Architeuthis-Flux/Jumperless/Hardware/Custom Breadboard/Images/Jumperless2boardOnFlipped.jpeg

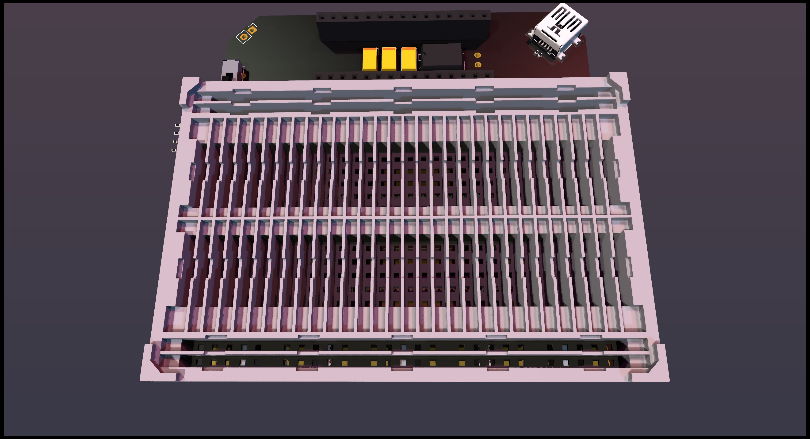
Hardware/Custom Breadboard/Images/Jumperless2boardOnFlipped.jpeg
