Architeuthis-Flux/Jumperless/Hardware/Custom Breadboard/Images/Jumperless2top.jpeg

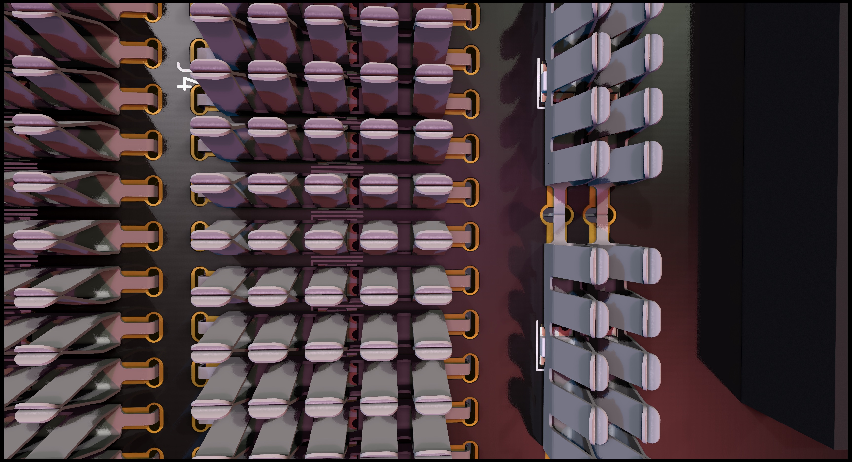
Hardware/Custom Breadboard/Images/Jumperless2top.jpeg
