Architeuthis-Flux/Jumperless/README.md

# Jumperless
### a jumperless breadboard

##### If you want one of these, they're available in [my Tindie store](https://www.tindie.com/products/architeuthisflux/jumperless/)

# There's now a way cooler version, [Jumperless V5](https://github.com/Architeuthis-Flux/JumperlessV5) 

#### You can get a V5 [on Crowd Supply](https://www.crowdsupply.com/architeuthis-flux/jumperless-v5)

## [Getting started using your Jumperless](https://hackaday.io/project/191238-jumperless/log/222858-getting-started-using-your-jumperless)
###### (at this point some of the stuff in that guide is a bit out of date, but generally is good advice)

Video (https://www.youtube.com/watch?v=_k0aKM68Xl4)

(You can click on this to watch the explainer video)

Using a bunch of analog crosspoint switches wired together into one bigger switch, this breadboard makes real, hardware connections between any points on the board or the Arduino Nano header at the top via software command, instead of needing to use jumper wires.

BreaboardJump00420

#### [3D Printable Stand](https://www.printables.com/model/684090-stand-for-the-jumperless-breadboard) (you can drop the model through the build plate to adjust the height)

#### [3D Printable Jumperless Trap](https://www.printables.com/model/1040448-jumperless-v1-3-case) (jk it's a carrying case, but make sure you can get it back open before you put your Jumperless in it)

Try this Wokwi project if something isn't working: https://wokwi.com/projects/389569655762010113

Here's an example of me using this thing to connect some I2C pins from an Arduino to an OLED

https://github.com/Architeuthis-Flux/Jumperless/assets/20519442/0da0fdcb-c629-4f16-8638-6fab5f5c69fc

Jumperless also has a ton of voltage/current sensing so the RGB LEDs underneath each row can show a ton of information about what's going on with your circuit. 2 buffered high-current DACs (one 0-5V and one ±8V), 4 buffered and level-shifted 12-bit ADCs (3 are 0-5V and 1 for ±8V), 2 INA219 current and voltage measurement ICs, and 4 GPIO to simulate digital or analog signals that can be routed to anywhere on the breadboard or the Arduino Nano header.

https://github.com/Architeuthis-Flux/Jumperless/assets/20519442/e701d5c8-2349-49a1-8d57-8574962e7c29

Use it to probe the pins on an unknown IC (which is what I'm doing in the video above), or for some automated fuzzing, or to help guide you through converting a schematic to a real circuit, or do whatever the hell you want with it. 

TxRx00097-Edit

The connections are real and fully analog (-8V to +8V, up to around 1 MHz before signal quality starts to degrade) instead of cheating with some measure-then-simulate setup, although you can do that too if you want to simulate a [memristor](https://en.wikipedia.org/wiki/Memristor) or to send jumpers over the internet.

https://github.com/Architeuthis-Flux/Jumperless/assets/20519442/2c203686-e02e-4a0c-b5eb-0cab925386fb

### If you want to read about how the code and stuff works, [the README in JumperlessNano](https://github.com/Architeuthis-Flux/Jumperless/tree/main/JumperlessNano) goes through how each part works in more detail.

### Or check out the [Hackaday.io page](https://hackaday.io/project/191238-jumperless) and the [Hackaday Blog Writeup](https://hackaday.com/2023/08/25/hackaday-prize-2023-jumperless-the-jumperless-jumperboard/)

And no, it's not an FPGA.



Schematic

Here it is running a 555 circuit (note that this is a Rev 1 without the through-PCB LEDs)

https://github.com/Architeuthis-Flux/Jumperless/assets/20519442/9c5d2b5a-3727-4197-b1d0-bd45b5f95559



Here are some fun bonus shots
RainBounceLarge

RandomLarge

https://github.com/Architeuthis-Flux/Jumperless/assets/20519442/b933e817-c6e4-4d97-9fc0-7b8d9e875ebb
[SchematicRevision3.pdf](https://github.com/Architeuthis-Flux/Jumperless/files/12603152/SchematicRevision3.pdf)


usage

https://github.com/Architeuthis-Flux/Jumperless/assets/20519442/d070d99d-b6b3-43e3-adee-4ca2d7358a9a
