Architeuthis-Flux/Jumperless/Hardware/Packaging/InsideBox575sm.pdf

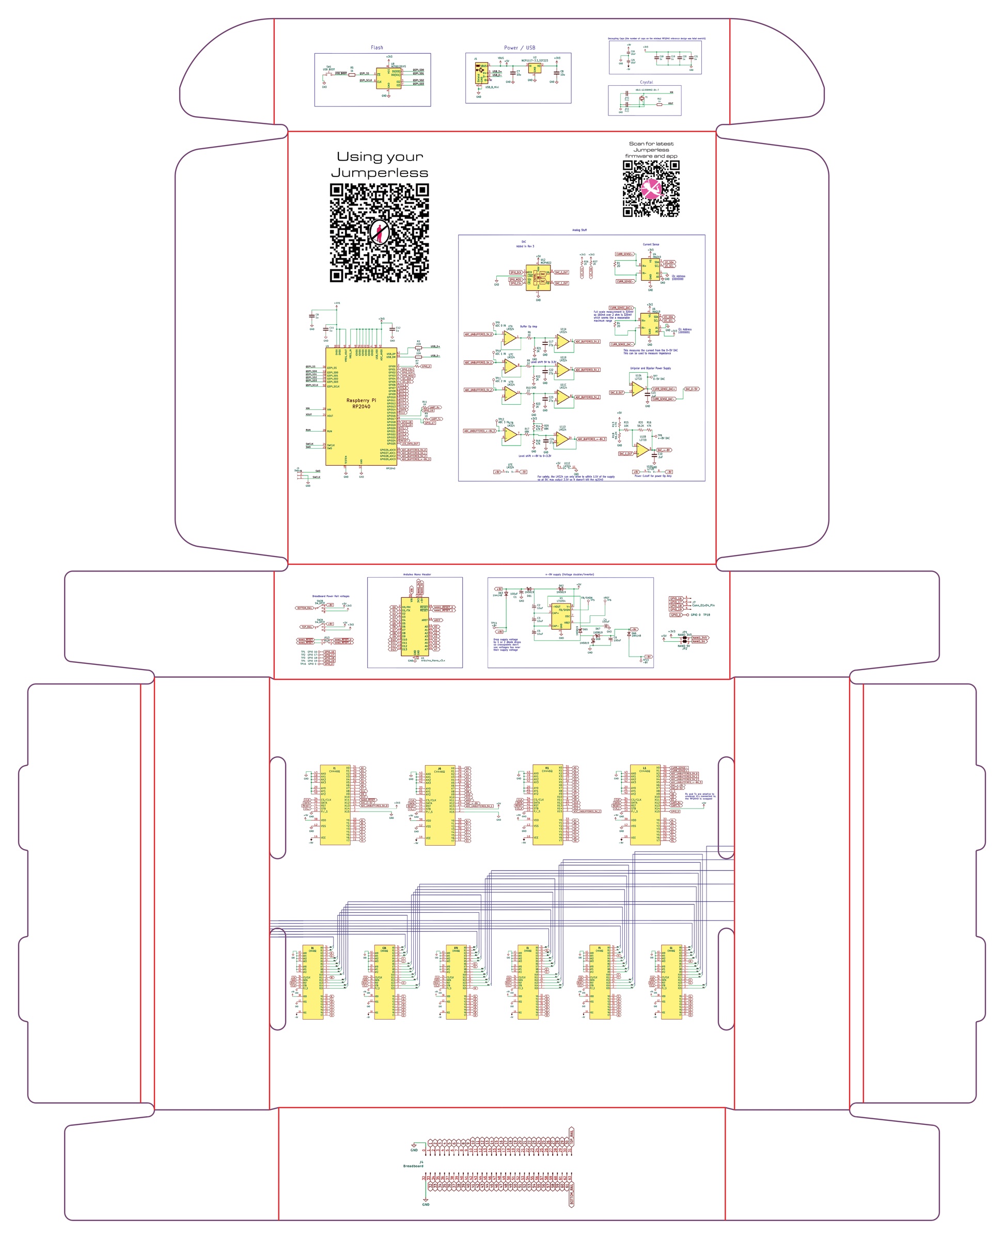
[picture p3: page 1]
