Architeuthis-Flux/Jumperless/Hardware/Packaging/outsideBox575sm.pdf

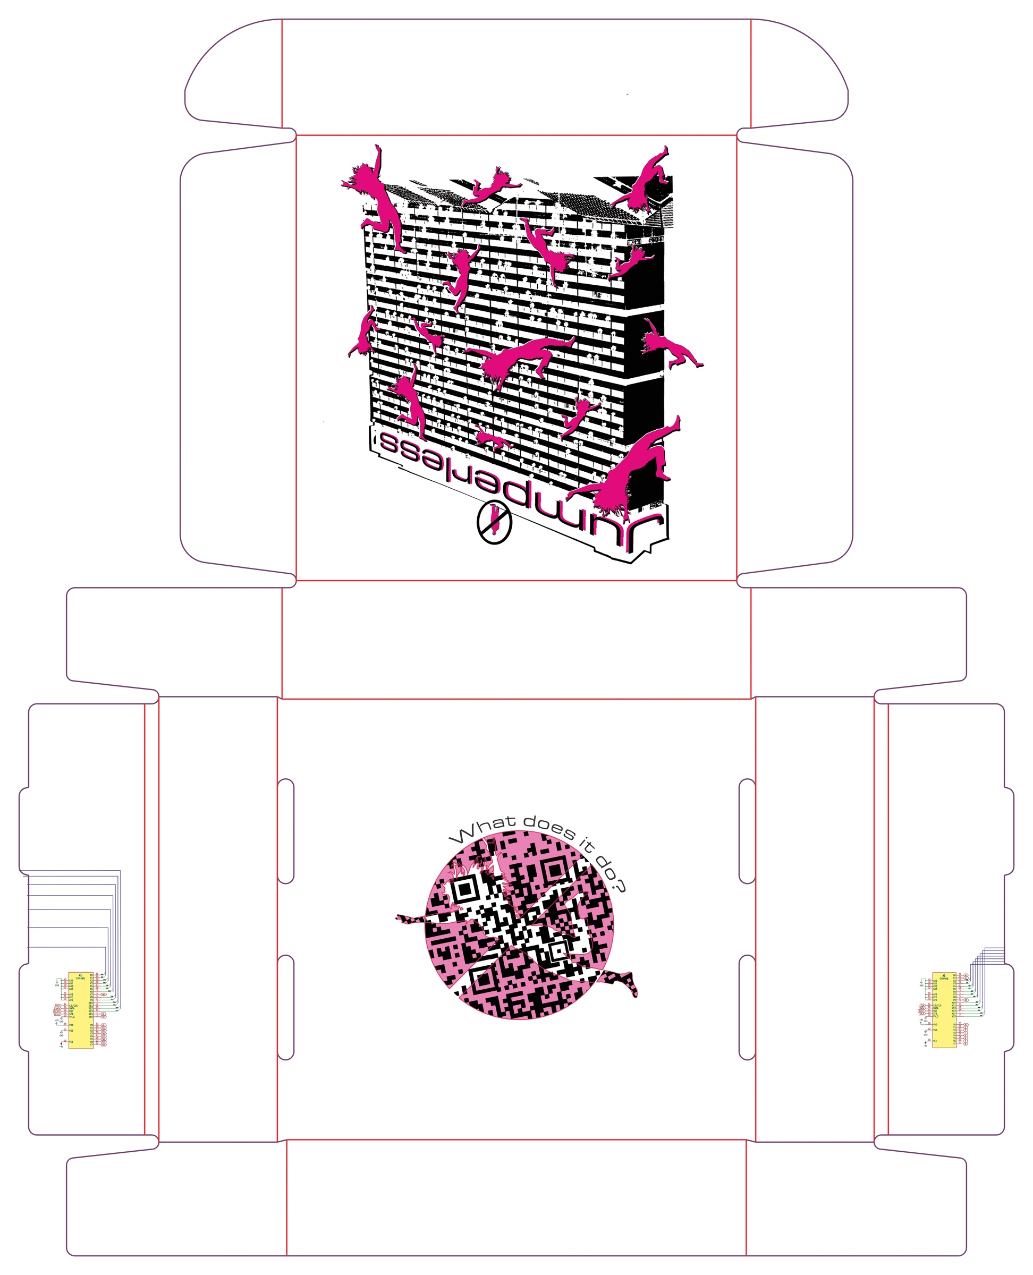
[picture p4: page 1]
