Architeuthis-Flux/Jumperless/Hardware/Custom Breadboard/Images/bbSimple v4 front.png

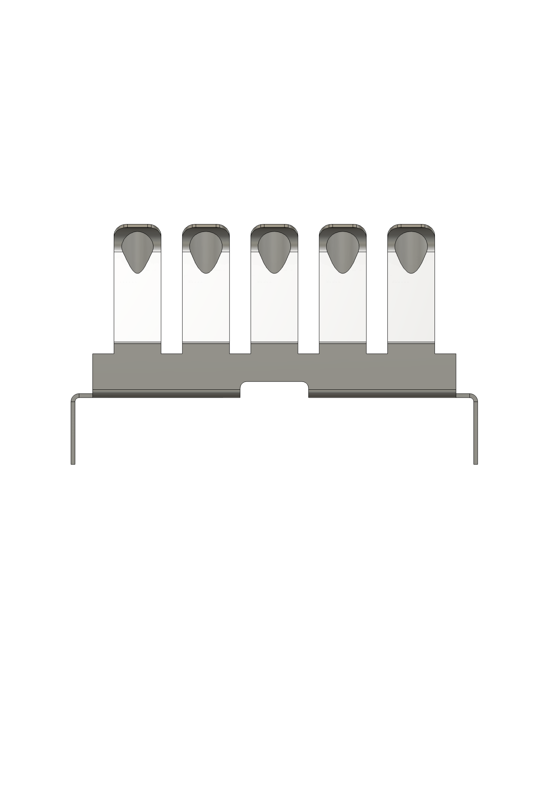
Hardware/Custom Breadboard/Images/bbSimple v4 front.png
