Architeuthis-Flux/Jumperless/Hardware/Custom Breadboard/Images/bbSimple v4 top.png

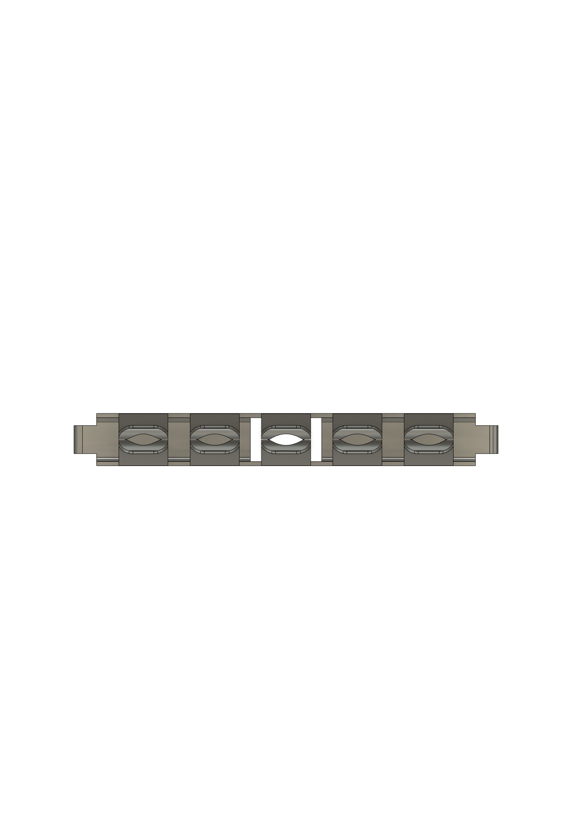
Hardware/Custom Breadboard/Images/bbSimple v4 top.png
