Architeuthis-Flux/Jumperless/Hardware/Custom Breadboard/Images/bbSimple v4.png

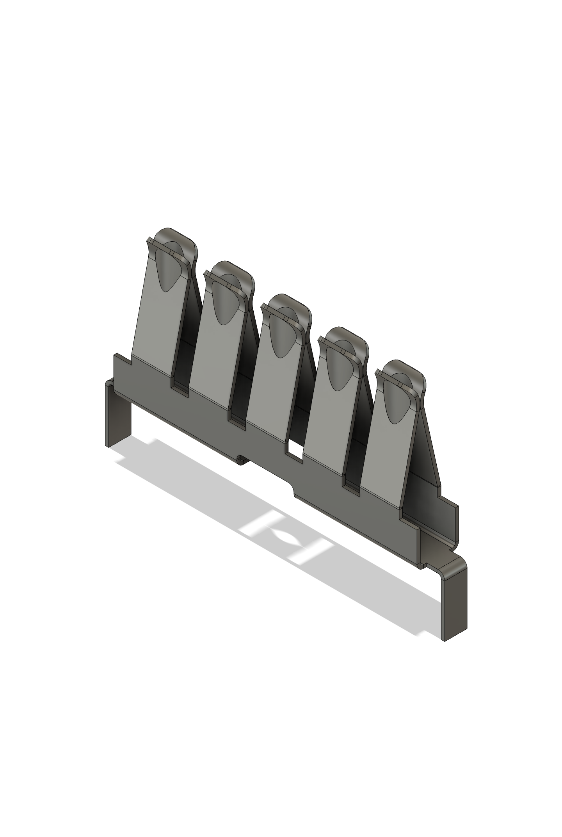
Hardware/Custom Breadboard/Images/bbSimple v4.png
