Architeuthis-Flux/Jumperless/Hardware/Custom Breadboard/Images/bbSimple v4right.png

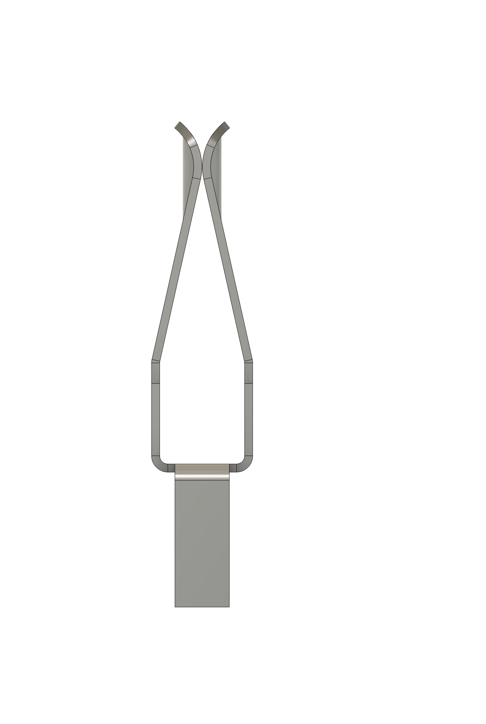
Hardware/Custom Breadboard/Images/bbSimple v4right.png
