Architeuthis-Flux/Jumperless/Hardware/Custom Breadboard/Images/Jumperless2.jpeg

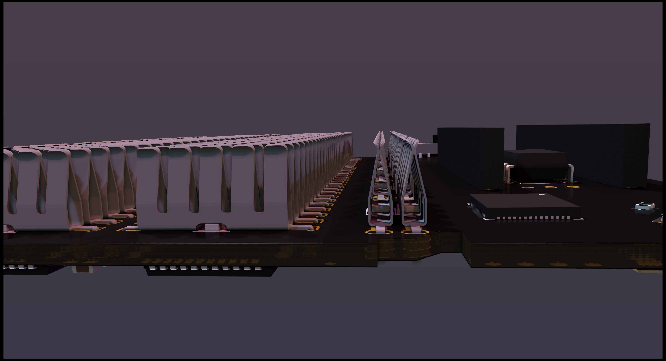
Hardware/Custom Breadboard/Images/Jumperless2.jpeg
