Architeuthis-Flux/Jumperless/Hardware/Custom Breadboard/Images/Jumperless2boardOn.jpeg

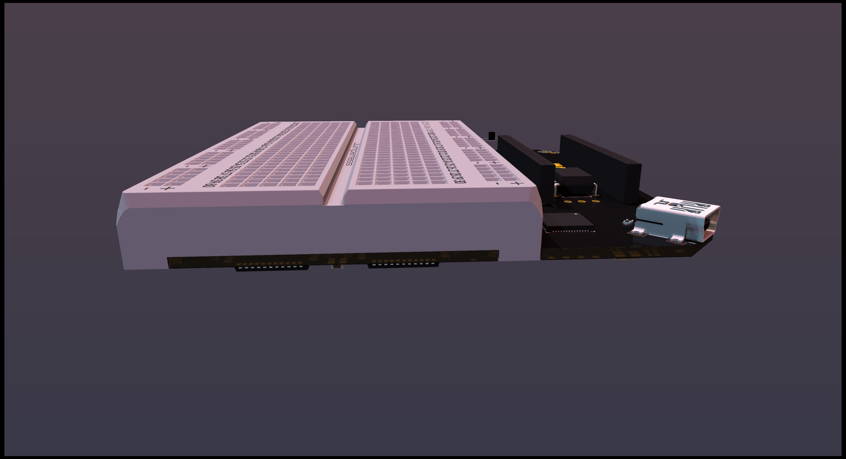
Hardware/Custom Breadboard/Images/Jumperless2boardOn.jpeg
