Architeuthis-Flux/Jumperless/Hardware/Rev3Plots/Main Board 3point1/PlacementBOMposNetlist/BackPlacement 2.png

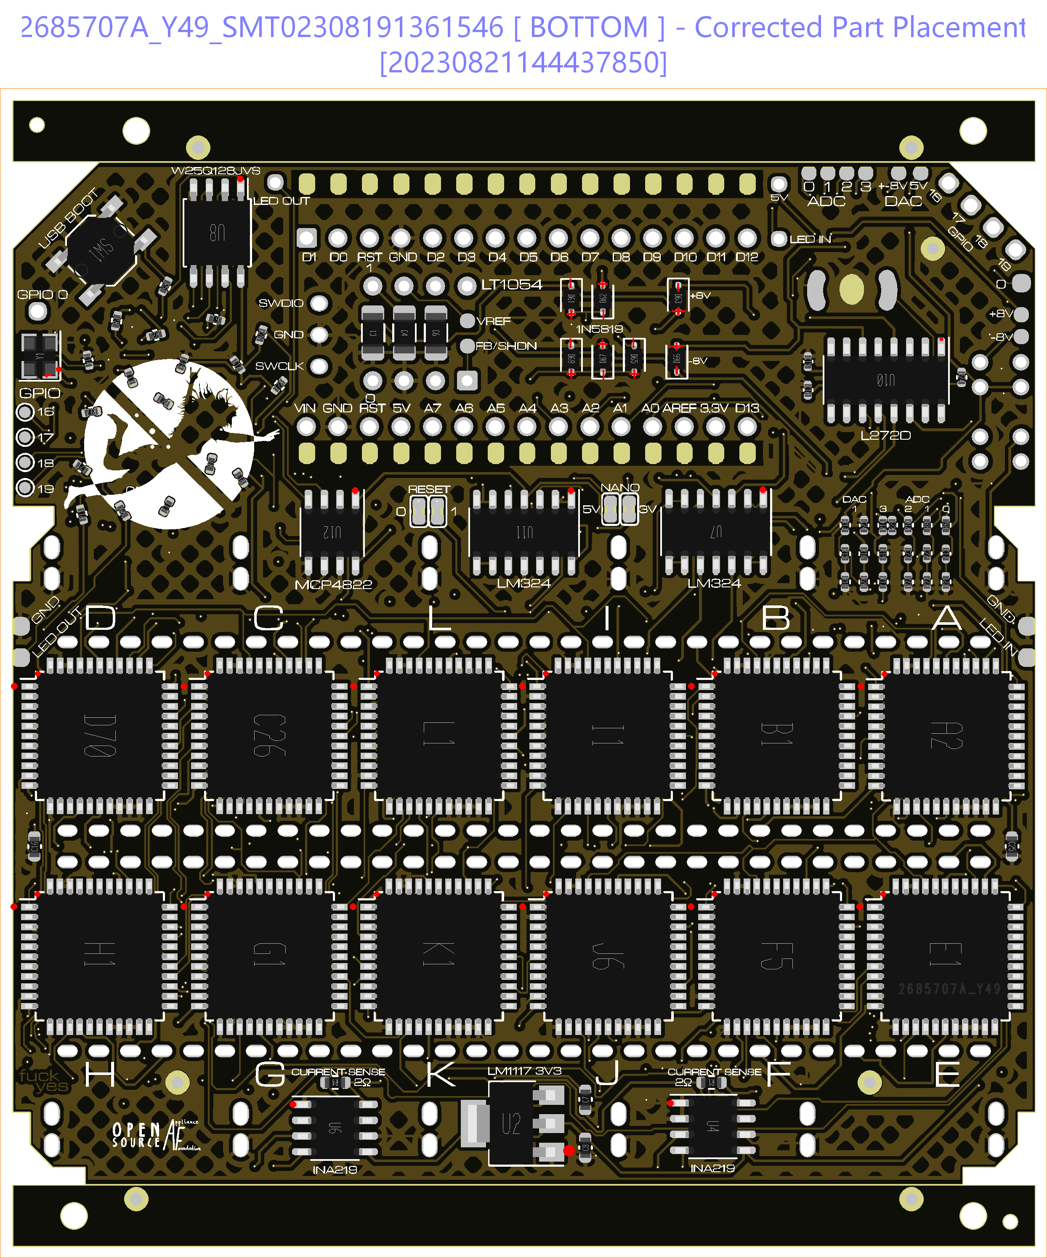
Hardware/Rev3Plots/Main Board 3point1/PlacementBOMposNetlist/BackPlacement 2.png
