Architeuthis-Flux/Jumperless/Hardware/KiCAD/LED Board Rev 3/LEDboardRev3.step

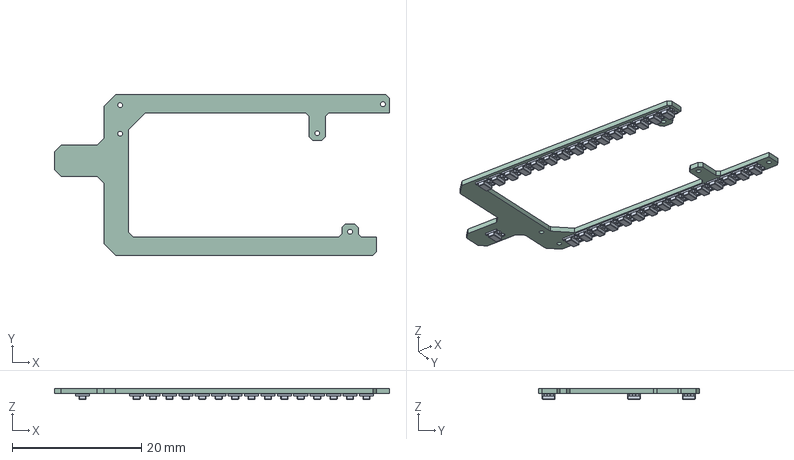
[picture p13: CAD file, 2023-06-24]
Hardware/KiCAD/LED Board Rev 3/LEDboardRev3.step
51.8 x 24.8 x 1.67 mm
_autosave-JumperlessLEDboard PCB
