Architeuthis-Flux/Jumperless/Hardware/KiCAD/Symbols and Footprints/3dmodels/bbSimple v8.step

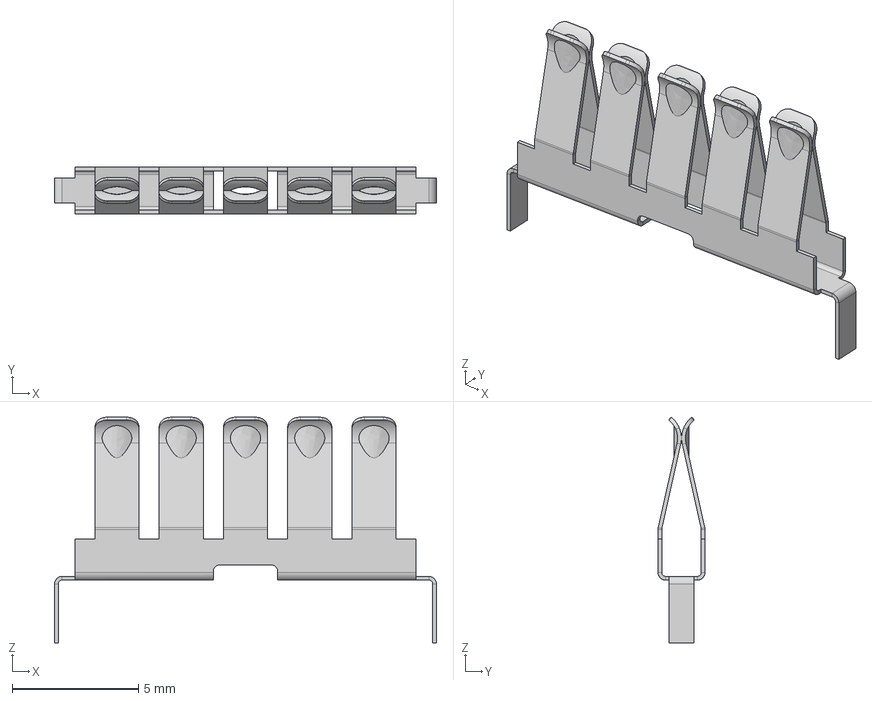
[picture p14: CAD file, 2024-02-24]
Hardware/KiCAD/Symbols and Footprints/3dmodels/bbSimple v8.step
15.1 x 1.86 x 8.92 mm
