Architeuthis-Flux/Jumperless/Hardware/Custom Breadboard/BBclipsNEW/bbSimple v20.step

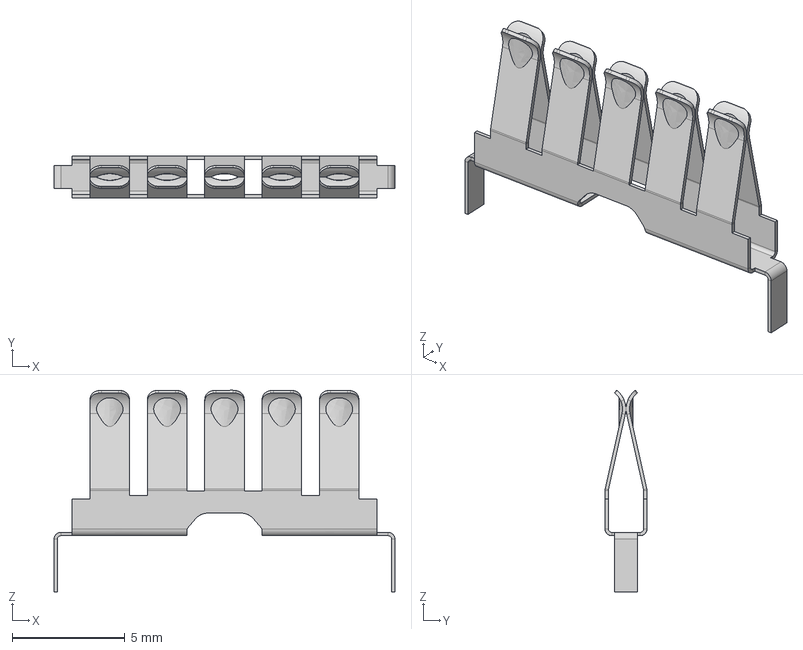
[picture p15: CAD file, 2023-06-24]
Hardware/Custom Breadboard/BBclipsNEW/bbSimple v20.step
15.1 x 1.86 x 8.92 mm
