Architeuthis-Flux/Jumperless/Hardware/KiCAD/Symbols and Footprints/3dmodels/SSSS223600.step

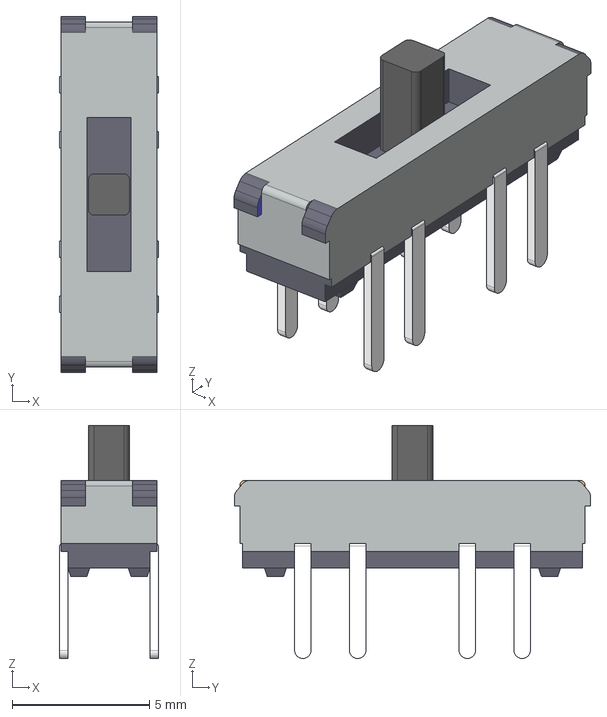
[picture p16: CAD file, 2024-02-24]
Hardware/KiCAD/Symbols and Footprints/3dmodels/SSSS223600.step
3.60 x 13.0 x 8.50 mm
