Architeuthis-Flux/Jumperless/Hardware/KiCAD/Symbols and Footprints/3dmodels/WS2812C-2020_Color.step

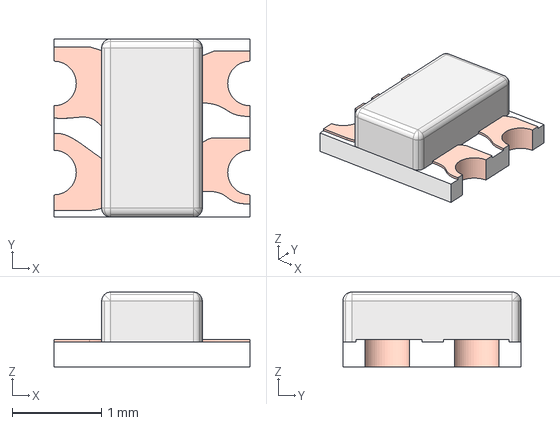
[picture p17: CAD file, 2024-02-24]
Hardware/KiCAD/Symbols and Footprints/3dmodels/WS2812C-2020_Color.step
2.20 x 2.00 x 0.84 mm
ws2812c-2020 v2.step
ws2812c-2020 v2
