Architeuthis-Flux/Jumperless/Hardware/KiCAD/Symbols and Footprints/3dmodels/PEC11R-4215F-S0024--3DModel-STEP-56544.STEP

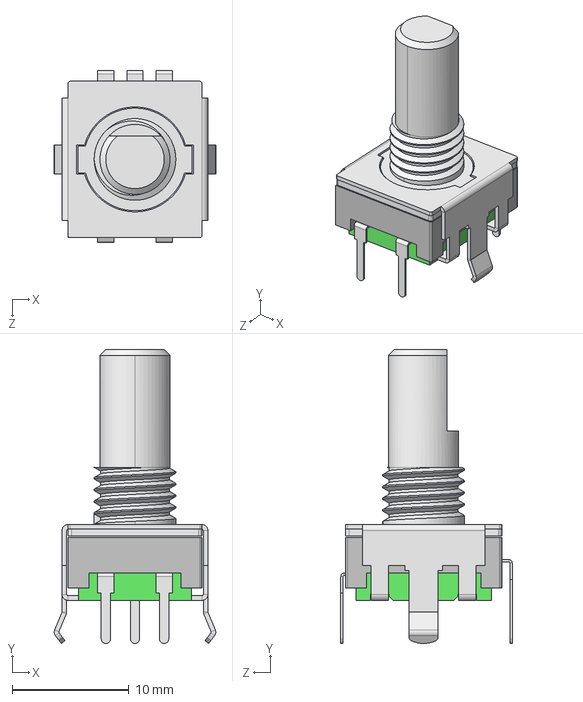
[picture p18: CAD file, 2024-02-24]
Hardware/KiCAD/Symbols and Footprints/3dmodels/PEC11R-4215F-S0024--3DModel-STEP-56544.STEP
13.9 x 25.2 x 14.7 mm
