Architeuthis-Flux/Jumperless/(list of files, cad)

Other CAD files:
Hardware/Custom Breadboard/BBclipsNEW/bbNew.dxf
Hardware/KiCAD/Symbols and Footprints/3dmodels/bbSimple v1.step
Hardware/Custom Breadboard/BBclipsNEW/bbSimple v20.stl
