Architeuthis-Flux/Jumperless/Jumperless_Wokwi_Bridge_App/Windows/pyInstallerscriptforWindows.txt

python3 -m PyInstaller --icon="icon.ico" -F -y --console --add-binary ""C:\Users\arabi\OneDrive\Desktop\JumperlessWokwiBridge2\windows\arduino-cli.exe";." JumperlessWokwiBridge.py
