Architeuthis-Flux/Jumperless/Jumperless_Wokwi_Bridge_App/JumperlessWokwiBridge/build/jumperlesswokwibridge/xref-jumperlesswokwibridge.html

# modulegraph cross reference for JumperlessWokwiBridge.py, pyi_rth_inspect.py, pyi_rth_multiprocessing.py, pyi_rth_pkgutil.py

JumperlessWokwiBridge.py Script

imports: _collections_abc • _weakrefset • abc • bs4 • codecs • collections • collections.abc • copyreg • encodings • encodings.aliases • encodings.ascii • encodings.base64_codec • encodings.big5 • encodings.big5hkscs • encodings.bz2_codec • encodings.charmap • encodings.cp037 • encodings.cp1006 • encodings.cp1026 • encodings.cp1125 • encodings.cp1140 • encodings.cp1250 • encodings.cp1251 • encodings.cp1252 • encodings.cp1253 • encodings.cp1254 • encodings.cp1255 • encodings.cp1256 • encodings.cp1257 • encodings.cp1258 • encodings.cp273 • encodings.cp424 • encodings.cp437 • encodings.cp500 • encodings.cp720 • encodings.cp737 • encodings.cp775 • encodings.cp850 • encodings.cp852 • encodings.cp855 • encodings.cp856 • encodings.cp857 • encodings.cp858 • encodings.cp860 • encodings.cp861 • encodings.cp862 • encodings.cp863 • encodings.cp864 • encodings.cp865 • encodings.cp866 • encodings.cp869 • encodings.cp874 • encodings.cp875 • encodings.cp932 • encodings.cp949 • encodings.cp950 • encodings.euc_jis_2004 • encodings.euc_jisx0213 • encodings.euc_jp • encodings.euc_kr • encodings.gb18030 • encodings.gb2312 • encodings.gbk • encodings.hex_codec • encodings.hp_roman8 • encodings.hz • encodings.idna • encodings.iso2022_jp • encodings.iso2022_jp_1 • encodings.iso2022_jp_2 • encodings.iso2022_jp_2004 • encodings.iso2022_jp_3 • encodings.iso2022_jp_ext • encodings.iso2022_kr • encodings.iso8859_1 • encodings.iso8859_10 • encodings.iso8859_11 • encodings.iso8859_13 • encodings.iso8859_14 • encodings.iso8859_15 • encodings.iso8859_16 • encodings.iso8859_2 • encodings.iso8859_3 • encodings.iso8859_4 • encodings.iso8859_5 • encodings.iso8859_6 • encodings.iso8859_7 • encodings.iso8859_8 • encodings.iso8859_9 • encodings.johab • encodings.koi8_r • encodings.koi8_t • encodings.koi8_u • encodings.kz1048 • encodings.latin_1 • encodings.mac_arabic • encodings.mac_croatian • encodings.mac_cyrillic • encodings.mac_farsi • encodings.mac_greek • encodings.mac_iceland • encodings.mac_latin2 • encodings.mac_roman • encodings.mac_romanian • encodings.mac_turkish • encodings.mbcs • encodings.oem • encodings.palmos • encodings.ptcp154 • encodings.punycode • encodings.quopri_codec • encodings.raw_unicode_escape • encodings.rot_13 • encodings.shift_jis • encodings.shift_jis_2004 • encodings.shift_jisx0213 • encodings.tis_620 • encodings.undefined • encodings.unicode_escape • encodings.utf_16 • encodings.utf_16_be • encodings.utf_16_le • encodings.utf_32 • encodings.utf_32_be • encodings.utf_32_le • encodings.utf_7 • encodings.utf_8 • encodings.utf_8_sig • encodings.uu_codec • encodings.zlib_codec • enum • fnmatch • functools • genericpath • heapq • io • ipaddress • json • keyword • linecache • locale • ntpath • operator • os • pathlib • posixpath • psutil • pyduinocli • pyi_rth_inspect.py • pyi_rth_multiprocessing.py • pyi_rth_pkgutil.py • re • re._casefix • re._compiler • re._constants • re._parser • reprlib • requests • serial • serial.tools.list_ports • shutil • sre_compile • sre_constants • sre_parse • stat • sys • threading • time • token • tokenize • traceback • types • urllib • urllib.error • urllib.parse • urllib.request • urllib.response • urllib.robotparser • warnings • weakref

pyi_rth_inspect.py Script

imports: inspect • os • sys

imported by: JumperlessWokwiBridge.py

pyi_rth_multiprocessing.py Script

imports: multiprocessing • multiprocessing.popen_forkserver • multiprocessing.popen_spawn_posix • multiprocessing.popen_spawn_win32 • multiprocessing.spawn • os • subprocess • sys • threading

imported by: JumperlessWokwiBridge.py

pyi_rth_pkgutil.py Script

imports: os • pkgutil • pyimod02_importers • sys

imported by: JumperlessWokwiBridge.py

'OpenSSL.crypto' MissingModule

imported by: urllib3.contrib.pyopenssl

'System.IO' MissingModule

imported by: serial.serialcli

'cryptography.x509' MissingModule

imported by: urllib3.contrib.pyopenssl

'html5lib.constants' MissingModule

imported by: bs4.builder._html5lib

'html5lib.treebuilders' MissingModule

imported by: bs4.builder._html5lib • lxml.html._html5builder • lxml.html.html5parser

'java.lang' MissingModule

imported by: platform • xml.sax._exceptions

'org.python' MissingModule

imported by: pickle • xml.sax

BeautifulSoup MissingModule

imported by: lxml.html.soupparser

OpenSSL MissingModule

imported by: urllib3.contrib.pyopenssl

System MissingModule

imported by: serial.serialcli

__future__ SourceModule

imported by: codeop • doctest • lxml.cssselect • lxml.html • lxml.html._diffcommand • psutil • psutil._common • psutil._pslinux • pydoc • serial • serial.serialcli • serial.serialjava • serial.serialposix • serial.serialutil • serial.serialwin32 • serial.tools.list_ports • serial.tools.list_ports_common • serial.tools.list_ports_linux • serial.tools.list_ports_osx • serial.tools.list_ports_posix • serial.tools.list_ports_windows • serial.win32 • soupsieve • soupsieve.__meta__ • soupsieve.css_match • soupsieve.css_parser • soupsieve.css_types • soupsieve.pretty • soupsieve.util • urllib3 • urllib3._base_connection • urllib3._collections • urllib3._request_methods • urllib3._version • urllib3.connection • urllib3.connectionpool • urllib3.contrib.pyopenssl • urllib3.contrib.socks • urllib3.exceptions • urllib3.fields • urllib3.filepost • urllib3.poolmanager • urllib3.response • urllib3.util • urllib3.util.connection • urllib3.util.proxy • urllib3.util.request • urllib3.util.response • urllib3.util.retry • urllib3.util.ssl_ • urllib3.util.ssl_match_hostname • urllib3.util.ssltransport • urllib3.util.timeout • urllib3.util.url • urllib3.util.util • urllib3.util.wait

_abc (builtin module)

imported by: abc

_aix_support SourceModule

imports: _bootsubprocess • subprocess • sys • sysconfig

imported by: sysconfig

_ast (builtin module)

imported by: ast

_asyncio /Library/Frameworks/Python.framework/Versions/3.11/lib/python3.11/lib-dynload/_asyncio.cpython-311-darwin.so

imported by: asyncio.events • asyncio.futures • asyncio.tasks

_bisect /Library/Frameworks/Python.framework/Versions/3.11/lib/python3.11/lib-dynload/_bisect.cpython-311-darwin.so

imported by: bisect

_blake2 /Library/Frameworks/Python.framework/Versions/3.11/lib/python3.11/lib-dynload/_blake2.cpython-311-darwin.so

imported by: hashlib

_bootsubprocess SourceModule

imports: os

imported by: _aix_support

_bz2 /Library/Frameworks/Python.framework/Versions/3.11/lib/python3.11/lib-dynload/_bz2.cpython-311-darwin.so

imported by: bz2

_codecs (builtin module)

imported by: codecs

_codecs_cn /Library/Frameworks/Python.framework/Versions/3.11/lib/python3.11/lib-dynload/_codecs_cn.cpython-311-darwin.so

imported by: encodings.gb18030 • encodings.gb2312 • encodings.gbk • encodings.hz

_codecs_hk /Library/Frameworks/Python.framework/Versions/3.11/lib/python3.11/lib-dynload/_codecs_hk.cpython-311-darwin.so

imported by: encodings.big5hkscs

_codecs_iso2022 /Library/Frameworks/Python.framework/Versions/3.11/lib/python3.11/lib-dynload/_codecs_iso2022.cpython-311-darwin.so

imported by: encodings.iso2022_jp • encodings.iso2022_jp_1 • encodings.iso2022_jp_2 • encodings.iso2022_jp_2004 • encodings.iso2022_jp_3 • encodings.iso2022_jp_ext • encodings.iso2022_kr

_codecs_jp /Library/Frameworks/Python.framework/Versions/3.11/lib/python3.11/lib-dynload/_codecs_jp.cpython-311-darwin.so

imported by: encodings.cp932 • encodings.euc_jis_2004 • encodings.euc_jisx0213 • encodings.euc_jp • encodings.shift_jis • encodings.shift_jis_2004 • encodings.shift_jisx0213

_codecs_kr /Library/Frameworks/Python.framework/Versions/3.11/lib/python3.11/lib-dynload/_codecs_kr.cpython-311-darwin.so

imported by: encodings.cp949 • encodings.euc_kr • encodings.johab

_codecs_tw /Library/Frameworks/Python.framework/Versions/3.11/lib/python3.11/lib-dynload/_codecs_tw.cpython-311-darwin.so

imported by: encodings.big5 • encodings.cp950

_collections (builtin module)

imported by: collections • threading

_collections_abc SourceModule

imports: abc • sys

imported by: JumperlessWokwiBridge.py • collections • collections.abc • contextlib • locale • os • pathlib • random • types • weakref

_compat_pickle SourceModule

imported by: _pickle • pickle

_compression SourceModule

imports: io • sys

imported by: bz2 • gzip • lzma

_contextvars /Library/Frameworks/Python.framework/Versions/3.11/lib/python3.11/lib-dynload/_contextvars.cpython-311-darwin.so

imported by: contextvars

_csv /Library/Frameworks/Python.framework/Versions/3.11/lib/python3.11/lib-dynload/_csv.cpython-311-darwin.so

imported by: csv

_ctypes /Library/Frameworks/Python.framework/Versions/3.11/lib/python3.11/lib-dynload/_ctypes.cpython-311-darwin.so

imported by: ctypes

_curses /Library/Frameworks/Python.framework/Versions/3.11/lib/python3.11/lib-dynload/_curses.cpython-311-darwin.so

imports: curses

imported by: curses • curses.has_key

_datetime /Library/Frameworks/Python.framework/Versions/3.11/lib/python3.11/lib-dynload/_datetime.cpython-311-darwin.so

imports: _strptime • time

imported by: datetime

_decimal /Library/Frameworks/Python.framework/Versions/3.11/lib/python3.11/lib-dynload/_decimal.cpython-311-darwin.so

imported by: decimal

_elementtree /Library/Frameworks/Python.framework/Versions/3.11/lib/python3.11/lib-dynload/_elementtree.cpython-311-darwin.so

imports: pyexpat • xml.etree.ElementInclude • xml.etree.ElementPath • xml.etree.ElementTree • xml.etree.cElementTree

imported by: xml.etree.ElementTree

_frozen_importlib ExcludedModule

imported by: importlib • importlib.abc • zipimport

_frozen_importlib_external MissingModule

imported by: importlib • importlib._bootstrap • importlib.abc • zipimport

_functools (builtin module)

imported by: functools

_hashlib /Library/Frameworks/Python.framework/Versions/3.11/lib/python3.11/lib-dynload/_hashlib.cpython-311-darwin.so

imported by: hashlib • hmac

_heapq /Library/Frameworks/Python.framework/Versions/3.11/lib/python3.11/lib-dynload/_heapq.cpython-311-darwin.so

imported by: heapq

_imp (builtin module)

imported by: importlib • importlib._bootstrap_external • importlib.util • sysconfig • zipimport

_io (builtin module)

imported by: importlib._bootstrap_external • io • zipimport

_json /Library/Frameworks/Python.framework/Versions/3.11/lib/python3.11/lib-dynload/_json.cpython-311-darwin.so

imports: json.decoder

imported by: json.decoder • json.encoder • json.scanner

_locale (builtin module)

imported by: locale

_lzma /Library/Frameworks/Python.framework/Versions/3.11/lib/python3.11/lib-dynload/_lzma.cpython-311-darwin.so

imported by: lzma

_markupbase SourceModule

imports: re

imported by: html.parser

_md5 /Library/Frameworks/Python.framework/Versions/3.11/lib/python3.11/lib-dynload/_md5.cpython-311-darwin.so

imported by: hashlib

_multibytecodec /Library/Frameworks/Python.framework/Versions/3.11/lib/python3.11/lib-dynload/_multibytecodec.cpython-311-darwin.so

imported by: charset_normalizer.utils • encodings.big5 • encodings.big5hkscs • encodings.cp932 • encodings.cp949 • encodings.cp950 • encodings.euc_jis_2004 • encodings.euc_jisx0213 • encodings.euc_jp • encodings.euc_kr • encodings.gb18030 • encodings.gb2312 • encodings.gbk • encodings.hz • encodings.iso2022_jp • encodings.iso2022_jp_1 • encodings.iso2022_jp_2 • encodings.iso2022_jp_2004 • encodings.iso2022_jp_3 • encodings.iso2022_jp_ext • encodings.iso2022_kr • encodings.johab • encodings.shift_jis • encodings.shift_jis_2004 • encodings.shift_jisx0213

_multiprocessing /Library/Frameworks/Python.framework/Versions/3.11/lib/python3.11/lib-dynload/_multiprocessing.cpython-311-darwin.so

imported by: multiprocessing.connection • multiprocessing.queues • multiprocessing.resource_tracker • multiprocessing.synchronize

_opcode /Library/Frameworks/Python.framework/Versions/3.11/lib/python3.11/lib-dynload/_opcode.cpython-311-darwin.so

imported by: opcode

_operator (builtin module)

imported by: hmac • operator

_osx_support SourceModule

imports: contextlib • os • re • sys • tempfile

imported by: sysconfig

_overlapped MissingModule

imported by: asyncio.windows_events

_pickle /Library/Frameworks/Python.framework/Versions/3.11/lib/python3.11/lib-dynload/_pickle.cpython-311-darwin.so

imports: _compat_pickle • codecs • copyreg

imported by: pickle

_posixshmem /Library/Frameworks/Python.framework/Versions/3.11/lib/python3.11/lib-dynload/_posixshmem.cpython-311-darwin.so

imported by: multiprocessing.resource_tracker • multiprocessing.shared_memory

_posixsubprocess /Library/Frameworks/Python.framework/Versions/3.11/lib/python3.11/lib-dynload/_posixsubprocess.cpython-311-darwin.so

imports: gc

imported by: multiprocessing.util • subprocess

_psutil_windows MissingModule

imported by: psutil._pswindows

_py_abc SourceModule

imports: _weakrefset

imported by: abc

_pydecimal SourceModule

imports: collections • contextvars • itertools • locale • math • numbers • re • sys

imported by: decimal

_queue /Library/Frameworks/Python.framework/Versions/3.11/lib/python3.11/lib-dynload/_queue.cpython-311-darwin.so

imported by: queue

_random /Library/Frameworks/Python.framework/Versions/3.11/lib/python3.11/lib-dynload/_random.cpython-311-darwin.so

imported by: random

_scproxy /Library/Frameworks/Python.framework/Versions/3.11/lib/python3.11/lib-dynload/_scproxy.cpython-311-darwin.so

imported by: urllib.request

_sha1 /Library/Frameworks/Python.framework/Versions/3.11/lib/python3.11/lib-dynload/_sha1.cpython-311-darwin.so

imported by: hashlib

_sha256 /Library/Frameworks/Python.framework/Versions/3.11/lib/python3.11/lib-dynload/_sha256.cpython-311-darwin.so

imported by: hashlib

_sha3 /Library/Frameworks/Python.framework/Versions/3.11/lib/python3.11/lib-dynload/_sha3.cpython-311-darwin.so

imported by: hashlib

_sha512 /Library/Frameworks/Python.framework/Versions/3.11/lib/python3.11/lib-dynload/_sha512.cpython-311-darwin.so

imported by: hashlib • random

_signal (builtin module)

imported by: signal

_socket /Library/Frameworks/Python.framework/Versions/3.11/lib/python3.11/lib-dynload/_socket.cpython-311-darwin.so

imported by: socket

_sre (builtin module)

imports: copy • re

imported by: re._compiler • re._constants

_ssl /Library/Frameworks/Python.framework/Versions/3.11/lib/python3.11/lib-dynload/_ssl.cpython-311-darwin.so

imports: socket

imported by: ssl

_stat (builtin module)

imported by: stat

_statistics /Library/Frameworks/Python.framework/Versions/3.11/lib/python3.11/lib-dynload/_statistics.cpython-311-darwin.so

imported by: statistics

_string (builtin module)

imported by: string

_strptime SourceModule

imports: _thread • calendar • datetime • locale • re • time

imported by: _datetime • datetime • time

_struct /Library/Frameworks/Python.framework/Versions/3.11/lib/python3.11/lib-dynload/_struct.cpython-311-darwin.so

imported by: struct

_sysconfigdata__darwin_darwin SourceModule

imported by: sysconfig

_thread (builtin module)

imported by: _strptime • asyncio.base_futures • dataclasses • functools • reprlib • tempfile • threading

_threading_local SourceModule

imports: contextlib • threading • weakref

imported by: threading

_tokenize (builtin module)

imported by: tokenize

_tracemalloc (builtin module)

imported by: tracemalloc

_typing /Library/Frameworks/Python.framework/Versions/3.11/lib/python3.11/lib-dynload/_typing.cpython-311-darwin.so

imported by: typing

_warnings (builtin module)

imported by: importlib._bootstrap_external • warnings • zipimport

_weakref (builtin module)

imported by: _weakrefset • collections • weakref • xml.sax.expatreader

_weakrefset SourceModule

imports: _weakref • types

imported by: JumperlessWokwiBridge.py • _py_abc • multiprocessing.process • threading • weakref

_winapi MissingModule

imported by: asyncio.windows_events • asyncio.windows_utils • encodings • mimetypes • multiprocessing.connection • multiprocessing.heap • multiprocessing.popen_spawn_win32 • multiprocessing.reduction • multiprocessing.shared_memory • multiprocessing.spawn • ntpath • subprocess

_winreg MissingModule

imported by: platform

abc SourceModule

imports: _abc • _py_abc

imported by: JumperlessWokwiBridge.py • _collections_abc • contextlib • dataclasses • email._policybase • functools • importlib._abc • importlib.abc • importlib.metadata • importlib.resources.abc • inspect • io • multiprocessing.reduction • numbers • os • selectors • typing • typing_extensions

argparse SourceModule

imports: copy • gettext • os • re • shutil • sys • textwrap • warnings

imported by: ast • calendar • code • dis • doctest • gzip • http.server • inspect • py_compile • serial.tools.list_ports • tarfile • tokenize • unittest.main • zipfile

array /Library/Frameworks/Python.framework/Versions/3.11/lib/python3.11/lib-dynload/array.cpython-311-darwin.so

imported by: multiprocessing.dummy • multiprocessing.managers • multiprocessing.reduction • serial.serialposix • serial.serialutil • socket

ast SourceModule

imports: _ast • argparse • collections • contextlib • enum • inspect • sys • warnings

imported by: inspect • traceback

asyncio Package

imports: asyncio • asyncio.DefaultEventLoopPolicy • asyncio.base_events • asyncio.base_futures • asyncio.base_subprocess • asyncio.base_tasks • asyncio.constants • asyncio.coroutines • asyncio.events • asyncio.exceptions • asyncio.format_helpers • asyncio.futures • asyncio.locks • asyncio.mixins • asyncio.proactor_events • asyncio.protocols • asyncio.queues • asyncio.runners • asyncio.selector_events • asyncio.sslproto • asyncio.staggered • asyncio.streams • asyncio.subprocess • asyncio.taskgroups • asyncio.tasks • asyncio.threads • asyncio.timeouts • asyncio.transports • asyncio.trsock • asyncio.unix_events • asyncio.windows_events • asyncio.windows_utils • sys

imported by: asyncio • asyncio.base_events • asyncio.base_futures • asyncio.base_subprocess • asyncio.base_tasks • asyncio.constants • asyncio.coroutines • asyncio.events • asyncio.exceptions • asyncio.format_helpers • asyncio.futures • asyncio.locks • asyncio.log • asyncio.mixins • asyncio.proactor_events • asyncio.protocols • asyncio.queues • asyncio.runners • asyncio.selector_events • asyncio.sslproto • asyncio.staggered • asyncio.streams • asyncio.subprocess • asyncio.taskgroups • asyncio.tasks • asyncio.threads • asyncio.timeouts • asyncio.transports • asyncio.trsock • asyncio.unix_events • asyncio.windows_events • asyncio.windows_utils • unittest.async_case

asyncio.DefaultEventLoopPolicy MissingModule

imported by: asyncio • asyncio.events

asyncio.base_events SourceModule

imports: asyncio • asyncio.constants • asyncio.coroutines • asyncio.events • asyncio.exceptions • asyncio.futures • asyncio.log • asyncio.protocols • asyncio.sslproto • asyncio.staggered • asyncio.tasks • asyncio.transports • asyncio.trsock • collections • collections.abc • concurrent.futures • functools • heapq • itertools • os • socket • ssl • stat • subprocess • sys • threading • time • traceback • warnings • weakref

imported by: asyncio • asyncio.proactor_events • asyncio.selector_events • asyncio.unix_events

asyncio.base_futures SourceModule

imports: _thread • asyncio • asyncio.format_helpers • reprlib

imported by: asyncio • asyncio.base_tasks • asyncio.futures

asyncio.base_subprocess SourceModule

imports: asyncio • asyncio.log • asyncio.protocols • asyncio.transports • collections • subprocess • warnings

imported by: asyncio • asyncio.unix_events • asyncio.windows_events

asyncio.base_tasks SourceModule

imports: asyncio • asyncio.base_futures • asyncio.coroutines • linecache • reprlib • traceback

imported by: asyncio • asyncio.tasks

asyncio.constants SourceModule

imports: asyncio • enum

imported by: asyncio • asyncio.base_events • asyncio.format_helpers • asyncio.proactor_events • asyncio.selector_events • asyncio.sslproto • asyncio.unix_events

asyncio.coroutines SourceModule

imports: asyncio • collections.abc • inspect • os • sys • traceback • types

imported by: asyncio • asyncio.base_events • asyncio.base_tasks • asyncio.runners • asyncio.streams • asyncio.tasks • asyncio.unix_events

asyncio.events SourceModule

imports: _asyncio • asyncio • asyncio.DefaultEventLoopPolicy • asyncio.format_helpers • contextvars • os • socket • subprocess • sys • threading

imported by: asyncio • asyncio.base_events • asyncio.futures • asyncio.mixins • asyncio.runners • asyncio.selector_events • asyncio.staggered • asyncio.streams • asyncio.subprocess • asyncio.taskgroups • asyncio.tasks • asyncio.threads • asyncio.timeouts • asyncio.unix_events • asyncio.windows_events

asyncio.exceptions SourceModule

imports: asyncio

imported by: asyncio • asyncio.base_events • asyncio.futures • asyncio.locks • asyncio.proactor_events • asyncio.runners • asyncio.sslproto • asyncio.staggered • asyncio.streams • asyncio.taskgroups • asyncio.tasks • asyncio.timeouts • asyncio.unix_events • asyncio.windows_events

asyncio.format_helpers SourceModule

imports: asyncio • asyncio.constants • functools • inspect • reprlib • sys • traceback

imported by: asyncio • asyncio.base_futures • asyncio.events • asyncio.futures • asyncio.streams

asyncio.futures SourceModule

imports: _asyncio • asyncio • asyncio.base_futures • asyncio.events • asyncio.exceptions • asyncio.format_helpers • concurrent.futures • contextvars • logging • sys • types

imported by: asyncio • asyncio.base_events • asyncio.proactor_events • asyncio.selector_events • asyncio.tasks • asyncio.unix_events • asyncio.windows_events

asyncio.locks SourceModule

imports: asyncio • asyncio.exceptions • asyncio.mixins • asyncio.tasks • collections • enum

imported by: asyncio • asyncio.queues • asyncio.staggered

asyncio.log SourceModule

imports: asyncio • logging

imported by: asyncio.base_events • asyncio.base_subprocess • asyncio.proactor_events • asyncio.selector_events • asyncio.sslproto • asyncio.streams • asyncio.subprocess • asyncio.unix_events • asyncio.windows_events

asyncio.mixins SourceModule

imports: asyncio • asyncio.events • threading

imported by: asyncio • asyncio.locks • asyncio.queues

asyncio.proactor_events SourceModule

imports: asyncio • asyncio.base_events • asyncio.constants • asyncio.exceptions • asyncio.futures • asyncio.log • asyncio.protocols • asyncio.sslproto • asyncio.transports • asyncio.trsock • collections • io • os • signal • socket • threading • warnings

imported by: asyncio • asyncio.windows_events

asyncio.protocols SourceModule

imports: asyncio

imported by: asyncio • asyncio.base_events • asyncio.base_subprocess • asyncio.proactor_events • asyncio.selector_events • asyncio.sslproto • asyncio.streams • asyncio.subprocess

asyncio.queues SourceModule

imports: asyncio • asyncio.locks • asyncio.mixins • collections • heapq • types

imported by: asyncio • asyncio.tasks

asyncio.runners SourceModule

imports: asyncio • asyncio.coroutines • asyncio.events • asyncio.exceptions • asyncio.tasks • contextvars • enum • functools • signal • sys • threading

imported by: asyncio

asyncio.selector_events SourceModule

imports: asyncio • asyncio.base_events • asyncio.constants • asyncio.events • asyncio.futures • asyncio.log • asyncio.protocols • asyncio.sslproto • asyncio.transports • asyncio.trsock • collections • errno • functools • selectors • socket • ssl • warnings • weakref

imported by: asyncio • asyncio.unix_events • asyncio.windows_events

asyncio.sslproto SourceModule

imports: asyncio • asyncio.constants • asyncio.exceptions • asyncio.log • asyncio.protocols • asyncio.transports • collections • enum • ssl • warnings

imported by: asyncio • asyncio.base_events • asyncio.proactor_events • asyncio.selector_events

asyncio.staggered SourceModule

imports: asyncio • asyncio.events • asyncio.exceptions • asyncio.locks • asyncio.tasks • contextlib • typing

imported by: asyncio • asyncio.base_events

asyncio.streams SourceModule

imports: asyncio • asyncio.coroutines • asyncio.events • asyncio.exceptions • asyncio.format_helpers • asyncio.log • asyncio.protocols • asyncio.tasks • collections • socket • sys • warnings • weakref

imported by: asyncio • asyncio.subprocess

asyncio.subprocess SourceModule

imports: asyncio • asyncio.events • asyncio.log • asyncio.protocols • asyncio.streams • asyncio.tasks • subprocess

imported by: asyncio

asyncio.taskgroups SourceModule

imports: asyncio • asyncio.events • asyncio.exceptions • asyncio.tasks

imported by: asyncio

asyncio.tasks SourceModule

imports: _asyncio • asyncio • asyncio.base_tasks • asyncio.coroutines • asyncio.events • asyncio.exceptions • asyncio.futures • asyncio.queues • concurrent.futures • contextvars • functools • inspect • itertools • types • warnings • weakref

imported by: asyncio • asyncio.base_events • asyncio.locks • asyncio.runners • asyncio.staggered • asyncio.streams • asyncio.subprocess • asyncio.taskgroups • asyncio.timeouts • asyncio.unix_events • asyncio.windows_events

asyncio.threads SourceModule

imports: asyncio • asyncio.events • contextvars • functools

imported by: asyncio

asyncio.timeouts SourceModule

imports: asyncio • asyncio.events • asyncio.exceptions • asyncio.tasks • enum • types • typing

imported by: asyncio

asyncio.transports SourceModule

imports: asyncio

imported by: asyncio • asyncio.base_events • asyncio.base_subprocess • asyncio.proactor_events • asyncio.selector_events • asyncio.sslproto • asyncio.unix_events

asyncio.trsock SourceModule

imports: asyncio • socket

imported by: asyncio • asyncio.base_events • asyncio.proactor_events • asyncio.selector_events

asyncio.unix_events SourceModule

imports: asyncio • asyncio.base_events • asyncio.base_subprocess • asyncio.constants • asyncio.coroutines • asyncio.events • asyncio.exceptions • asyncio.futures • asyncio.log • asyncio.selector_events • asyncio.tasks • asyncio.transports • errno • io • itertools • os • selectors • signal • socket • stat • subprocess • sys • threading • warnings

imported by: asyncio

asyncio.windows_events SourceModule

imports: _overlapped • _winapi • asyncio • asyncio.base_subprocess • asyncio.events • asyncio.exceptions • asyncio.futures • asyncio.log • asyncio.proactor_events • asyncio.selector_events • asyncio.tasks • asyncio.windows_utils • errno • math • msvcrt • socket • struct • sys • time • weakref

imported by: asyncio

asyncio.windows_utils SourceModule

imports: _winapi • asyncio • itertools • msvcrt • os • subprocess • sys • tempfile • warnings

imported by: asyncio • asyncio.windows_events

atexit (builtin module)

imported by: logging • multiprocessing.util • weakref

base64 SourceModule

imports: binascii • getopt • re • struct • sys

imported by: email._encoded_words • email.base64mime • email.encoders • encodings.base64_codec • http.server • psutil._pslinux • requests.auth • secrets • ssl • urllib.request • urllib3.util.request • xmlrpc.client

bdb SourceModule

imports: fnmatch • inspect • linecache • os • reprlib • sys

imported by: pdb

binascii /Library/Frameworks/Python.framework/Versions/3.11/lib/python3.11/lib-dynload/binascii.cpython-311-darwin.so

imported by: base64 • email._encoded_words • email.base64mime • email.contentmanager • email.header • email.message • encodings.hex_codec • encodings.uu_codec • http.server • plistlib • quopri • secrets • urllib3.filepost • urllib3.util.ssl_ • zipfile

bisect SourceModule

imports: _bisect

imported by: idna.core • idna.intranges • multiprocessing.heap • random • statistics • urllib.request

brotli MissingModule

imported by: urllib3.response • urllib3.util.request

brotlicffi MissingModule

imported by: urllib3.response • urllib3.util.request

bs4 Package

imports: bs4.builder • bs4.builder.HTMLParserTreeBuilder • bs4.dammit • bs4.element • collections • os • re • sys • traceback • warnings

imported by: JumperlessWokwiBridge.py • bs4.builder • bs4.builder._html5lib • bs4.css • bs4.dammit • bs4.element • bs4.formatter • lxml.html.soupparser • soupsieve • soupsieve.css_match

bs4.builder Package

imports: bs4 • bs4.builder • bs4.builder.HTMLParserTreeBuilder • bs4.builder._html5lib • bs4.builder._htmlparser • bs4.builder._lxml • bs4.element • collections • itertools • re • sys • warnings

imported by: bs4 • bs4.builder • bs4.builder._html5lib • bs4.builder._htmlparser • bs4.builder._lxml

bs4.builder.HTMLParserTreeBuilder MissingModule

imported by: bs4 • bs4.builder

bs4.builder._html5lib SourceModule

imports: 'html5lib.constants' • 'html5lib.treebuilders' • bs4 • bs4.builder • bs4.element • html5lib • re • warnings

imported by: bs4.builder

bs4.builder._htmlparser SourceModule

imports: bs4.builder • bs4.dammit • bs4.element • html.parser • sys • warnings

imported by: bs4.builder

bs4.builder._lxml SourceModule

imports: bs4.builder • bs4.dammit • bs4.element • collections • collections.Callable • collections.abc • io • lxml • lxml.etree

imported by: bs4.builder

bs4.css SourceModule

imports: bs4 • bs4.element • soupsieve • warnings

imported by: bs4.element

bs4.dammit SourceModule

imports: bs4 • cchardet • chardet • charset_normalizer • codecs • collections • html.entities • logging • re • string

imported by: bs4 • bs4.builder._htmlparser • bs4.builder._lxml • bs4.formatter

bs4.element SourceModule

imports: bs4 • bs4.css • bs4.formatter • collections • collections.Callable • collections.abc • re • sys • warnings

imported by: bs4 • bs4.builder • bs4.builder._html5lib • bs4.builder._htmlparser • bs4.builder._lxml • bs4.css • bs4.formatter

bs4.formatter SourceModule

imports: bs4 • bs4.dammit • bs4.element

imported by: bs4.element

builtins (builtin module)

imported by: bz2 • codecs • dataclasses • doctest • enum • gettext • gzip • inspect • locale • lzma • operator • pydoc • reprlib • subprocess • tarfile • tokenize • warnings

bz2 SourceModule

imports: _bz2 • _compression • builtins • io • os

imported by: encodings.bz2_codec • shutil • tarfile • zipfile

calendar SourceModule

imports: argparse • datetime • itertools • locale • sys

imported by: _strptime • email._parseaddr • http.cookiejar • requests.cookies • ssl

cchardet MissingModule

imported by: bs4.dammit

certifi Package

imports: certifi.core

imported by: certifi.core • requests.certs

certifi.core SourceModule

imports: certifi • importlib.resources • os • sys • types • typing

imported by: certifi

cgi SourceModule

imports: collections.abc • email.message • email.parser • html • io • locale • os • re • sys • tempfile • traceback • urllib.parse • warnings

imported by: lxml.doctestcompare

chardet Package

imports: chardet.charsetgroupprober • chardet.charsetprober • chardet.enums • chardet.resultdict • chardet.universaldetector • chardet.version • typing

imported by: bs4.dammit • chardet.big5freq • chardet.big5prober • chardet.chardistribution • chardet.charsetgroupprober • chardet.charsetprober • chardet.codingstatemachine • chardet.codingstatemachinedict • chardet.cp949prober • chardet.enums • chardet.escprober • chardet.escsm • chardet.eucjpprober • chardet.euckrfreq • chardet.euckrprober • chardet.euctwfreq • chardet.euctwprober • chardet.gb2312freq • chardet.gb2312prober • chardet.hebrewprober • chardet.jisfreq • chardet.johabfreq • chardet.johabprober • chardet.jpcntx • chardet.langbulgarianmodel • chardet.langgreekmodel • chardet.langhebrewmodel • chardet.langrussianmodel • chardet.langthaimodel • chardet.langturkishmodel • chardet.latin1prober • chardet.macromanprober • chardet.mbcharsetprober • chardet.mbcsgroupprober • chardet.mbcssm • chardet.resultdict • chardet.sbcharsetprober • chardet.sbcsgroupprober • chardet.sjisprober • chardet.universaldetector • chardet.utf1632prober • chardet.utf8prober • chardet.version • requests • requests.compat • requests.packages

chardet.big5freq SourceModule

imports: chardet

imported by: chardet.chardistribution

chardet.big5prober SourceModule

imports: chardet • chardet.chardistribution • chardet.codingstatemachine • chardet.mbcharsetprober • chardet.mbcssm

imported by: chardet.mbcsgroupprober

chardet.chardistribution SourceModule

imports: chardet • chardet.big5freq • chardet.euckrfreq • chardet.euctwfreq • chardet.gb2312freq • chardet.jisfreq • chardet.johabfreq • typing

imported by: chardet.big5prober • chardet.cp949prober • chardet.eucjpprober • chardet.euckrprober • chardet.euctwprober • chardet.gb2312prober • chardet.johabprober • chardet.mbcharsetprober • chardet.sjisprober

chardet.charsetgroupprober SourceModule

imports: chardet • chardet.charsetprober • chardet.enums • typing

imported by: chardet • chardet.mbcsgroupprober • chardet.sbcsgroupprober • chardet.universaldetector

chardet.charsetprober SourceModule

imports: chardet • chardet.enums • logging • re • typing

imported by: chardet • chardet.charsetgroupprober • chardet.escprober • chardet.hebrewprober • chardet.latin1prober • chardet.macromanprober • chardet.mbcharsetprober • chardet.sbcharsetprober • chardet.universaldetector • chardet.utf1632prober • chardet.utf8prober

chardet.codingstatemachine SourceModule

imports: chardet • chardet.codingstatemachinedict • chardet.enums • logging

imported by: chardet.big5prober • chardet.cp949prober • chardet.escprober • chardet.eucjpprober • chardet.euckrprober • chardet.euctwprober • chardet.gb2312prober • chardet.johabprober • chardet.mbcharsetprober • chardet.sjisprober • chardet.utf8prober

chardet.codingstatemachinedict SourceModule

imports: chardet • typing

imported by: chardet.codingstatemachine • chardet.escsm • chardet.mbcssm

chardet.cp949prober SourceModule

imports: chardet • chardet.chardistribution • chardet.codingstatemachine • chardet.mbcharsetprober • chardet.mbcssm

imported by: chardet.mbcsgroupprober

chardet.enums SourceModule

imports: chardet • enum

imported by: chardet • chardet.charsetgroupprober • chardet.charsetprober • chardet.codingstatemachine • chardet.escprober • chardet.escsm • chardet.eucjpprober • chardet.hebrewprober • chardet.latin1prober • chardet.macromanprober • chardet.mbcharsetprober • chardet.mbcsgroupprober • chardet.mbcssm • chardet.sbcharsetprober • chardet.sjisprober • chardet.universaldetector • chardet.utf1632prober • chardet.utf8prober

chardet.escprober SourceModule

imports: chardet • chardet.charsetprober • chardet.codingstatemachine • chardet.enums • chardet.escsm • typing

imported by: chardet.universaldetector

chardet.escsm SourceModule

imports: chardet • chardet.codingstatemachinedict • chardet.enums

imported by: chardet.escprober

chardet.eucjpprober SourceModule

imports: chardet • chardet.chardistribution • chardet.codingstatemachine • chardet.enums • chardet.jpcntx • chardet.mbcharsetprober • chardet.mbcssm • typing

imported by: chardet.mbcsgroupprober

chardet.euckrfreq SourceModule

imports: chardet

imported by: chardet.chardistribution

chardet.euckrprober SourceModule

imports: chardet • chardet.chardistribution • chardet.codingstatemachine • chardet.mbcharsetprober • chardet.mbcssm

imported by: chardet.mbcsgroupprober

chardet.euctwfreq SourceModule

imports: chardet

imported by: chardet.chardistribution

chardet.euctwprober SourceModule

imports: chardet • chardet.chardistribution • chardet.codingstatemachine • chardet.mbcharsetprober • chardet.mbcssm

imported by: chardet.mbcsgroupprober

chardet.gb2312freq SourceModule

imports: chardet

imported by: chardet.chardistribution

chardet.gb2312prober SourceModule

imports: chardet • chardet.chardistribution • chardet.codingstatemachine • chardet.mbcharsetprober • chardet.mbcssm

imported by: chardet.mbcsgroupprober

chardet.hebrewprober SourceModule

imports: chardet • chardet.charsetprober • chardet.enums • chardet.sbcharsetprober • typing

imported by: chardet.sbcsgroupprober

chardet.jisfreq SourceModule

imports: chardet

imported by: chardet.chardistribution

chardet.johabfreq SourceModule

imports: chardet

imported by: chardet.chardistribution

chardet.johabprober SourceModule

imports: chardet • chardet.chardistribution • chardet.codingstatemachine • chardet.mbcharsetprober • chardet.mbcssm

imported by: chardet.mbcsgroupprober

chardet.jpcntx SourceModule

imports: chardet • typing

imported by: chardet.eucjpprober • chardet.sjisprober

chardet.langbulgarianmodel SourceModule

imports: chardet • chardet.sbcharsetprober

imported by: chardet.sbcsgroupprober

chardet.langgreekmodel SourceModule

imports: chardet • chardet.sbcharsetprober

imported by: chardet.sbcsgroupprober

chardet.langhebrewmodel SourceModule

imports: chardet • chardet.sbcharsetprober

imported by: chardet.sbcsgroupprober

chardet.langrussianmodel SourceModule

imports: chardet • chardet.sbcharsetprober

imported by: chardet.sbcsgroupprober

chardet.langthaimodel SourceModule

imports: chardet • chardet.sbcharsetprober

imported by: chardet.sbcsgroupprober

chardet.langturkishmodel SourceModule

imports: chardet • chardet.sbcharsetprober

imported by: chardet.sbcsgroupprober

chardet.latin1prober SourceModule

imports: chardet • chardet.charsetprober • chardet.enums • typing

imported by: chardet.universaldetector

chardet.macromanprober SourceModule

imports: chardet • chardet.charsetprober • chardet.enums • typing

imported by: chardet.universaldetector

chardet.mbcharsetprober SourceModule

imports: chardet • chardet.chardistribution • chardet.charsetprober • chardet.codingstatemachine • chardet.enums • typing

imported by: chardet.big5prober • chardet.cp949prober • chardet.eucjpprober • chardet.euckrprober • chardet.euctwprober • chardet.gb2312prober • chardet.johabprober • chardet.sjisprober

chardet.mbcsgroupprober SourceModule

imports: chardet • chardet.big5prober • chardet.charsetgroupprober • chardet.cp949prober • chardet.enums • chardet.eucjpprober • chardet.euckrprober • chardet.euctwprober • chardet.gb2312prober • chardet.johabprober • chardet.sjisprober • chardet.utf8prober

imported by: chardet.universaldetector

chardet.mbcssm SourceModule

imports: chardet • chardet.codingstatemachinedict • chardet.enums

imported by: chardet.big5prober • chardet.cp949prober • chardet.eucjpprober • chardet.euckrprober • chardet.euctwprober • chardet.gb2312prober • chardet.johabprober • chardet.sjisprober • chardet.utf8prober

chardet.resultdict SourceModule

imports: chardet • typing

imported by: chardet • chardet.universaldetector

chardet.sbcharsetprober SourceModule

imports: chardet • chardet.charsetprober • chardet.enums • typing

imported by: chardet.hebrewprober • chardet.langbulgarianmodel • chardet.langgreekmodel • chardet.langhebrewmodel • chardet.langrussianmodel • chardet.langthaimodel • chardet.langturkishmodel • chardet.sbcsgroupprober

chardet.sbcsgroupprober SourceModule

imports: chardet • chardet.charsetgroupprober • chardet.hebrewprober • chardet.langbulgarianmodel • chardet.langgreekmodel • chardet.langhebrewmodel • chardet.langrussianmodel • chardet.langthaimodel • chardet.langturkishmodel • chardet.sbcharsetprober

imported by: chardet.universaldetector

chardet.sjisprober SourceModule

imports: chardet • chardet.chardistribution • chardet.codingstatemachine • chardet.enums • chardet.jpcntx • chardet.mbcharsetprober • chardet.mbcssm • typing

imported by: chardet.mbcsgroupprober

chardet.universaldetector SourceModule

imports: chardet • chardet.charsetgroupprober • chardet.charsetprober • chardet.enums • chardet.escprober • chardet.latin1prober • chardet.macromanprober • chardet.mbcsgroupprober • chardet.resultdict • chardet.sbcsgroupprober • chardet.utf1632prober • codecs • logging • re • typing

imported by: chardet

chardet.utf1632prober SourceModule

imports: chardet • chardet.charsetprober • chardet.enums • typing

imported by: chardet.universaldetector

chardet.utf8prober SourceModule

imports: chardet • chardet.charsetprober • chardet.codingstatemachine • chardet.enums • chardet.mbcssm • typing

imported by: chardet.mbcsgroupprober

chardet.version SourceModule

imports: chardet

imported by: chardet

charset_normalizer Package

imports: charset_normalizer.api • charset_normalizer.legacy • charset_normalizer.md__mypyc • charset_normalizer.models • charset_normalizer.utils • charset_normalizer.version • logging

imported by: bs4.dammit • charset_normalizer.api • charset_normalizer.assets • charset_normalizer.cd • charset_normalizer.constant • charset_normalizer.legacy • charset_normalizer.md • charset_normalizer.md__mypyc • charset_normalizer.models • charset_normalizer.utils • charset_normalizer.version • requests • requests.compat • requests.packages

charset_normalizer.api SourceModule

imports: charset_normalizer • charset_normalizer.cd • charset_normalizer.constant • charset_normalizer.md • charset_normalizer.models • charset_normalizer.utils • logging • os • typing

imported by: charset_normalizer • charset_normalizer.legacy

charset_normalizer.assets Package

imports: charset_normalizer • typing

imported by: charset_normalizer.cd • charset_normalizer.constant

charset_normalizer.cd SourceModule

imports: charset_normalizer • charset_normalizer.assets • charset_normalizer.constant • charset_normalizer.md • charset_normalizer.models • charset_normalizer.utils • codecs • collections • functools • importlib • typing

imported by: charset_normalizer.api • charset_normalizer.models

charset_normalizer.constant SourceModule

imports: charset_normalizer • charset_normalizer.assets • codecs • encodings.aliases • re • typing

imported by: charset_normalizer.api • charset_normalizer.cd • charset_normalizer.legacy • charset_normalizer.models • charset_normalizer.utils

charset_normalizer.legacy SourceModule

imports: charset_normalizer • charset_normalizer.api • charset_normalizer.constant • typing • warnings

imported by: charset_normalizer

charset_normalizer.md /Users/kevinsanto/Library/Python/3.11/lib/python/site-packages/charset_normalizer/md.cpython-311-darwin.so

imports: charset_normalizer

imported by: charset_normalizer.api • charset_normalizer.cd

charset_normalizer.md__mypyc /Users/kevinsanto/Library/Python/3.11/lib/python/site-packages/charset_normalizer/md__mypyc.cpython-311-darwin.so

imports: charset_normalizer

imported by: charset_normalizer

charset_normalizer.models SourceModule

imports: charset_normalizer • charset_normalizer.cd • charset_normalizer.constant • charset_normalizer.utils • encodings.aliases • hashlib • json • typing

imported by: charset_normalizer • charset_normalizer.api • charset_normalizer.cd

charset_normalizer.utils SourceModule

imports: _multibytecodec • charset_normalizer • charset_normalizer.constant • codecs • encodings.aliases • functools • importlib • logging • re • typing • unicodedata

imported by: charset_normalizer • charset_normalizer.api • charset_normalizer.cd • charset_normalizer.models

charset_normalizer.version SourceModule

imports: charset_normalizer

imported by: charset_normalizer

cmd SourceModule

imports: readline • string • sys

imported by: pdb

code SourceModule

imports: argparse • codeop • readline • sys • traceback

imported by: pdb

codecs SourceModule

imports: _codecs • builtins • encodings • sys

imported by: JumperlessWokwiBridge.py • _pickle • bs4.dammit • chardet.universaldetector • charset_normalizer.cd • charset_normalizer.constant • charset_normalizer.utils • encodings • encodings.ascii • encodings.base64_codec • encodings.big5 • encodings.big5hkscs • encodings.bz2_codec • encodings.charmap • encodings.cp037 • encodings.cp1006 • encodings.cp1026 • encodings.cp1125 • encodings.cp1140 • encodings.cp1250 • encodings.cp1251 • encodings.cp1252 • encodings.cp1253 • encodings.cp1254 • encodings.cp1255 • encodings.cp1256 • encodings.cp1257 • encodings.cp1258 • encodings.cp273 • encodings.cp424 • encodings.cp437 • encodings.cp500 • encodings.cp720 • encodings.cp737 • encodings.cp775 • encodings.cp850 • encodings.cp852 • encodings.cp855 • encodings.cp856 • encodings.cp857 • encodings.cp858 • encodings.cp860 • encodings.cp861 • encodings.cp862 • encodings.cp863 • encodings.cp864 • encodings.cp865 • encodings.cp866 • encodings.cp869 • encodings.cp874 • encodings.cp875 • encodings.cp932 • encodings.cp949 • encodings.cp950 • encodings.euc_jis_2004 • encodings.euc_jisx0213 • encodings.euc_jp • encodings.euc_kr • encodings.gb18030 • encodings.gb2312 • encodings.gbk • encodings.hex_codec • encodings.hp_roman8 • encodings.hz • encodings.idna • encodings.iso2022_jp • encodings.iso2022_jp_1 • encodings.iso2022_jp_2 • encodings.iso2022_jp_2004 • encodings.iso2022_jp_3 • encodings.iso2022_jp_ext • encodings.iso2022_kr • encodings.iso8859_1 • encodings.iso8859_10 • encodings.iso8859_11 • encodings.iso8859_13 • encodings.iso8859_14 • encodings.iso8859_15 • encodings.iso8859_16 • encodings.iso8859_2 • encodings.iso8859_3 • encodings.iso8859_4 • encodings.iso8859_5 • encodings.iso8859_6 • encodings.iso8859_7 • encodings.iso8859_8 • encodings.iso8859_9 • encodings.johab • encodings.koi8_r • encodings.koi8_t • encodings.koi8_u • encodings.kz1048 • encodings.latin_1 • encodings.mac_arabic • encodings.mac_croatian • encodings.mac_cyrillic • encodings.mac_farsi • encodings.mac_greek • encodings.mac_iceland • encodings.mac_latin2 • encodings.mac_roman • encodings.mac_romanian • encodings.mac_turkish • encodings.mbcs • encodings.oem • encodings.palmos • encodings.ptcp154 • encodings.punycode • encodings.quopri_codec • encodings.raw_unicode_escape • encodings.rot_13 • encodings.shift_jis • encodings.shift_jis_2004 • encodings.shift_jisx0213 • encodings.tis_620 • encodings.undefined • encodings.unicode_escape • encodings.utf_16 • encodings.utf_16_be • encodings.utf_16_le • encodings.utf_32 • encodings.utf_32_be • encodings.utf_32_le • encodings.utf_7 • encodings.utf_8 • encodings.utf_8_sig • encodings.uu_codec • encodings.zlib_codec • json • pickle • plistlib • requests.utils • tokenize • urllib3.filepost • xml.sax.saxutils

codeop SourceModule

imports: __future__ • warnings

imported by: code

collections Package

imports: _collections • _collections_abc • _weakref • collections.Callable • collections.MutableMapping • collections.MutableSet • copy • heapq • itertools • keyword • operator • reprlib • sys

imported by: JumperlessWokwiBridge.py • _pydecimal • ast • asyncio.base_events • asyncio.base_subprocess • asyncio.locks • asyncio.proactor_events • asyncio.queues • asyncio.selector_events • asyncio.sslproto • asyncio.streams • bs4 • bs4.builder • bs4.builder._lxml • bs4.dammit • bs4.element • charset_normalizer.cd • collections.abc • concurrent.futures._base • contextlib • difflib • dis • doctest • email.feedparser • functools • importlib.metadata • importlib.metadata._collections • importlib.resources.readers • inspect • lxml.html • lxml.html._setmixin • multiprocessing.heap • multiprocessing.pool • multiprocessing.queues • pkgutil • platform • pprint • psutil • psutil._common • psutil._compat • psutil._psaix • psutil._psbsd • psutil._pslinux • psutil._psosx • psutil._pssunos • psutil._pswindows • pydoc • queue • requests.compat • requests.sessions • requests.structures • requests.utils • selectors • shlex • shutil • soupsieve.__meta__ • ssl • statistics • string • threading • tokenize • typing • typing_extensions • unittest._log • unittest.case • unittest.util • urllib.parse • urllib.robotparser • urllib3._collections • urllib3.response • xml.etree.ElementTree

collections.Callable MissingModule

imported by: bs4.builder._lxml • bs4.element • collections

collections.MutableMapping MissingModule

imported by: collections • lxml.html

collections.MutableSet MissingModule

imported by: collections • lxml.html • lxml.html._setmixin

collections.abc SourceModule

imports: _collections_abc • collections

imported by: JumperlessWokwiBridge.py • asyncio.base_events • asyncio.coroutines • bs4.builder._lxml • bs4.element • cgi • http.client • inspect • logging • lxml.html • lxml.html._setmixin • requests.compat • selectors • traceback • tracemalloc • typing • typing_extensions • xml.etree.ElementTree

concurrent Package

imported by: concurrent.futures

concurrent.futures Package

imports: concurrent • concurrent.futures._base • concurrent.futures.process • concurrent.futures.thread

imported by: asyncio.base_events • asyncio.futures • asyncio.tasks • concurrent.futures._base • concurrent.futures.process • concurrent.futures.thread

concurrent.futures._base SourceModule

imports: collections • concurrent.futures • logging • threading • time • types

imported by: concurrent.futures • concurrent.futures.process • concurrent.futures.thread

concurrent.futures.process SourceModule

imports: concurrent.futures • concurrent.futures._base • functools • itertools • multiprocessing • multiprocessing.connection • multiprocessing.queues • multiprocessing.synchronize • os • queue • sys • threading • traceback • weakref

imported by: concurrent.futures

concurrent.futures.thread SourceModule

imports: concurrent.futures • concurrent.futures._base • itertools • os • queue • threading • types • weakref

imported by: concurrent.futures

contextlib SourceModule

imports: _collections_abc • abc • collections • functools • os • sys • types

imported by: _osx_support • _threading_local • ast • asyncio.staggered • getpass • glob • http.server • importlib.metadata • importlib.resources._adapters • importlib.resources._common • importlib.util • lxml.etree • psutil • psutil._common • psutil._compat • psutil._psbsd • psutil._pswindows • requests.utils • subprocess • traceback • typing • unittest.case • urllib.request • urllib3.response • xml.etree.ElementTree • zipfile

contextvars SourceModule

imports: _contextvars

imported by: _pydecimal • asyncio.events • asyncio.futures • asyncio.runners • asyncio.tasks • asyncio.threads • unittest.async_case

copy SourceModule

imports: copyreg • org • types • weakref

imported by: _sre • argparse • collections • dataclasses • email.generator • gettext • http.cookiejar • http.server • lxml.html • lxml.html.formfill • requests.cookies • tarfile • weakref • webbrowser • xml.etree.ElementInclude

copyreg SourceModule

imports: functools • operator

imported by: JumperlessWokwiBridge.py • _pickle • copy • multiprocessing.reduction • pickle • re • soupsieve.css_types

cryptography MissingModule

imported by: requests • urllib3.contrib.pyopenssl

cssselect MissingModule

imported by: lxml.cssselect

csv SourceModule

imports: _csv • io • re

imported by: importlib.metadata

ctypes Package

imports: _ctypes • ctypes._endian • nt • os • struct • sys • types

imported by: ctypes._endian • ctypes.wintypes • multiprocessing.sharedctypes • psutil._common • psutil._pslinux • serial.serialwin32 • serial.tools.list_ports_osx • serial.tools.list_ports_windows • serial.win32

ctypes._endian SourceModule

imports: ctypes • sys

imported by: ctypes

ctypes.wintypes SourceModule

imports: ctypes

imported by: serial.tools.list_ports_windows • serial.win32

curses Package

imports: _curses • curses • curses.has_key • os • sys

imported by: _curses • curses • curses.has_key • psutil._common

curses.has_key SourceModule

imports: _curses • curses

imported by: curses

dataclasses SourceModule

imports: _thread • abc • builtins • copy • functools • inspect • itertools • keyword • re • sys • types

imported by: pprint

datetime SourceModule

imports: _datetime • _strptime • math • operator • sys • time

imported by: _strptime • calendar • email.utils • http.cookiejar • http.server • plistlib • psutil • requests.models • requests.sessions • soupsieve.css_match • urllib3.connection • xmlrpc.client

decimal SourceModule

imports: _decimal • _pydecimal

imported by: fractions • statistics • xmlrpc.client

difflib SourceModule

imports: collections • difflib • heapq • re • types

imported by: difflib • doctest • unittest.case

dis SourceModule

imports: argparse • collections • io • opcode • sys • types

imported by: inspect • pdb

doctest SourceModule

imports: __future__ • argparse • builtins • collections • difflib • inspect • io • linecache • os • pdb • re • sys • traceback • unittest

imported by: lxml.doctestcompare

dummy_threading MissingModule

imported by: psutil._compat • requests.cookies

email Package

imports: email._header_value_parser • email.charset • email.errors • email.header • email.parser

imported by: email._encoded_words • email._header_value_parser • email._parseaddr • email._policybase • email.base64mime • email.charset • email.contentmanager • email.encoders • email.errors • email.feedparser • email.generator • email.header • email.headerregistry • email.iterators • email.message • email.parser • email.policy • email.quoprimime • email.utils • importlib.metadata • urllib.request • urllib3.util.retry

email._encoded_words SourceModule

imports: base64 • binascii • email • email.errors • functools • re • string

imported by: email._header_value_parser • email.message

email._header_value_parser SourceModule

imports: email • email._encoded_words • email.errors • email.utils • operator • re • string • sys • urllib

imported by: email • email.headerregistry

email._parseaddr SourceModule

imports: calendar • email • time

imported by: email.utils

email._policybase SourceModule

imports: abc • email • email.charset • email.header • email.utils

imported by: email.feedparser • email.message • email.parser • email.policy

email.base64mime SourceModule

imports: base64 • binascii • email

imported by: email.charset • email.header

email.charset SourceModule

imports: email • email.base64mime • email.encoders • email.errors • email.quoprimime • functools

imported by: email • email._policybase • email.contentmanager • email.header • email.message • email.utils

email.contentmanager SourceModule

imports: binascii • email • email.charset • email.errors • email.message • email.quoprimime

imported by: email.policy

email.encoders SourceModule

imports: base64 • email • quopri

imported by: email.charset

email.errors SourceModule

imports: email

imported by: email • email._encoded_words • email._header_value_parser • email.charset • email.contentmanager • email.feedparser • email.header • email.headerregistry • email.message • urllib3.exceptions • urllib3.util.response

email.feedparser SourceModule

imports: collections • email • email._policybase • email.errors • email.message • io • re

imported by: email.parser

email.generator SourceModule

imports: copy • email • email.utils • io • random • re • sys • time

imported by: email.message

email.header SourceModule

imports: binascii • email • email.base64mime • email.charset • email.errors • email.quoprimime • re

imported by: email • email._policybase

email.headerregistry SourceModule

imports: email • email._header_value_parser • email.errors • email.utils • types

imported by: email.policy

email.iterators SourceModule

imports: email • io • sys

imported by: email.message

email.message SourceModule

imports: binascii • email • email._encoded_words • email._policybase • email.charset • email.errors • email.generator • email.iterators • email.policy • email.utils • io • quopri • re

imported by: cgi • email.contentmanager • email.feedparser • email.policy • http.client • importlib.metadata._adapters • pydoc

email.parser SourceModule

imports: email • email._policybase • email.feedparser • io

imported by: cgi • email • http.client

email.policy SourceModule

imports: email • email._policybase • email.contentmanager • email.headerregistry • email.message • email.utils • re • sys

imported by: email.message

email.quoprimime SourceModule

imports: email • re • string

imported by: email.charset • email.contentmanager • email.header

email.utils SourceModule

imports: datetime • email • email._parseaddr • email.charset • os • random • re • socket • time • urllib.parse

imported by: email._header_value_parser • email._policybase • email.generator • email.headerregistry • email.message • email.policy • http.server • urllib.request • urllib3.fields

encodings Package

imports: _winapi • codecs • encodings • encodings.aliases • encodings.ascii • encodings.base64_codec • encodings.big5 • encodings.big5hkscs • encodings.bz2_codec • encodings.charmap • encodings.cp037 • encodings.cp1006 • encodings.cp1026 • encodings.cp1125 • encodings.cp1140 • encodings.cp1250 • encodings.cp1251 • encodings.cp1252 • encodings.cp1253 • encodings.cp1254 • encodings.cp1255 • encodings.cp1256 • encodings.cp1257 • encodings.cp1258 • encodings.cp273 • encodings.cp424 • encodings.cp437 • encodings.cp500 • encodings.cp720 • encodings.cp737 • encodings.cp775 • encodings.cp850 • encodings.cp852 • encodings.cp855 • encodings.cp856 • encodings.cp857 • encodings.cp858 • encodings.cp860 • encodings.cp861 • encodings.cp862 • encodings.cp863 • encodings.cp864 • encodings.cp865 • encodings.cp866 • encodings.cp869 • encodings.cp874 • encodings.cp875 • encodings.cp932 • encodings.cp949 • encodings.cp950 • encodings.euc_jis_2004 • encodings.euc_jisx0213 • encodings.euc_jp • encodings.euc_kr • encodings.gb18030 • encodings.gb2312 • encodings.gbk • encodings.hex_codec • encodings.hp_roman8 • encodings.hz • encodings.idna • encodings.iso2022_jp • encodings.iso2022_jp_1 • encodings.iso2022_jp_2 • encodings.iso2022_jp_2004 • encodings.iso2022_jp_3 • encodings.iso2022_jp_ext • encodings.iso2022_kr • encodings.iso8859_1 • encodings.iso8859_10 • encodings.iso8859_11 • encodings.iso8859_13 • encodings.iso8859_14 • encodings.iso8859_15 • encodings.iso8859_16 • encodings.iso8859_2 • encodings.iso8859_3 • encodings.iso8859_4 • encodings.iso8859_5 • encodings.iso8859_6 • encodings.iso8859_7 • encodings.iso8859_8 • encodings.iso8859_9 • encodings.johab • encodings.koi8_r • encodings.koi8_t • encodings.koi8_u • encodings.kz1048 • encodings.latin_1 • encodings.mac_arabic • encodings.mac_croatian • encodings.mac_cyrillic • encodings.mac_farsi • encodings.mac_greek • encodings.mac_iceland • encodings.mac_latin2 • encodings.mac_roman • encodings.mac_romanian • encodings.mac_turkish • encodings.mbcs • encodings.oem • encodings.palmos • encodings.ptcp154 • encodings.punycode • encodings.quopri_codec • encodings.raw_unicode_escape • encodings.rot_13 • encodings.shift_jis • encodings.shift_jis_2004 • encodings.shift_jisx0213 • encodings.tis_620 • encodings.undefined • encodings.unicode_escape • encodings.utf_16 • encodings.utf_16_be • encodings.utf_16_le • encodings.utf_32 • encodings.utf_32_be • encodings.utf_32_le • encodings.utf_7 • encodings.utf_8 • encodings.utf_8_sig • encodings.uu_codec • encodings.zlib_codec • sys

imported by: JumperlessWokwiBridge.py • codecs • encodings • encodings.aliases • encodings.ascii • encodings.base64_codec • encodings.big5 • encodings.big5hkscs • encodings.bz2_codec • encodings.charmap • encodings.cp037 • encodings.cp1006 • encodings.cp1026 • encodings.cp1125 • encodings.cp1140 • encodings.cp1250 • encodings.cp1251 • encodings.cp1252 • encodings.cp1253 • encodings.cp1254 • encodings.cp1255 • encodings.cp1256 • encodings.cp1257 • encodings.cp1258 • encodings.cp273 • encodings.cp424 • encodings.cp437 • encodings.cp500 • encodings.cp720 • encodings.cp737 • encodings.cp775 • encodings.cp850 • encodings.cp852 • encodings.cp855 • encodings.cp856 • encodings.cp857 • encodings.cp858 • encodings.cp860 • encodings.cp861 • encodings.cp862 • encodings.cp863 • encodings.cp864 • encodings.cp865 • encodings.cp866 • encodings.cp869 • encodings.cp874 • encodings.cp875 • encodings.cp932 • encodings.cp949 • encodings.cp950 • encodings.euc_jis_2004 • encodings.euc_jisx0213 • encodings.euc_jp • encodings.euc_kr • encodings.gb18030 • encodings.gb2312 • encodings.gbk • encodings.hex_codec • encodings.hp_roman8 • encodings.hz • encodings.idna • encodings.iso2022_jp • encodings.iso2022_jp_1 • encodings.iso2022_jp_2 • encodings.iso2022_jp_2004 • encodings.iso2022_jp_3 • encodings.iso2022_jp_ext • encodings.iso2022_kr • encodings.iso8859_1 • encodings.iso8859_10 • encodings.iso8859_11 • encodings.iso8859_13 • encodings.iso8859_14 • encodings.iso8859_15 • encodings.iso8859_16 • encodings.iso8859_2 • encodings.iso8859_3 • encodings.iso8859_4 • encodings.iso8859_5 • encodings.iso8859_6 • encodings.iso8859_7 • encodings.iso8859_8 • encodings.iso8859_9 • encodings.johab • encodings.koi8_r • encodings.koi8_t • encodings.koi8_u • encodings.kz1048 • encodings.latin_1 • encodings.mac_arabic • encodings.mac_croatian • encodings.mac_cyrillic • encodings.mac_farsi • encodings.mac_greek • encodings.mac_iceland • encodings.mac_latin2 • encodings.mac_roman • encodings.mac_romanian • encodings.mac_turkish • encodings.mbcs • encodings.oem • encodings.palmos • encodings.ptcp154 • encodings.punycode • encodings.quopri_codec • encodings.raw_unicode_escape • encodings.rot_13 • encodings.shift_jis • encodings.shift_jis_2004 • encodings.shift_jisx0213 • encodings.tis_620 • encodings.undefined • encodings.unicode_escape • encodings.utf_16 • encodings.utf_16_be • encodings.utf_16_le • encodings.utf_32 • encodings.utf_32_be • encodings.utf_32_le • encodings.utf_7 • encodings.utf_8 • encodings.utf_8_sig • encodings.uu_codec • encodings.zlib_codec • locale

encodings.aliases SourceModule

imports: encodings

imported by: JumperlessWokwiBridge.py • charset_normalizer.constant • charset_normalizer.models • charset_normalizer.utils • encodings • locale

encodings.ascii SourceModule

imports: codecs • encodings

imported by: JumperlessWokwiBridge.py • encodings

encodings.base64_codec SourceModule

imports: base64 • codecs • encodings

imported by: JumperlessWokwiBridge.py • encodings

encodings.big5 SourceModule

imports: _codecs_tw • _multibytecodec • codecs • encodings

imported by: JumperlessWokwiBridge.py • encodings

encodings.big5hkscs SourceModule

imports: _codecs_hk • _multibytecodec • codecs • encodings

imported by: JumperlessWokwiBridge.py • encodings

encodings.bz2_codec SourceModule

imports: bz2 • codecs • encodings

imported by: JumperlessWokwiBridge.py • encodings

encodings.charmap SourceModule

imports: codecs • encodings

imported by: JumperlessWokwiBridge.py • encodings

encodings.cp037 SourceModule

imports: codecs • encodings

imported by: JumperlessWokwiBridge.py • encodings

encodings.cp1006 SourceModule

imports: codecs • encodings

imported by: JumperlessWokwiBridge.py • encodings

encodings.cp1026 SourceModule

imports: codecs • encodings

imported by: JumperlessWokwiBridge.py • encodings

encodings.cp1125 SourceModule

imports: codecs • encodings

imported by: JumperlessWokwiBridge.py • encodings

encodings.cp1140 SourceModule

imports: codecs • encodings

imported by: JumperlessWokwiBridge.py • encodings

encodings.cp1250 SourceModule

imports: codecs • encodings

imported by: JumperlessWokwiBridge.py • encodings

encodings.cp1251 SourceModule

imports: codecs • encodings

imported by: JumperlessWokwiBridge.py • encodings

encodings.cp1252 SourceModule

imports: codecs • encodings

imported by: JumperlessWokwiBridge.py • encodings

encodings.cp1253 SourceModule

imports: codecs • encodings

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

encodings.punycode SourceModule

imports: codecs • encodings

imported by: JumperlessWokwiBridge.py • encodings

encodings.quopri_codec SourceModule

imports: codecs • encodings • io • quopri

imported by: JumperlessWokwiBridge.py • encodings

encodings.raw_unicode_escape SourceModule

imports: codecs • encodings

imported by: JumperlessWokwiBridge.py • encodings

encodings.rot_13 SourceModule

imports: codecs • encodings • sys

imported by: JumperlessWokwiBridge.py • encodings

encodings.shift_jis SourceModule

imports: _codecs_jp • _multibytecodec • codecs • encodings

imported by: JumperlessWokwiBridge.py • encodings

encodings.shift_jis_2004 SourceModule

imports: _codecs_jp • _multibytecodec • codecs • encodings

imported by: JumperlessWokwiBridge.py • encodings

encodings.shift_jisx0213 SourceModule

imports: _codecs_jp • _multibytecodec • codecs • encodings

imported by: JumperlessWokwiBridge.py • encodings

encodings.tis_620 SourceModule

imports: codecs • encodings

imported by: JumperlessWokwiBridge.py • encodings

encodings.undefined SourceModule

imports: codecs • encodings

imported by: JumperlessWokwiBridge.py • encodings

encodings.unicode_escape SourceModule

imports: codecs • encodings

imported by: JumperlessWokwiBridge.py • encodings

encodings.utf_16 SourceModule

imports: codecs • encodings • sys

imported by: JumperlessWokwiBridge.py • encodings

encodings.utf_16_be SourceModule

imports: codecs • encodings

imported by: JumperlessWokwiBridge.py • encodings

encodings.utf_16_le SourceModule

imports: codecs • encodings

imported by: JumperlessWokwiBridge.py • encodings

encodings.utf_32 SourceModule

imports: codecs • encodings • sys

imported by: JumperlessWokwiBridge.py • encodings

encodings.utf_32_be SourceModule

imports: codecs • encodings

imported by: JumperlessWokwiBridge.py • encodings

encodings.utf_32_le SourceModule

imports: codecs • encodings

imported by: JumperlessWokwiBridge.py • encodings

encodings.utf_7 SourceModule

imports: codecs • encodings

imported by: JumperlessWokwiBridge.py • encodings

encodings.utf_8 SourceModule

imports: codecs • encodings

imported by: JumperlessWokwiBridge.py • encodings

encodings.utf_8_sig SourceModule

imports: codecs • encodings

imported by: JumperlessWokwiBridge.py • encodings

encodings.uu_codec SourceModule

imports: binascii • codecs • encodings • io

imported by: JumperlessWokwiBridge.py • encodings

encodings.zlib_codec SourceModule

imports: codecs • encodings • zlib

imported by: JumperlessWokwiBridge.py • encodings

enum SourceModule

imports: builtins • functools • operator • sys • types • warnings

imported by: JumperlessWokwiBridge.py • ast • asyncio.constants • asyncio.locks • asyncio.runners • asyncio.sslproto • asyncio.timeouts • chardet.enums • http • inspect • plistlib • psutil._common • psutil._pslinux • psutil._psposix • psutil._pswindows • py_compile • re • signal • socket • ssl • urllib3._collections • urllib3.util.request • urllib3.util.timeout

errno (builtin module)

imported by: asyncio.selector_events • asyncio.unix_events • asyncio.windows_events • gettext • gzip • http.client • multiprocessing.forkserver • multiprocessing.queues • multiprocessing.shared_memory • pathlib • psutil._common • psutil._compat • psutil._psbsd • psutil._pslinux • psutil._psosx • psutil._pssunos • psutil._pswindows • serial.serialposix • shutil • socket • ssl • subprocess • tempfile • urllib3.connectionpool • xmlrpc.client

fcntl /Library/Frameworks/Python.framework/Versions/3.11/lib/python3.11/lib-dynload/fcntl.cpython-311-darwin.so

imported by: psutil._compat • serial.serialposix • subprocess

fnmatch SourceModule

imports: functools • os • posixpath • re

imported by: JumperlessWokwiBridge.py • bdb • glob • pathlib • shutil • tracemalloc • unittest.loader • urllib.request

fractions SourceModule

imports: decimal • math • numbers • operator • re • sys

imported by: statistics

ftplib SourceModule

imports: netrc • re • socket • ssl • sys • warnings

imported by: urllib.request

functools SourceModule

imports: _functools • _thread • abc • collections • reprlib • types • typing • weakref

imported by: JumperlessWokwiBridge.py • asyncio.base_events • asyncio.format_helpers • asyncio.runners • asyncio.selector_events • asyncio.tasks • asyncio.threads • charset_normalizer.cd • charset_normalizer.utils • concurrent.futures.process • contextlib • copyreg • dataclasses • email._encoded_words • email.charset • enum • fnmatch • importlib.metadata • importlib.metadata._functools • importlib.resources._common • importlib.resources._legacy • importlib.util • inspect • ipaddress • linecache • locale • lxml.html • multiprocessing.reduction • multiprocessing.shared_memory • operator • pathlib • pdb • pickle • pkgutil • platform • psutil • psutil._common • psutil._compat • psutil._psaix • psutil._psbsd • psutil._pslinux • psutil._psosx • psutil._pssunos • psutil._pswindows • re • soupsieve.css_parser • soupsieve.util • statistics • tempfile • threading • tokenize • tracemalloc • types • typing • typing_extensions • unittest.case • unittest.loader • unittest.result • unittest.signals • urllib.parse • urllib3.poolmanager • urllib3.util.wait

gc (builtin module)

imports: time

imported by: _posixsubprocess • weakref

genericpath SourceModule

imports: os • stat

imported by: JumperlessWokwiBridge.py • ntpath • posixpath

getopt SourceModule

imports: gettext • os • sys

imported by: base64 • mimetypes • pdb • pydoc • quopri • webbrowser

getpass SourceModule

imports: contextlib • io • msvcrt • os • pwd • sys • termios • warnings

imported by: urllib.request

gettext SourceModule

imports: builtins • copy • errno • locale • os • re • struct • sys • warnings

imported by: argparse • getopt • optparse

glob SourceModule

imports: contextlib • fnmatch • itertools • os • re • stat • sys

imported by: pdb • psutil._psaix • psutil._pslinux • psutil._psposix • serial.tools.list_ports_common • serial.tools.list_ports_linux • serial.tools.list_ports_posix • webbrowser

grp /Library/Frameworks/Python.framework/Versions/3.11/lib/python3.11/lib-dynload/grp.cpython-311-darwin.so

imported by: pathlib • shutil • subprocess • tarfile

gzip SourceModule

imports: _compression • argparse • builtins • errno • io • os • struct • sys • time • warnings • zlib

imported by: lxml.etree • tarfile • xmlrpc.client

hashlib SourceModule

imports: _blake2 • _hashlib • _md5 • _sha1 • _sha256 • _sha3 • _sha512 • logging • warnings

imported by: charset_normalizer.models • hmac • random • requests.auth • urllib.request • urllib3.util.ssl_

heapq SourceModule

imports: _heapq

imported by: JumperlessWokwiBridge.py • asyncio.base_events • asyncio.queues • collections • difflib • queue

hmac SourceModule

imports: _hashlib • _operator • hashlib • warnings

imported by: multiprocessing.connection • secrets • urllib3.util.ssl_

html Package

imports: html.entities • re

imported by: cgi • html.entities • html.parser • http.server • lxml.doctestcompare

html.entities SourceModule

imports: html

imported by: bs4.dammit • html • lxml.html.soupparser

html.parser SourceModule

imports: _markupbase • html • re

imported by: bs4.builder._htmlparser

html5lib MissingModule

imported by: bs4.builder._html5lib • lxml.html.html5parser

htmlentitydefs MissingModule

imported by: lxml.html.soupparser

http Package

imports: enum

imported by: http.client • http.cookiejar • http.cookies • http.server • requests.compat

http.client SourceModule

imports: collections.abc • email.message • email.parser • errno • http • io • re • socket • ssl • sys • urllib.parse • warnings

imported by: http.cookiejar • http.server • urllib.request • urllib3.connection • urllib3.exceptions • urllib3.response • urllib3.util.response • xmlrpc.client

http.cookiejar SourceModule

imports: calendar • copy • datetime • http • http.client • io • logging • os • re • threading • time • traceback • urllib.parse • urllib.request • warnings

imported by: requests.compat • urllib.request

http.cookies SourceModule

imports: http • re • string • time • types

imported by: requests.compat

http.server SourceModule

imports: argparse • base64 • binascii • contextlib • copy • datetime • email.utils • html • http • http.client • io • itertools • mimetypes • os • posixpath • pwd • select • shutil • socket • socketserver • subprocess • sys • time • urllib.parse

imported by: pydoc

idna Package

imports: idna • idna.core • idna.idnadata • idna.intranges • idna.package_data

imported by: idna • idna.core • idna.idnadata • idna.intranges • idna.package_data • idna.uts46data • requests.models • urllib3.contrib.pyopenssl • urllib3.util.url

idna.core SourceModule

imports: bisect • idna • idna.idnadata • idna.intranges • idna.uts46data • re • typing • unicodedata

imported by: idna

idna.idnadata SourceModule

imports: idna

imported by: idna • idna.core

idna.intranges SourceModule

imports: bisect • idna • typing

imported by: idna • idna.core

idna.package_data SourceModule

imports: idna

imported by: idna

idna.uts46data SourceModule

imports: idna • typing

imported by: idna.core

importlib Package

imports: _frozen_importlib • _frozen_importlib_external • _imp • importlib • importlib._bootstrap • importlib._bootstrap_external • importlib.machinery • sys • warnings

imported by: charset_normalizer.cd • charset_normalizer.utils • importlib • importlib._abc • importlib._bootstrap • importlib._bootstrap_external • importlib.abc • importlib.machinery • importlib.metadata • importlib.readers • importlib.resources • importlib.resources._common • importlib.util • inspect • pkgutil • serial

importlib._abc SourceModule

imports: abc • importlib • importlib._bootstrap • warnings

imported by: importlib.abc • importlib.util

importlib._bootstrap SourceModule

imports: _frozen_importlib_external • importlib

imported by: importlib • importlib._abc • importlib.machinery • importlib.util • pydoc

importlib._bootstrap_external SourceModule

imports: _imp • _io • _warnings • importlib • importlib.metadata • importlib.readers • marshal • nt • posix • sys • tokenize • winreg

imported by: importlib • importlib.abc • importlib.machinery • importlib.util • py_compile • pydoc

importlib.abc SourceModule

imports: _frozen_importlib • _frozen_importlib_external • abc • importlib • importlib._abc • importlib._bootstrap_external • importlib.machinery • importlib.resources.abc • warnings

imported by: importlib.metadata

importlib.machinery SourceModule

imports: importlib • importlib._bootstrap • importlib._bootstrap_external

imported by: importlib • importlib.abc • inspect • pkgutil • py_compile • pydoc • runpy

importlib.metadata Package

imports: abc • collections • contextlib • csv • email • functools • importlib • importlib.abc • importlib.metadata • importlib.metadata._adapters • importlib.metadata._collections • importlib.metadata._functools • importlib.metadata._itertools • importlib.metadata._meta • itertools • operator • os • pathlib • posixpath • re • sys • textwrap • typing • warnings • zipfile

imported by: importlib._bootstrap_external • importlib.metadata • importlib.metadata._adapters • importlib.metadata._collections • importlib.metadata._functools • importlib.metadata._itertools • importlib.metadata._meta • importlib.metadata._text

importlib.metadata._adapters SourceModule

imports: email.message • importlib.metadata • importlib.metadata._text • re • textwrap

imported by: importlib.metadata

importlib.metadata._collections SourceModule

imports: collections • importlib.metadata

imported by: importlib.metadata

importlib.metadata._functools SourceModule

imports: functools • importlib.metadata • types

imported by: importlib.metadata • importlib.metadata._text

importlib.metadata._itertools SourceModule

imports: importlib.metadata • itertools

imported by: importlib.metadata

importlib.metadata._meta SourceModule

imports: importlib.metadata • typing

imported by: importlib.metadata

importlib.metadata._text SourceModule

imports: importlib.metadata • importlib.metadata._functools • re

imported by: importlib.metadata._adapters

importlib.readers SourceModule

imports: importlib • importlib.resources.readers

imported by: importlib._bootstrap_external • zipimport

importlib.resources Package

imports: importlib • importlib.resources • importlib.resources._common • importlib.resources._legacy • importlib.resources.abc

imported by: certifi.core • importlib.resources • importlib.resources._adapters • importlib.resources._common • importlib.resources._itertools • importlib.resources._legacy • importlib.resources.abc • importlib.resources.readers

importlib.resources._adapters SourceModule

imports: contextlib • importlib.resources • importlib.resources.abc • io

imported by: importlib.resources._common

importlib.resources._common SourceModule

imports: contextlib • functools • importlib • importlib.resources • importlib.resources._adapters • importlib.resources.abc • os • pathlib • tempfile • types • typing

imported by: importlib.resources • importlib.resources._legacy

importlib.resources._itertools SourceModule

imports: importlib.resources • itertools • typing

imported by: importlib.resources.readers

importlib.resources._legacy SourceModule

imports: functools • importlib.resources • importlib.resources._common • os • pathlib • types • typing • warnings

imported by: importlib.resources

importlib.resources.abc SourceModule

imports: abc • importlib.resources • io • os • typing

imported by: importlib.abc • importlib.resources • importlib.resources._adapters • importlib.resources._common • importlib.resources.readers

importlib.resources.readers SourceModule

imports: collections • importlib.resources • importlib.resources._itertools • importlib.resources.abc • operator • pathlib • zipfile

imported by: importlib.readers

importlib.util SourceModule

imports: _imp • contextlib • functools • importlib • importlib._abc • importlib._bootstrap • importlib._bootstrap_external • sys • types • warnings

imported by: pkgutil • py_compile • pydoc • runpy • zipfile

inspect SourceModule

imports: abc • argparse • ast • builtins • collections • collections.abc • dis • enum • functools • importlib • importlib.machinery • itertools • keyword • linecache • operator • os • re • sys • token • tokenize • types

imported by: ast • asyncio.coroutines • asyncio.format_helpers • asyncio.tasks • bdb • dataclasses • doctest • pdb • pkgutil • psutil._common • pydoc • pyi_rth_inspect.py • typing_extensions • unittest.async_case

io SourceModule

imports: _io • abc • warnings

imported by: JumperlessWokwiBridge.py • _compression • asyncio.proactor_events • asyncio.unix_events • bs4.builder._lxml • bz2 • cgi • csv • dis • doctest • email.feedparser • email.generator • email.iterators • email.message • email.parser • encodings.quopri_codec • encodings.uu_codec • getpass • gzip • http.client • http.cookiejar • http.server • importlib.resources._adapters • importlib.resources.abc • logging • lzma • multiprocessing.connection • multiprocessing.popen_forkserver • multiprocessing.popen_spawn_posix • multiprocessing.reduction • os • pathlib • pdb • pickle • plistlib • pprint • pydoc • quopri • requests.compat • requests.models • requests.utils • runpy • serial.serialutil • shlex • socket • socketserver • subprocess • tarfile • tempfile • tokenize • unittest.result • urllib.error • urllib.request • urllib3.contrib.pyopenssl • urllib3.filepost • urllib3.response • urllib3.util.request • urllib3.util.ssltransport • xml.etree.ElementTree • xml.sax • xml.sax.saxutils • xmlrpc.client • zipfile

ipaddress SourceModule

imports: functools • re

imported by: JumperlessWokwiBridge.py • urllib.parse • urllib3.util.ssl_match_hostname

itertools (builtin module)

imported by: _pydecimal • asyncio.base_events • asyncio.tasks • asyncio.unix_events • asyncio.windows_utils • bs4.builder • calendar • collections • concurrent.futures.process • concurrent.futures.thread • dataclasses • glob • http.server • importlib.metadata • importlib.metadata._itertools • importlib.resources._itertools • inspect • multiprocessing.connection • multiprocessing.pool • multiprocessing.process • multiprocessing.util • pickle • platform • plistlib • random • reprlib • statistics • threading • tokenize • traceback • urllib3.util.retry • weakref • zipfile

java MissingModule

imported by: platform

json Package

imports: codecs • json.decoder • json.encoder • json.scanner

imported by: JumperlessWokwiBridge.py • charset_normalizer.models • json.decoder • json.encoder • json.scanner • pyduinocli.commands.base • requests.compat • urllib3._request_methods • urllib3.response

json.decoder SourceModule

imports: _json • json • json.scanner • re

imported by: _json • json

json.encoder SourceModule

imports: _json • json • re

imported by: json

json.scanner SourceModule

imports: _json • json • re

imported by: json • json.decoder

keyword SourceModule

imported by: JumperlessWokwiBridge.py • collections • dataclasses • inspect

linecache SourceModule

imports: functools • os • sys • tokenize

imported by: JumperlessWokwiBridge.py • asyncio.base_tasks • bdb • doctest • inspect • pdb • traceback • tracemalloc • warnings

locale SourceModule

imports: _collections_abc • _locale • builtins • encodings • encodings.aliases • functools • os • re • sys • warnings

imported by: JumperlessWokwiBridge.py • _pydecimal • _strptime • calendar • cgi • gettext • subprocess

logging Package

imports: atexit • collections.abc • io • os • pickle • re • string • sys • threading • time • traceback • types • warnings • weakref

imported by: asyncio.futures • asyncio.log • bs4.dammit • chardet.charsetprober • chardet.codingstatemachine • chardet.universaldetector • charset_normalizer • charset_normalizer.api • charset_normalizer.utils • concurrent.futures._base • hashlib • http.cookiejar • multiprocessing.util • requests • unittest._log • urllib3 • urllib3.connection • urllib3.connectionpool • urllib3.contrib.pyopenssl • urllib3.poolmanager • urllib3.response • urllib3.util.retry

lxml Package

imports: lxml • lxml.ElementInclude • lxml._elementpath • lxml.builder • lxml.cssselect • lxml.doctestcompare • lxml.etree • lxml.html • lxml.html.ElementSoup • lxml.html._diffcommand • lxml.html._html5builder • lxml.html._setmixin • lxml.html.builder • lxml.html.clean • lxml.html.defs • lxml.html.diff • lxml.html.formfill • lxml.html.html5parser • lxml.html.soupparser • lxml.html.usedoctest • lxml.includes • lxml.isoschematron • lxml.objectify • lxml.pyclasslookup • lxml.sax • lxml.usedoctest • os

imported by: bs4.builder._lxml • lxml • lxml.ElementInclude • lxml._elementpath • lxml.builder • lxml.cssselect • lxml.doctestcompare • lxml.etree • lxml.html • lxml.html._html5builder • lxml.html.html5parser • lxml.html.soupparser • lxml.html.usedoctest • lxml.includes • lxml.isoschematron • lxml.objectify • lxml.pyclasslookup • lxml.sax • lxml.usedoctest

lxml.ElementInclude SourceModule

imports: lxml • lxml.etree • urllib.parse • urllib.request • urllib2 • urlparse

imported by: lxml

lxml._elementpath /Users/kevinsanto/Library/Python/3.11/lib/python/site-packages/lxml/_elementpath.cpython-311-darwin.so

imports: lxml

imported by: lxml • lxml.etree

lxml.builder /Users/kevinsanto/Library/Python/3.11/lib/python/site-packages/lxml/builder.cpython-311-darwin.so

imports: lxml

imported by: lxml • lxml.html.builder

lxml.cssselect SourceModule

imports: __future__ • cssselect • lxml • lxml.etree

imported by: lxml • lxml.html

lxml.doctestcompare SourceModule

imports: cgi • doctest • html • lxml • lxml.etree • re • sys

imported by: lxml • lxml.html.usedoctest • lxml.usedoctest

lxml.etree /Users/kevinsanto/Library/Python/3.11/lib/python/site-packages/lxml/etree.cpython-311-darwin.so

imports: contextlib • gzip • lxml • lxml._elementpath

imported by: bs4.builder._lxml • lxml • lxml.ElementInclude • lxml.cssselect • lxml.doctestcompare • lxml.html • lxml.html._html5builder • lxml.html.formfill • lxml.html.html5parser • lxml.html.soupparser • lxml.isoschematron • lxml.objectify • lxml.pyclasslookup

lxml.html Package

imports: __future__ • collections • collections.MutableMapping • collections.MutableSet • collections.abc • copy • functools • lxml • lxml.cssselect • lxml.etree • lxml.html • lxml.html._setmixin • lxml.html.defs • os • re • sys • tempfile • urllib • urllib.parse • urllib.request • urllib.urlencode • urllib.urlopen • urlparse • webbrowser

imported by: lxml • lxml.html • lxml.html.ElementSoup • lxml.html._diffcommand • lxml.html._html5builder • lxml.html._setmixin • lxml.html.builder • lxml.html.clean • lxml.html.defs • lxml.html.diff • lxml.html.formfill • lxml.html.html5parser • lxml.html.soupparser • lxml.html.usedoctest

lxml.html.ElementSoup SourceModule

imports: lxml.html • lxml.html.soupparser

imported by: lxml

lxml.html._diffcommand SourceModule

imports: __future__ • lxml.html • lxml.html.diff • optparse • os • re • sys

imported by: lxml

lxml.html._html5builder SourceModule

imports: 'html5lib.treebuilders' • lxml • lxml.etree • lxml.html

imported by: lxml

lxml.html._setmixin SourceModule

imports: collections • collections.MutableSet • collections.abc • lxml.html

imported by: lxml • lxml.html

lxml.html.builder SourceModule

imports: lxml.builder • lxml.html

imported by: lxml

lxml.html.clean /Users/kevinsanto/Library/Python/3.11/lib/python/site-packages/lxml/html/clean.cpython-311-darwin.so

imports: lxml.html

imported by: lxml

lxml.html.defs SourceModule

imports: lxml.html

imported by: lxml • lxml.html • lxml.html.formfill

lxml.html.diff /Users/kevinsanto/Library/Python/3.11/lib/python/site-packages/lxml/html/diff.cpython-311-darwin.so

imports: lxml.html

imported by: lxml • lxml.html._diffcommand

lxml.html.formfill SourceModule

imports: copy • lxml.etree • lxml.html • lxml.html.defs

imported by: lxml

lxml.html.html5parser SourceModule

imports: 'html5lib.treebuilders' • html5lib • lxml • lxml.etree • lxml.html • string • sys • urllib.parse • urllib.request • urllib2 • urlparse

imported by: lxml

lxml.html.soupparser SourceModule

imports: BeautifulSoup • bs4 • html.entities • htmlentitydefs • lxml • lxml.etree • lxml.html • re

imported by: lxml • lxml.html.ElementSoup

lxml.html.usedoctest SourceModule

imports: lxml • lxml.doctestcompare • lxml.html

imported by: lxml

lxml.includes Package

imports: lxml

imported by: lxml

lxml.isoschematron Package

imports: lxml • lxml.etree • posixpath • sys

imported by: lxml

lxml.objectify /Users/kevinsanto/Library/Python/3.11/lib/python/site-packages/lxml/objectify.cpython-311-darwin.so

imports: lxml • lxml.etree

imported by: lxml

lxml.pyclasslookup SourceModule

imports: lxml • lxml.etree

imported by: lxml

lxml.sax /Users/kevinsanto/Library/Python/3.11/lib/python/site-packages/lxml/sax.cpython-311-darwin.so

imports: lxml

imported by: lxml

lxml.usedoctest SourceModule

imports: lxml • lxml.doctestcompare

imported by: lxml

lzma SourceModule

imports: _compression • _lzma • builtins • io • os

imported by: shutil • tarfile • zipfile

marshal (builtin module)

imported by: importlib._bootstrap_external • pkgutil • zipimport

math /Library/Frameworks/Python.framework/Versions/3.11/lib/python3.11/lib-dynload/math.cpython-311-darwin.so

imported by: _pydecimal • asyncio.windows_events • datetime • fractions • random • selectors • statistics

mimetypes SourceModule

imports: _winapi • getopt • os • posixpath • sys • urllib.parse • winreg

imported by: http.server • urllib.request • urllib3.fields

mmap /Library/Frameworks/Python.framework/Versions/3.11/lib/python3.11/lib-dynload/mmap.cpython-311-darwin.so

imported by: multiprocessing.heap • multiprocessing.shared_memory

msvcrt MissingModule

imported by: asyncio.windows_events • asyncio.windows_utils • getpass • multiprocessing.popen_spawn_win32 • multiprocessing.spawn • subprocess

multiprocessing Package

imports: multiprocessing • multiprocessing.AuthenticationError • multiprocessing.BufferTooShort • multiprocessing.TimeoutError • multiprocessing.connection • multiprocessing.context • multiprocessing.forkserver • multiprocessing.get_context • multiprocessing.get_start_method • multiprocessing.pool • multiprocessing.process • multiprocessing.reduction • multiprocessing.resource_sharer • multiprocessing.resource_tracker • multiprocessing.set_start_method • multiprocessing.shared_memory • multiprocessing.spawn • multiprocessing.util • sys

imported by: concurrent.futures.process • multiprocessing • multiprocessing.connection • multiprocessing.context • multiprocessing.dummy • multiprocessing.forkserver • multiprocessing.heap • multiprocessing.managers • multiprocessing.pool • multiprocessing.popen_fork • multiprocessing.popen_forkserver • multiprocessing.popen_spawn_posix • multiprocessing.popen_spawn_win32 • multiprocessing.process • multiprocessing.queues • multiprocessing.reduction • multiprocessing.resource_sharer • multiprocessing.resource_tracker • multiprocessing.shared_memory • multiprocessing.sharedctypes • multiprocessing.spawn • multiprocessing.synchronize • multiprocessing.util • pyi_rth_multiprocessing.py

multiprocessing.AuthenticationError MissingModule

imported by: multiprocessing • multiprocessing.connection

multiprocessing.BufferTooShort MissingModule

imported by: multiprocessing • multiprocessing.connection

multiprocessing.TimeoutError MissingModule

imported by: multiprocessing • multiprocessing.pool

multiprocessing.connection SourceModule

imports: _multiprocessing • _winapi • hmac • io • itertools • multiprocessing • multiprocessing.AuthenticationError • multiprocessing.BufferTooShort • multiprocessing.context • multiprocessing.resource_sharer • multiprocessing.util • os • selectors • socket • struct • sys • tempfile • time • xmlrpc.client

imported by: concurrent.futures.process • multiprocessing • multiprocessing.context • multiprocessing.forkserver • multiprocessing.managers • multiprocessing.pool • multiprocessing.popen_fork • multiprocessing.popen_forkserver • multiprocessing.process • multiprocessing.queues • multiprocessing.resource_sharer

multiprocessing.context SourceModule

imports: multiprocessing • multiprocessing.connection • multiprocessing.forkserver • multiprocessing.managers • multiprocessing.pool • multiprocessing.popen_fork • multiprocessing.popen_forkserver • multiprocessing.popen_spawn_posix • multiprocessing.popen_spawn_win32 • multiprocessing.process • multiprocessing.queues • multiprocessing.reduction • multiprocessing.sharedctypes • multiprocessing.spawn • multiprocessing.synchronize • multiprocessing.util • os • sys • threading

imported by: multiprocessing • multiprocessing.connection • multiprocessing.forkserver • multiprocessing.heap • multiprocessing.managers • multiprocessing.popen_forkserver • multiprocessing.popen_spawn_posix • multiprocessing.popen_spawn_win32 • multiprocessing.process • multiprocessing.queues • multiprocessing.reduction • multiprocessing.resource_sharer • multiprocessing.sharedctypes • multiprocessing.spawn • multiprocessing.synchronize

multiprocessing.dummy Package

imports: array • multiprocessing • multiprocessing.dummy.connection • multiprocessing.pool • queue • sys • threading • weakref

imported by: multiprocessing.dummy.connection • multiprocessing.pool

multiprocessing.dummy.connection SourceModule

imports: multiprocessing.dummy • queue

imported by: multiprocessing.dummy

multiprocessing.forkserver SourceModule

imports: errno • multiprocessing • multiprocessing.connection • multiprocessing.context • multiprocessing.process • multiprocessing.resource_tracker • multiprocessing.spawn • multiprocessing.util • os • selectors • signal • socket • struct • sys • threading • warnings

imported by: multiprocessing • multiprocessing.context • multiprocessing.popen_forkserver • multiprocessing.util

multiprocessing.get_context MissingModule

imported by: multiprocessing • multiprocessing.managers • multiprocessing.pool • multiprocessing.sharedctypes

multiprocessing.get_start_method MissingModule

imported by: multiprocessing • multiprocessing.spawn

multiprocessing.heap SourceModule

imports: _winapi • bisect • collections • mmap • multiprocessing • multiprocessing.context • multiprocessing.util • os • sys • tempfile • threading

imported by: multiprocessing.sharedctypes • multiprocessing.synchronize

multiprocessing.managers SourceModule

imports: array • multiprocessing • multiprocessing.connection • multiprocessing.context • multiprocessing.get_context • multiprocessing.pool • multiprocessing.process • multiprocessing.resource_tracker • multiprocessing.shared_memory • multiprocessing.util • os • queue • signal • sys • threading • time • traceback • types

imported by: multiprocessing.context

multiprocessing.pool SourceModule

imports: collections • itertools • multiprocessing • multiprocessing.TimeoutError • multiprocessing.connection • multiprocessing.dummy • multiprocessing.get_context • multiprocessing.util • os • queue • threading • time • traceback • types • warnings

imported by: multiprocessing • multiprocessing.context • multiprocessing.dummy • multiprocessing.managers

multiprocessing.popen_fork SourceModule

imports: multiprocessing • multiprocessing.connection • multiprocessing.util • os • signal

imported by: multiprocessing.context • multiprocessing.popen_forkserver • multiprocessing.popen_spawn_posix

multiprocessing.popen_forkserver SourceModule

imports: io • multiprocessing • multiprocessing.connection • multiprocessing.context • multiprocessing.forkserver • multiprocessing.popen_fork • multiprocessing.spawn • multiprocessing.util • os

imported by: multiprocessing.context • pyi_rth_multiprocessing.py

multiprocessing.popen_spawn_posix SourceModule

imports: io • multiprocessing • multiprocessing.context • multiprocessing.popen_fork • multiprocessing.resource_tracker • multiprocessing.spawn • multiprocessing.util • os

imported by: multiprocessing.context • pyi_rth_multiprocessing.py

multiprocessing.popen_spawn_win32 SourceModule

imports: _winapi • msvcrt • multiprocessing • multiprocessing.context • multiprocessing.spawn • multiprocessing.util • os • signal • sys

imported by: multiprocessing.context • pyi_rth_multiprocessing.py

multiprocessing.process SourceModule

imports: _weakrefset • itertools • multiprocessing • multiprocessing.connection • multiprocessing.context • multiprocessing.util • os • signal • sys • threading • traceback

imported by: multiprocessing • multiprocessing.context • multiprocessing.forkserver • multiprocessing.managers • multiprocessing.resource_sharer • multiprocessing.spawn • multiprocessing.synchronize • multiprocessing.util

multiprocessing.queues SourceModule

imports: _multiprocessing • collections • errno • multiprocessing • multiprocessing.connection • multiprocessing.context • multiprocessing.synchronize • multiprocessing.util • os • queue • sys • threading • time • traceback • types • weakref

imported by: concurrent.futures.process • multiprocessing.context

multiprocessing.reduction SourceModule

imports: _winapi • abc • array • copyreg • functools • io • multiprocessing • multiprocessing.context • multiprocessing.resource_sharer • os • pickle • socket • sys

imported by: multiprocessing • multiprocessing.context

multiprocessing.resource_sharer SourceModule

imports: multiprocessing • multiprocessing.connection • multiprocessing.context • multiprocessing.process • multiprocessing.util • os • signal • socket • sys • threading

imported by: multiprocessing • multiprocessing.connection • multiprocessing.reduction

multiprocessing.resource_tracker SourceModule

imports: _multiprocessing • _posixshmem • multiprocessing • multiprocessing.spawn • multiprocessing.util • os • signal • sys • threading • warnings

imported by: multiprocessing • multiprocessing.forkserver • multiprocessing.managers • multiprocessing.popen_spawn_posix • multiprocessing.shared_memory • multiprocessing.spawn • multiprocessing.synchronize • multiprocessing.util

multiprocessing.set_start_method MissingModule

imported by: multiprocessing • multiprocessing.spawn

multiprocessing.shared_memory SourceModule

imports: _posixshmem • _winapi • errno • functools • mmap • multiprocessing • multiprocessing.resource_tracker • os • secrets • struct • types

imported by: multiprocessing • multiprocessing.managers

multiprocessing.sharedctypes SourceModule

imports: ctypes • multiprocessing • multiprocessing.context • multiprocessing.get_context • multiprocessing.heap • weakref

imported by: multiprocessing.context

multiprocessing.spawn SourceModule

imports: _winapi • msvcrt • multiprocessing • multiprocessing.context • multiprocessing.get_start_method • multiprocessing.process • multiprocessing.resource_tracker • multiprocessing.set_start_method • multiprocessing.util • os • runpy • sys • types

imported by: multiprocessing • multiprocessing.context • multiprocessing.forkserver • multiprocessing.popen_forkserver • multiprocessing.popen_spawn_posix • multiprocessing.popen_spawn_win32 • multiprocessing.resource_tracker • pyi_rth_multiprocessing.py

multiprocessing.synchronize SourceModule

imports: _multiprocessing • multiprocessing • multiprocessing.context • multiprocessing.heap • multiprocessing.process • multiprocessing.resource_tracker • multiprocessing.util • struct • sys • tempfile • threading • time

imported by: concurrent.futures.process • multiprocessing.context • multiprocessing.queues

multiprocessing.util SourceModule

imports: _posixsubprocess • atexit • itertools • logging • multiprocessing • multiprocessing.forkserver • multiprocessing.process • multiprocessing.resource_tracker • os • shutil • subprocess • sys • tempfile • threading • traceback • weakref

imported by: multiprocessing • multiprocessing.connection • multiprocessing.context • multiprocessing.forkserver • multiprocessing.heap • multiprocessing.managers • multiprocessing.pool • multiprocessing.popen_fork • multiprocessing.popen_forkserver • multiprocessing.popen_spawn_posix • multiprocessing.popen_spawn_win32 • multiprocessing.process • multiprocessing.queues • multiprocessing.resource_sharer • multiprocessing.resource_tracker • multiprocessing.spawn • multiprocessing.synchronize

netrc SourceModule

imports: os • pwd • shlex • stat

imported by: ftplib • requests.utils

nt MissingModule

imported by: ctypes • importlib._bootstrap_external • ntpath • os • shutil

ntpath SourceModule

imports: _winapi • genericpath • nt • os • stat • string • sys

imported by: JumperlessWokwiBridge.py • os • pathlib

nturl2path SourceModule

imports: string • urllib.parse

imported by: urllib.request

numbers SourceModule

imports: abc

imported by: _pydecimal • fractions • statistics

opcode SourceModule

imports: _opcode

imported by: dis

operator SourceModule

imports: _operator • builtins • functools

imported by: JumperlessWokwiBridge.py • collections • copyreg • datetime • email._header_value_parser • enum • fractions • importlib.metadata • importlib.resources.readers • inspect • pathlib • random • statistics • typing • typing_extensions

optparse SourceModule

imports: gettext • os • sys • textwrap

imported by: lxml.html._diffcommand

org MissingModule

imported by: copy

os SourceModule

imports: _collections_abc • abc • io • nt • ntpath • posix • posixpath • posixpath • stat • subprocess • sys • warnings

imported by: JumperlessWokwiBridge.py • _bootsubprocess • _osx_support • argparse • asyncio.base_events • asyncio.coroutines • asyncio.events • asyncio.proactor_events • asyncio.unix_events • asyncio.windows_utils • bdb • bs4 • bz2 • certifi.core • cgi • charset_normalizer.api • concurrent.futures.process • concurrent.futures.thread • contextlib • ctypes • curses • doctest • email.utils • fnmatch • genericpath • getopt • getpass • gettext • glob • gzip • http.cookiejar • http.server • importlib.metadata • importlib.resources._common • importlib.resources._legacy • importlib.resources.abc • inspect • linecache • locale • logging • lxml • lxml.html • lxml.html._diffcommand • lzma • mimetypes • multiprocessing.connection • multiprocessing.context • multiprocessing.forkserver • multiprocessing.heap • multiprocessing.managers • multiprocessing.pool • multiprocessing.popen_fork • multiprocessing.popen_forkserver • multiprocessing.popen_spawn_posix • multiprocessing.popen_spawn_win32 • multiprocessing.process • multiprocessing.queues • multiprocessing.reduction • multiprocessing.resource_sharer • multiprocessing.resource_tracker • multiprocessing.shared_memory • multiprocessing.spawn • multiprocessing.util • netrc • ntpath • optparse • pathlib • pdb • pkgutil • platform • plistlib • posixpath • posixpath • psutil • psutil._common • psutil._compat • psutil._psaix • psutil._psbsd • psutil._pslinux • psutil._psosx • psutil._psposix • psutil._pssunos • psutil._pswindows • py_compile • pydoc • pyi_rth_inspect.py • pyi_rth_multiprocessing.py • pyi_rth_pkgutil.py • random • requests.auth • requests.sessions • requests.utils • runpy • serial • serial.serialposix • serial.tools.list_ports • serial.tools.list_ports_common • serial.tools.list_ports_linux • serial.tools.list_ports_posix • shlex • shutil • socket • socketserver • ssl • subprocess • sysconfig • tarfile • tempfile • threading • unittest.loader • unittest.main • urllib.request • urllib3.connection • urllib3.filepost • urllib3.util.ssl_ • webbrowser • xml.sax • xml.sax.saxutils • zipfile

pathlib SourceModule

imports: _collections_abc • errno • fnmatch • functools • grp • io • ntpath • operator • os • posixpath • pwd • re • stat • sys • urllib.parse • warnings

imported by: JumperlessWokwiBridge.py • importlib.metadata • importlib.resources._common • importlib.resources._legacy • importlib.resources.readers • zipfile

pdb SourceModule

imports: bdb • cmd • code • dis • functools • getopt • glob • inspect • io • linecache • os • pdb • pprint • pydoc • re • readline • runpy • shlex • signal • sys • tokenize • traceback • typing

imported by: doctest • pdb

pickle SourceModule

imports: 'org.python' • _compat_pickle • _pickle • codecs • copyreg • functools • io • itertools • pprint • re • struct • sys • types

imported by: logging • multiprocessing.reduction • tracemalloc

pkgutil SourceModule

imports: collections • functools • importlib • importlib.machinery • importlib.util • inspect • marshal • os • posixpath • re • sys • types • warnings • zipimport

imported by: pydoc • pyi_rth_pkgutil.py • runpy

platform SourceModule

imports: 'java.lang' • _winreg • collections • functools • itertools • java • os • plistlib • re • socket • struct • subprocess • sys • vms_lib • winreg

imported by: psutil._compat • pydoc

plistlib SourceModule

imports: binascii • codecs • datetime • enum • io • itertools • os • re • struct • xml.parsers.expat

imported by: platform

posix (builtin module)

imports: resource

imported by: importlib._bootstrap_external • os • posixpath • shutil

posixpath AliasNode

imports: os • posixpath

imported by: lxml.isoschematron • os • pkgutil • py_compile • requests.adapters • serial.tools.list_ports_common • sysconfig • tracemalloc • unittest • unittest.util

posixpath SourceModule

imports: genericpath • os • posix • pwd • re • stat • sys

imported by: JumperlessWokwiBridge.py • fnmatch • http.server • importlib.metadata • mimetypes • os • pathlib • posixpath • urllib.request • zipfile

pprint SourceModule

imports: collections • dataclasses • io • re • sys • time • types

imported by: pdb • pickle • sysconfig • unittest.case

psutil Package

imports: __future__ • collections • contextlib • datetime • functools • os • psutil • psutil._common • psutil._compat • psutil._psaix • psutil._psbsd • psutil._pslinux • psutil._psosx • psutil._psposix • psutil._pssunos • psutil._psutil_aix • psutil._psutil_bsd • psutil._psutil_linux • psutil._psutil_osx • psutil._psutil_posix • psutil._psutil_sunos • psutil._psutil_windows • psutil._pswindows • pwd • signal • socket • subprocess • sys • threading • time

imported by: JumperlessWokwiBridge.py • psutil • psutil._common • psutil._compat • psutil._psaix • psutil._psbsd • psutil._pslinux • psutil._psosx • psutil._psposix • psutil._pssunos • psutil._psutil_osx • psutil._psutil_posix • psutil._psutil_windows • psutil._pswindows

psutil._common SourceModule

imports: __future__ • collections • contextlib • ctypes • curses • enum • errno • functools • inspect • os • psutil • socket • stat • sys • threading • warnings

imported by: psutil • psutil._psaix • psutil._psbsd • psutil._pslinux • psutil._psosx • psutil._psposix • psutil._pssunos • psutil._pswindows

psutil._compat SourceModule

imports: collections • contextlib • dummy_threading • errno • fcntl • functools • os • platform • psutil • shutil • struct • subprocess • sys • termios • threading • types

imported by: psutil • psutil._psaix • psutil._psbsd • psutil._pslinux • psutil._psosx • psutil._psposix • psutil._pssunos • psutil._pswindows

psutil._psaix SourceModule

imports: collections • functools • glob • os • psutil • psutil._common • psutil._compat • psutil._psposix • psutil._psutil_aix • psutil._psutil_posix • re • subprocess • sys

imported by: psutil

psutil._psbsd SourceModule

imports: collections • contextlib • errno • functools • os • psutil • psutil._common • psutil._compat • psutil._psposix • psutil._psutil_bsd • psutil._psutil_posix • xml.etree • xml.etree.ElementTree

imported by: psutil

psutil._pslinux SourceModule

imports: __future__ • base64 • collections • ctypes • enum • errno • functools • glob • os • psutil • psutil._common • psutil._compat • psutil._psposix • psutil._psutil_linux • psutil._psutil_posix • re • resource • socket • struct • sys • warnings

imported by: psutil

psutil._psosx SourceModule

imports: collections • errno • functools • os • psutil • psutil._common • psutil._compat • psutil._psposix • psutil._psutil_osx • psutil._psutil_posix

imported by: psutil

psutil._psposix SourceModule

imports: enum • glob • os • psutil • psutil._common • psutil._compat • psutil._psutil_osx • signal • sys • time

imported by: psutil • psutil._psaix • psutil._psbsd • psutil._pslinux • psutil._psosx • psutil._pssunos

psutil._pssunos SourceModule

imports: collections • errno • functools • os • psutil • psutil._common • psutil._compat • psutil._psposix • psutil._psutil_posix • psutil._psutil_sunos • socket • subprocess • sys

imported by: psutil

psutil._psutil_aix MissingModule

imported by: psutil • psutil._psaix

psutil._psutil_bsd MissingModule

imported by: psutil • psutil._psbsd

psutil._psutil_linux MissingModule

imported by: psutil • psutil._pslinux

psutil._psutil_osx /Library/Frameworks/Python.framework/Versions/3.11/lib/python3.11/site-packages/psutil/_psutil_osx.abi3.so

imports: psutil

imported by: psutil • psutil._psosx • psutil._psposix

psutil._psutil_posix /Library/Frameworks/Python.framework/Versions/3.11/lib/python3.11/site-packages/psutil/_psutil_posix.abi3.so

imports: psutil

imported by: psutil • psutil._psaix • psutil._psbsd • psutil._pslinux • psutil._psosx • psutil._pssunos

psutil._psutil_sunos MissingModule

imported by: psutil • psutil._pssunos

psutil._psutil_windows MissingModule

imports: psutil

imported by: psutil • psutil._pswindows

psutil._pswindows SourceModule

imports: _psutil_windows • collections • contextlib • enum • errno • functools • os • psutil • psutil._common • psutil._compat • psutil._psutil_windows • signal • sys • time

imported by: psutil

pwd (builtin module)

imported by: getpass • http.server • netrc • pathlib • posixpath • psutil • shutil • subprocess • tarfile • webbrowser

py_compile SourceModule

imports: argparse • enum • importlib._bootstrap_external • importlib.machinery • importlib.util • os • posixpath • sys • traceback

imported by: zipfile

pydoc SourceModule

imports: __future__ • builtins • collections • email.message • getopt • http.server • importlib._bootstrap • importlib._bootstrap_external • importlib.machinery • importlib.util • inspect • io • os • pkgutil • platform • pydoc_data.topics • re • reprlib • select • subprocess • sys • sysconfig • tempfile • textwrap • threading • time • tokenize • traceback • tty • urllib.parse • warnings • webbrowser

imported by: pdb

pydoc_data Package

imported by: pydoc_data.topics

pydoc_data.topics SourceModule

imports: pydoc_data

imported by: pydoc

pyduinocli Package

imports: pyduinocli.commands.arduino • pyduinocli.errors.arduinoerror

imported by: JumperlessWokwiBridge.py • pyduinocli.commands • pyduinocli.constants • pyduinocli.errors

pyduinocli.commands Package

imports: pyduinocli

imported by: pyduinocli.commands.arduino • pyduinocli.commands.base • pyduinocli.commands.board • pyduinocli.commands.burn_bootloader • pyduinocli.commands.cache • pyduinocli.commands.compile • pyduinocli.commands.completion • pyduinocli.commands.config • pyduinocli.commands.core • pyduinocli.commands.daemon • pyduinocli.commands.debug • pyduinocli.commands.lib • pyduinocli.commands.monitor • pyduinocli.commands.outdated • pyduinocli.commands.sketch • pyduinocli.commands.update • pyduinocli.commands.upgrade • pyduinocli.commands.upload • pyduinocli.commands.version

pyduinocli.commands.arduino SourceModule

imports: pyduinocli.commands • pyduinocli.commands.base • pyduinocli.commands.board • pyduinocli.commands.burn_bootloader • pyduinocli.commands.cache • pyduinocli.commands.compile • pyduinocli.commands.completion • pyduinocli.commands.config • pyduinocli.commands.core • pyduinocli.commands.daemon • pyduinocli.commands.debug • pyduinocli.commands.lib • pyduinocli.commands.monitor • pyduinocli.commands.outdated • pyduinocli.commands.sketch • pyduinocli.commands.update • pyduinocli.commands.upgrade • pyduinocli.commands.upload • pyduinocli.commands.version • pyduinocli.constants • pyduinocli.constants.flags

imported by: pyduinocli

pyduinocli.commands.base SourceModule

imports: json • pyduinocli.commands • pyduinocli.errors.arduinoerror • subprocess

imported by: pyduinocli.commands.arduino • pyduinocli.commands.board • pyduinocli.commands.burn_bootloader • pyduinocli.commands.cache • pyduinocli.commands.compile • pyduinocli.commands.completion • pyduinocli.commands.config • pyduinocli.commands.core • pyduinocli.commands.daemon • pyduinocli.commands.debug • pyduinocli.commands.lib • pyduinocli.commands.monitor • pyduinocli.commands.outdated • pyduinocli.commands.sketch • pyduinocli.commands.update • pyduinocli.commands.upgrade • pyduinocli.commands.upload • pyduinocli.commands.version

pyduinocli.commands.board SourceModule

imports: pyduinocli.commands • pyduinocli.commands.base • pyduinocli.constants • pyduinocli.constants.commands • pyduinocli.constants.flags

imported by: pyduinocli.commands.arduino

pyduinocli.commands.burn_bootloader SourceModule

imports: pyduinocli.commands • pyduinocli.commands.base • pyduinocli.constants • pyduinocli.constants.commands • pyduinocli.constants.flags

imported by: pyduinocli.commands.arduino

pyduinocli.commands.cache SourceModule

imports: pyduinocli.commands • pyduinocli.commands.base • pyduinocli.constants • pyduinocli.constants.commands

imported by: pyduinocli.commands.arduino

pyduinocli.commands.compile SourceModule

imports: pyduinocli.commands • pyduinocli.commands.base • pyduinocli.constants • pyduinocli.constants.commands • pyduinocli.constants.flags

imported by: pyduinocli.commands.arduino

pyduinocli.commands.completion SourceModule

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

pyduinocli.constants.flags SourceModule

imports: pyduinocli.constants

imported by: pyduinocli.commands.arduino • pyduinocli.commands.board • pyduinocli.commands.burn_bootloader • pyduinocli.commands.compile • pyduinocli.commands.completion • pyduinocli.commands.config • pyduinocli.commands.core • pyduinocli.commands.daemon • pyduinocli.commands.debug • pyduinocli.commands.lib • pyduinocli.commands.monitor • pyduinocli.commands.sketch • pyduinocli.commands.update • pyduinocli.commands.upgrade • pyduinocli.commands.upload • pyduinocli.constants

pyduinocli.errors Package

imports: pyduinocli

imported by: pyduinocli.errors.arduinoerror

pyduinocli.errors.arduinoerror SourceModule

imports: pyduinocli.errors

imported by: pyduinocli • pyduinocli.commands.base

pyexpat /Library/Frameworks/Python.framework/Versions/3.11/lib/python3.11/lib-dynload/pyexpat.cpython-311-darwin.so

imported by: _elementtree • xml.etree.ElementTree • xml.parsers.expat

pyimod02_importers MissingModule

imported by: pyi_rth_pkgutil.py

queue SourceModule

imports: _queue • collections • heapq • threading • time • types

imported by: concurrent.futures.process • concurrent.futures.thread • multiprocessing.dummy • multiprocessing.dummy.connection • multiprocessing.managers • multiprocessing.pool • multiprocessing.queues • urllib3.connectionpool

quopri SourceModule

imports: binascii • getopt • io • sys

imported by: email.encoders • email.message • encodings.quopri_codec

random SourceModule

imports: _collections_abc • _random • _sha512 • bisect • hashlib • itertools • math • operator • os • statistics • time • warnings

imported by: email.generator • email.utils • secrets • statistics • tempfile • urllib3.util.retry

re Package

imports: copyreg • enum • functools • re • re._compiler • re._constants • re._parser • warnings

imported by: JumperlessWokwiBridge.py • _markupbase • _osx_support • _pydecimal • _sre • _strptime • argparse • base64 • bs4 • bs4.builder • bs4.builder._html5lib • bs4.dammit • bs4.element • cgi • chardet.charsetprober • chardet.universaldetector • charset_normalizer.constant • charset_normalizer.utils • csv • dataclasses • difflib • doctest • email._encoded_words • email._header_value_parser • email.feedparser • email.generator • email.header • email.message • email.policy • email.quoprimime • email.utils • encodings.idna • fnmatch • fractions • ftplib • gettext • glob • html • html.parser • http.client • http.cookiejar • http.cookies • idna.core • importlib.metadata • importlib.metadata._adapters • importlib.metadata._text • inspect • ipaddress • json.decoder • json.encoder • json.scanner • locale • logging • lxml.doctestcompare • lxml.html • lxml.html._diffcommand • lxml.html.soupparser • pathlib • pdb • pickle • pkgutil • platform • plistlib • posixpath • pprint • psutil._psaix • psutil._pslinux • pydoc • re • re._casefix • re._compiler • re._constants • re._parser • requests._internal_utils • requests.auth • requests.utils • serial.tools.list_ports • serial.tools.list_ports_common • serial.tools.list_ports_windows • shlex • soupsieve.__meta__ • soupsieve.css_match • soupsieve.css_parser • soupsieve.pretty • soupsieve.util • sre_compile • sre_constants • sre_parse • string • sysconfig • tarfile • textwrap • tokenize • typing • unittest.case • unittest.loader • urllib.parse • urllib.request • urllib3.connection • urllib3.response • urllib3.util.retry • urllib3.util.ssl_match_hostname • urllib3.util.url • warnings • xml.etree.ElementPath • xml.etree.ElementTree

re._casefix SourceModule

imports: re

imported by: JumperlessWokwiBridge.py • re._compiler

re._compiler SourceModule

imports: _sre • re • re._casefix • re._constants • re._parser • sys

imported by: JumperlessWokwiBridge.py • re • sre_compile

re._constants SourceModule

imports: _sre • re

imported by: JumperlessWokwiBridge.py • re • re._compiler • re._parser • sre_constants

re._parser SourceModule

imports: re • re._constants • unicodedata • warnings

imported by: JumperlessWokwiBridge.py • re • re._compiler • sre_parse

readline /Library/Frameworks/Python.framework/Versions/3.11/lib/python3.11/lib-dynload/readline.cpython-311-darwin.so

imported by: cmd • code • pdb

reprlib SourceModule

imports: _thread • builtins • itertools

imported by: JumperlessWokwiBridge.py • asyncio.base_futures • asyncio.base_tasks • asyncio.format_helpers • bdb • collections • functools • pydoc

requests Package

imports: chardet • charset_normalizer • cryptography • logging • requests • requests.__version__ • requests.api • requests.certs • requests.exceptions • requests.models • requests.packages • requests.sessions • requests.status_codes • requests.utils • ssl • urllib3 • urllib3.contrib • urllib3.contrib.pyopenssl • urllib3.exceptions • warnings

imported by: JumperlessWokwiBridge.py • requests • requests.__version__ • requests._internal_utils • requests.adapters • requests.api • requests.auth • requests.certs • requests.compat • requests.cookies • requests.exceptions • requests.hooks • requests.models • requests.packages • requests.sessions • requests.status_codes • requests.structures • requests.utils

requests.__version__ SourceModule

imports: requests

imported by: requests • requests.utils

requests._internal_utils SourceModule

imports: re • requests • requests.compat

imported by: requests.auth • requests.cookies • requests.models • requests.sessions • requests.utils

requests.adapters SourceModule

imports: posixpath • requests • requests.auth • requests.compat • requests.cookies • requests.exceptions • requests.models • requests.structures • requests.utils • socket • urllib3.contrib.socks • urllib3.exceptions • urllib3.poolmanager • urllib3.util • urllib3.util.retry

imported by: requests.sessions

requests.api SourceModule

imports: requests • requests.sessions

imported by: requests

requests.auth SourceModule

imports: base64 • hashlib • os • re • requests • requests._internal_utils • requests.compat • requests.cookies • requests.utils • threading • time • warnings

imported by: requests.adapters • requests.models • requests.sessions

requests.certs SourceModule

imports: certifi • requests

imported by: requests • requests.utils

requests.compat SourceModule

imports: chardet • charset_normalizer • collections • collections.abc • http • http.cookiejar • http.cookies • io • json • requests • simplejson • sys • urllib.parse • urllib.request

imported by: requests._internal_utils • requests.adapters • requests.auth • requests.cookies • requests.exceptions • requests.models • requests.sessions • requests.structures • requests.utils

requests.cookies SourceModule

imports: calendar • copy • dummy_threading • requests • requests._internal_utils • requests.compat • threading • time

imported by: requests.adapters • requests.auth • requests.models • requests.sessions • requests.utils

requests.exceptions SourceModule

imports: requests • requests.compat • urllib3.exceptions

imported by: requests • requests.adapters • requests.models • requests.sessions • requests.utils

requests.hooks SourceModule

imports: requests

imported by: requests.models • requests.sessions

requests.models SourceModule

imports: datetime • encodings.idna • idna • io • requests • requests._internal_utils • requests.auth • requests.compat • requests.cookies • requests.exceptions • requests.hooks • requests.status_codes • requests.structures • requests.utils • urllib3.exceptions • urllib3.fields • urllib3.filepost • urllib3.util

imported by: requests • requests.adapters • requests.sessions

requests.packages SourceModule

imports: chardet • charset_normalizer • requests • sys • warnings

imported by: requests

requests.sessions SourceModule

imports: collections • datetime • os • requests • requests._internal_utils • requests.adapters • requests.auth • requests.compat • requests.cookies • requests.exceptions • requests.hooks • requests.models • requests.status_codes • requests.structures • requests.utils • sys • time

imported by: requests • requests.api

requests.status_codes SourceModule

imports: requests • requests.structures

imported by: requests • requests.models • requests.sessions

requests.structures SourceModule

imports: collections • requests • requests.compat

imported by: requests.adapters • requests.models • requests.sessions • requests.status_codes • requests.utils

requests.utils SourceModule

imports: codecs • collections • contextlib • io • netrc • os • re • requests • requests.__version__ • requests._internal_utils • requests.certs • requests.compat • requests.cookies • requests.exceptions • requests.structures • socket • struct • sys • tempfile • urllib3.util • warnings • winreg • zipfile

imported by: requests • requests.adapters • requests.auth • requests.models • requests.sessions

resource /Library/Frameworks/Python.framework/Versions/3.11/lib/python3.11/lib-dynload/resource.cpython-311-darwin.so

imported by: posix • psutil._pslinux

runpy SourceModule

imports: importlib.machinery • importlib.util • io • os • pkgutil • sys • warnings

imported by: multiprocessing.spawn • pdb

secrets SourceModule

imports: base64 • binascii • hmac • random

imported by: multiprocessing.shared_memory

select /Library/Frameworks/Python.framework/Versions/3.11/lib/python3.11/lib-dynload/select.cpython-311-darwin.so

imported by: http.server • pydoc • selectors • serial.serialposix • subprocess • urllib3.util.wait

selectors SourceModule

imports: abc • collections • collections.abc • math • select • sys

imported by: asyncio.selector_events • asyncio.unix_events • multiprocessing.connection • multiprocessing.forkserver • socket • socketserver • subprocess

serial Package

imports: __future__ • importlib • os • serial.serialcli • serial.serialjava • serial.serialposix • serial.serialutil • serial.serialwin32 • serial.win32 • sys

imported by: JumperlessWokwiBridge.py • serial.serialcli • serial.serialjava • serial.serialposix • serial.serialutil • serial.serialwin32 • serial.tools • serial.tools.list_ports_posix • serial.tools.list_ports_windows • serial.win32

serial.serialcli SourceModule

imports: 'System.IO' • System • __future__ • serial • serial.serialutil

imported by: serial

serial.serialjava SourceModule

imports: __future__ • serial • serial.serialutil

imported by: serial

serial.serialposix SourceModule

imports: __future__ • array • errno • fcntl • os • select • serial • serial.serialutil • struct • sys • termios • warnings

imported by: serial

serial.serialutil SourceModule

imports: __future__ • array • io • serial • sys • time

imported by: serial • serial.serialcli • serial.serialjava • serial.serialposix • serial.serialwin32

serial.serialwin32 SourceModule

imports: __future__ • ctypes • serial • serial.serialutil • serial.win32 • time

imported by: serial

serial.tools Package

imports: serial • serial.tools.list_ports_common

imported by: serial.tools.list_ports • serial.tools.list_ports_common • serial.tools.list_ports_linux • serial.tools.list_ports_osx • serial.tools.list_ports_posix • serial.tools.list_ports_windows

serial.tools.list_ports SourceModule

imports: __future__ • argparse • os • re • serial.tools • serial.tools.list_ports_posix • serial.tools.list_ports_windows • sys

imported by: JumperlessWokwiBridge.py

serial.tools.list_ports_common SourceModule

imports: __future__ • glob • os • posixpath • re • serial.tools

imported by: serial.tools • serial.tools.list_ports_linux • serial.tools.list_ports_osx • serial.tools.list_ports_posix • serial.tools.list_ports_windows

serial.tools.list_ports_linux SourceModule

imports: __future__ • glob • os • serial.tools • serial.tools.list_ports_common

imported by: serial.tools.list_ports_posix

serial.tools.list_ports_osx SourceModule

imports: __future__ • ctypes • serial.tools • serial.tools.list_ports_common

imported by: serial.tools.list_ports_posix

serial.tools.list_ports_posix SourceModule

imports: __future__ • glob • os • serial • serial.tools • serial.tools.list_ports_common • serial.tools.list_ports_linux • serial.tools.list_ports_osx • sys

imported by: serial.tools.list_ports

serial.tools.list_ports_windows SourceModule

imports: __future__ • ctypes • ctypes.wintypes • re • serial • serial.tools • serial.tools.list_ports_common • serial.win32

imported by: serial.tools.list_ports

serial.win32 SourceModule

imports: __future__ • ctypes • ctypes.wintypes • serial

imported by: serial • serial.serialwin32 • serial.tools.list_ports_windows

shlex SourceModule

imports: collections • io • os • re • sys • warnings

imported by: netrc • pdb • webbrowser

shutil SourceModule

imports: bz2 • collections • errno • fnmatch • grp • lzma • nt • os • posix • pwd • stat • sys • tarfile • zipfile • zlib

imported by: JumperlessWokwiBridge.py • argparse • http.server • multiprocessing.util • psutil._compat • tarfile • tempfile • webbrowser • zipfile

signal SourceModule

imports: _signal • enum

imported by: asyncio.proactor_events • asyncio.runners • asyncio.unix_events • multiprocessing.forkserver • multiprocessing.managers • multiprocessing.popen_fork • multiprocessing.popen_spawn_win32 • multiprocessing.process • multiprocessing.resource_sharer • multiprocessing.resource_tracker • pdb • psutil • psutil._psposix • psutil._pswindows • subprocess • unittest.signals

simplejson MissingModule

imported by: requests.compat

socket SourceModule

imports: _socket • array • enum • errno • io • os • selectors • sys

imported by: _ssl • asyncio.base_events • asyncio.events • asyncio.proactor_events • asyncio.selector_events • asyncio.streams • asyncio.trsock • asyncio.unix_events • asyncio.windows_events • email.utils • ftplib • http.client • http.server • multiprocessing.connection • multiprocessing.forkserver • multiprocessing.reduction • multiprocessing.resource_sharer • platform • psutil • psutil._common • psutil._pslinux • psutil._pssunos • requests.adapters • requests.utils • socketserver • ssl • urllib.request • urllib3.connection • urllib3.connectionpool • urllib3.contrib.pyopenssl • urllib3.contrib.socks • urllib3.exceptions • urllib3.response • urllib3.util.connection • urllib3.util.ssl_ • urllib3.util.ssltransport • urllib3.util.timeout • urllib3.util.wait • webbrowser

socketserver SourceModule

imports: io • os • selectors • socket • sys • threading • time • traceback

imported by: http.server

socks MissingModule

imported by: urllib3.contrib.socks

soupsieve Package

imports: __future__ • bs4 • soupsieve • soupsieve.__meta__ • soupsieve.css_match • soupsieve.css_parser • soupsieve.css_types • soupsieve.util • typing

imported by: bs4.css • soupsieve • soupsieve.__meta__ • soupsieve.css_match • soupsieve.css_parser • soupsieve.css_types • soupsieve.pretty • soupsieve.util

soupsieve.__meta__ SourceModule

imports: __future__ • collections • re • soupsieve

imported by: soupsieve

soupsieve.css_match SourceModule

imports: __future__ • bs4 • datetime • re • soupsieve • soupsieve.css_types • soupsieve.util • typing • unicodedata

imported by: soupsieve • soupsieve.css_parser

soupsieve.css_parser SourceModule

imports: __future__ • functools • re • soupsieve • soupsieve.css_match • soupsieve.css_types • soupsieve.util • typing • warnings

imported by: soupsieve

soupsieve.css_types SourceModule

imports: __future__ • copyreg • soupsieve • soupsieve.pretty • typing

imported by: soupsieve • soupsieve.css_match • soupsieve.css_parser

soupsieve.pretty SourceModule

imports: __future__ • re • soupsieve • typing

imported by: soupsieve.css_types

soupsieve.util SourceModule

imports: __future__ • functools • re • soupsieve • typing • warnings

imported by: soupsieve • soupsieve.css_match • soupsieve.css_parser

sre_compile SourceModule

imports: re • re._compiler • warnings

imported by: JumperlessWokwiBridge.py

sre_constants SourceModule

imports: re • re._constants • warnings

imported by: JumperlessWokwiBridge.py

sre_parse SourceModule

imports: re • re._parser • warnings

imported by: JumperlessWokwiBridge.py

ssl SourceModule

imports: _ssl • base64 • calendar • collections • enum • errno • os • socket • sys • time • warnings

imported by: asyncio.base_events • asyncio.selector_events • asyncio.sslproto • ftplib • http.client • requests • urllib.request • urllib3 • urllib3._base_connection • urllib3.connection • urllib3.connectionpool • urllib3.contrib.pyopenssl • urllib3.contrib.socks • urllib3.poolmanager • urllib3.util.ssl_ • urllib3.util.ssltransport

stat SourceModule

imports: _stat

imported by: JumperlessWokwiBridge.py • asyncio.base_events • asyncio.unix_events • genericpath • glob • netrc • ntpath • os • pathlib • posixpath • psutil._common • shutil • tarfile • zipfile

statistics SourceModule

imports: _statistics • bisect • collections • decimal • fractions • functools • itertools • math • numbers • operator • random • sys

imported by: random

string SourceModule

imports: _string • collections • re

imported by: bs4.dammit • cmd • email._encoded_words • email._header_value_parser • email.quoprimime • http.cookies • logging • lxml.html.html5parser • ntpath • nturl2path • urllib.request

stringprep SourceModule

imports: unicodedata

imported by: encodings.idna

struct SourceModule

imports: _struct

imported by: asyncio.windows_events • base64 • ctypes • gettext • gzip • multiprocessing.connection • multiprocessing.forkserver • multiprocessing.shared_memory • multiprocessing.synchronize • pickle • platform • plistlib • psutil._compat • psutil._pslinux • requests.utils • serial.serialposix • tarfile • zipfile

subprocess SourceModule

imports: _posixsubprocess • _winapi • builtins • contextlib • errno • fcntl • grp • io • locale • msvcrt • os • pwd • select • selectors • signal • sys • threading • time • types • warnings

imported by: _aix_support • asyncio.base_events • asyncio.base_subprocess • asyncio.events • asyncio.subprocess • asyncio.unix_events • asyncio.windows_utils • http.server • multiprocessing.util • os • platform • psutil • psutil._compat • psutil._psaix • psutil._pssunos • pydoc • pyduinocli.commands.base • pyi_rth_multiprocessing.py • webbrowser

sys (builtin module)

imported by: JumperlessWokwiBridge.py • _aix_support • _collections_abc • _compression • _osx_support • _pydecimal • argparse • ast • asyncio • asyncio.base_events • asyncio.coroutines • asyncio.events • asyncio.format_helpers • asyncio.futures • asyncio.runners • asyncio.streams • asyncio.unix_events • asyncio.windows_events • asyncio.windows_utils • base64 • bdb • bs4 • bs4.builder • bs4.builder._htmlparser • bs4.element • calendar • certifi.core • cgi • cmd • code • codecs • collections • concurrent.futures.process • contextlib • ctypes • ctypes._endian • curses • dataclasses • datetime • dis • doctest • email._header_value_parser • email.generator • email.iterators • email.policy • encodings • encodings.rot_13 • encodings.utf_16 • encodings.utf_32 • enum • fractions • ftplib • getopt • getpass • gettext • glob • gzip • http.client • http.server • importlib • importlib._bootstrap_external • importlib.metadata • importlib.util • inspect • linecache • locale • logging • lxml.doctestcompare • lxml.html • lxml.html._diffcommand • lxml.html.html5parser • lxml.isoschematron • mimetypes • multiprocessing • multiprocessing.connection • multiprocessing.context • multiprocessing.dummy • multiprocessing.forkserver • multiprocessing.heap • multiprocessing.managers • multiprocessing.popen_spawn_win32 • multiprocessing.process • multiprocessing.queues • multiprocessing.reduction • multiprocessing.resource_sharer • multiprocessing.resource_tracker • multiprocessing.spawn • multiprocessing.synchronize • multiprocessing.util • ntpath • optparse • os • pathlib • pdb • pickle • pkgutil • platform • posixpath • pprint • psutil • psutil._common • psutil._compat • psutil._psaix • psutil._pslinux • psutil._psposix • psutil._pssunos • psutil._pswindows • py_compile • pydoc • pyi_rth_inspect.py • pyi_rth_multiprocessing.py • pyi_rth_pkgutil.py • quopri • re._compiler • requests.compat • requests.packages • requests.sessions • requests.utils • runpy • selectors • serial • serial.serialposix • serial.serialutil • serial.tools.list_ports • serial.tools.list_ports_posix • shlex • shutil • socket • socketserver • ssl • statistics • subprocess • sysconfig • tarfile • tempfile • threading • tokenize • traceback • types • typing • typing_extensions • unittest.case • unittest.loader • unittest.main • unittest.result • unittest.runner • unittest.suite • urllib.parse • urllib.request • urllib3.connectionpool • urllib3.response • urllib3.util.ssl_ • warnings • weakref • webbrowser • xml.etree.ElementTree • xml.parsers.expat • xml.sax • xml.sax._exceptions • xml.sax.expatreader • xml.sax.saxutils • xmlrpc.client • zipfile • zipimport

sysconfig SourceModule

imports: _aix_support • _imp • _osx_support • _sysconfigdata__darwin_darwin • os • posixpath • pprint • re • sys • types • warnings

imported by: _aix_support • pydoc

tarfile SourceModule

imports: argparse • builtins • bz2 • copy • grp • gzip • io • lzma • os • pwd • re • shutil • stat • struct • sys • time • warnings • zlib

imported by: shutil

tempfile SourceModule

imports: _thread • errno • functools • io • os • random • shutil • sys • types • warnings • weakref

imported by: _osx_support • asyncio.windows_utils • cgi • importlib.resources._common • lxml.html • multiprocessing.connection • multiprocessing.heap • multiprocessing.synchronize • multiprocessing.util • pydoc • requests.utils • urllib.request • urllib.response • webbrowser

termios /Library/Frameworks/Python.framework/Versions/3.11/lib/python3.11/lib-dynload/termios.cpython-311-darwin.so

imported by: getpass • psutil._compat • serial.serialposix • tty

textwrap SourceModule

imports: re

imported by: argparse • importlib.metadata • importlib.metadata._adapters • optparse • pydoc • traceback

threading SourceModule

imports: _collections • _thread • _threading_local • _weakrefset • collections • functools • itertools • os • sys • time • traceback • warnings

imported by: JumperlessWokwiBridge.py • _threading_local • asyncio.base_events • asyncio.events • asyncio.mixins • asyncio.proactor_events • asyncio.runners • asyncio.unix_events • concurrent.futures._base • concurrent.futures.process • concurrent.futures.thread • http.cookiejar • logging • multiprocessing.context • multiprocessing.dummy • multiprocessing.forkserver • multiprocessing.heap • multiprocessing.managers • multiprocessing.pool • multiprocessing.process • multiprocessing.queues • multiprocessing.resource_sharer • multiprocessing.resource_tracker • multiprocessing.synchronize • multiprocessing.util • psutil • psutil._common • psutil._compat • pydoc • pyi_rth_multiprocessing.py • queue • requests.auth • requests.cookies • socketserver • subprocess • urllib3._collections • webbrowser • zipfile

time (builtin module)

imports: _strptime

imported by: JumperlessWokwiBridge.py • _datetime • _strptime • asyncio.base_events • asyncio.windows_events • concurrent.futures._base • datetime • email._parseaddr • email.generator • email.utils • gc • gzip • http.cookiejar • http.cookies • http.server • logging • multiprocessing.connection • multiprocessing.managers • multiprocessing.pool • multiprocessing.queues • multiprocessing.synchronize • pprint • psutil • psutil._psposix • psutil._pswindows • pydoc • queue • random • requests.auth • requests.cookies • requests.sessions • serial.serialutil • serial.serialwin32 • socketserver • ssl • subprocess • tarfile • threading • unittest.runner • urllib.request • urllib.robotparser • urllib3.util.retry • urllib3.util.timeout • xmlrpc.client • zipfile • zipimport

token SourceModule

imported by: JumperlessWokwiBridge.py • inspect • tokenize

tokenize SourceModule

imports: _tokenize • argparse • builtins • codecs • collections • functools • io • itertools • re • sys • token

imported by: JumperlessWokwiBridge.py • importlib._bootstrap_external • inspect • linecache • pdb • pydoc

traceback SourceModule

imports: ast • collections.abc • contextlib • itertools • linecache • sys • textwrap

imported by: JumperlessWokwiBridge.py • asyncio.base_events • asyncio.base_tasks • asyncio.coroutines • asyncio.format_helpers • bs4 • cgi • code • concurrent.futures.process • doctest • http.cookiejar • logging • multiprocessing.managers • multiprocessing.pool • multiprocessing.process • multiprocessing.queues • multiprocessing.util • pdb • py_compile • pydoc • socketserver • threading • unittest.case • unittest.loader • unittest.result • warnings

tracemalloc SourceModule

imports: _tracemalloc • collections.abc • fnmatch • functools • linecache • pickle • posixpath

imported by: warnings

tty SourceModule

imports: termios

imported by: pydoc

types SourceModule

imports: _collections_abc • functools • sys

imported by: JumperlessWokwiBridge.py • _weakrefset • asyncio.coroutines • asyncio.futures • asyncio.queues • asyncio.tasks • asyncio.timeouts • certifi.core • concurrent.futures._base • concurrent.futures.thread • contextlib • copy • ctypes • dataclasses • difflib • dis • email.headerregistry • enum • functools • http.cookies • importlib.metadata._functools • importlib.resources._common • importlib.resources._legacy • importlib.util • inspect • logging • multiprocessing.managers • multiprocessing.pool • multiprocessing.queues • multiprocessing.shared_memory • multiprocessing.spawn • pickle • pkgutil • pprint • psutil._compat • queue • subprocess • sysconfig • tempfile • typing • typing_extensions • unittest.case • unittest.loader • urllib.parse • urllib3.connectionpool • urllib3.poolmanager • urllib3.util.retry • urllib3.util.util

typing SourceModule

imports: _typing • abc • collections • collections.abc • contextlib • functools • operator • re • sys • types • warnings

imported by: asyncio.staggered • asyncio.timeouts • certifi.core • chardet • chardet.chardistribution • chardet.charsetgroupprober • chardet.charsetprober • chardet.codingstatemachinedict • chardet.escprober • chardet.eucjpprober • chardet.hebrewprober • chardet.jpcntx • chardet.latin1prober • chardet.macromanprober • chardet.mbcharsetprober • chardet.resultdict • chardet.sbcharsetprober • chardet.sjisprober • chardet.universaldetector • chardet.utf1632prober • chardet.utf8prober • charset_normalizer.api • charset_normalizer.assets • charset_normalizer.cd • charset_normalizer.constant • charset_normalizer.legacy • charset_normalizer.models • charset_normalizer.utils • functools • idna.core • idna.intranges • idna.uts46data • importlib.metadata • importlib.metadata._meta • importlib.resources._common • importlib.resources._itertools • importlib.resources._legacy • importlib.resources.abc • pdb • soupsieve • soupsieve.css_match • soupsieve.css_parser • soupsieve.css_types • soupsieve.pretty • soupsieve.util • typing_extensions • urllib3 • urllib3._base_connection • urllib3._collections • urllib3._request_methods • urllib3.connection • urllib3.connectionpool • urllib3.contrib.pyopenssl • urllib3.contrib.socks • urllib3.exceptions • urllib3.fields • urllib3.filepost • urllib3.poolmanager • urllib3.response • urllib3.util.connection • urllib3.util.proxy • urllib3.util.request • urllib3.util.retry • urllib3.util.ssl_ • urllib3.util.ssl_match_hostname • urllib3.util.ssltransport • urllib3.util.timeout • urllib3.util.url • urllib3.util.util

typing_extensions SourceModule

imports: abc • collections • collections.abc • functools • inspect • operator • sys • types • typing • warnings

imported by: urllib3._base_connection • urllib3._collections • urllib3.connection • urllib3.connectionpool • urllib3.poolmanager • urllib3.response • urllib3.util.request • urllib3.util.ssl_ • urllib3.util.ssltransport • urllib3.util.timeout

unicodedata /Library/Frameworks/Python.framework/Versions/3.11/lib/python3.11/lib-dynload/unicodedata.cpython-311-darwin.so

imported by: charset_normalizer.utils • encodings.idna • idna.core • re._parser • soupsieve.css_match • stringprep • urllib.parse

unittest Package

imports: posixpath • unittest • unittest.async_case • unittest.case • unittest.loader • unittest.main • unittest.result • unittest.runner • unittest.signals • unittest.suite • unittest.util

imported by: doctest • unittest • unittest._log • unittest.async_case • unittest.case • unittest.loader • unittest.main • unittest.result • unittest.runner • unittest.signals • unittest.suite • unittest.util

unittest._log SourceModule

imports: collections • logging • unittest • unittest.case

imported by: unittest.case

unittest.async_case SourceModule

imports: asyncio • contextvars • inspect • unittest • unittest.case • warnings

imported by: unittest

unittest.case SourceModule

imports: collections • contextlib • difflib • functools • pprint • re • sys • traceback • types • unittest • unittest._log • unittest.result • unittest.util • warnings

imported by: unittest • unittest._log • unittest.async_case • unittest.loader • unittest.runner • unittest.suite

unittest.loader SourceModule

imports: fnmatch • functools • os • re • sys • traceback • types • unittest • unittest.case • unittest.suite • unittest.util • warnings

imported by: unittest • unittest.main

unittest.main SourceModule

imports: argparse • os • sys • unittest • unittest.loader • unittest.runner • unittest.signals • warnings

imported by: unittest

unittest.result SourceModule

imports: functools • io • sys • traceback • unittest • unittest.util

imported by: unittest • unittest.case • unittest.runner

unittest.runner SourceModule

imports: sys • time • unittest • unittest.case • unittest.result • unittest.signals • warnings

imported by: unittest • unittest.main

unittest.signals SourceModule

imports: functools • signal • unittest • weakref

imported by: unittest • unittest.main • unittest.runner

unittest.suite SourceModule

imports: sys • unittest • unittest.case • unittest.util

imported by: unittest • unittest.loader

unittest.util SourceModule

imports: collections • posixpath • unittest

imported by: unittest • unittest.case • unittest.loader • unittest.result • unittest.suite

urllib Package

imports: urllib.urlencode • urllib.urlopen

imported by: JumperlessWokwiBridge.py • email._header_value_parser • lxml.html • urllib.error • urllib.parse • urllib.request • urllib.response • urllib.robotparser

urllib.error SourceModule

imports: io • urllib • urllib.response

imported by: JumperlessWokwiBridge.py • urllib.request

urllib.parse SourceModule

imports: collections • functools • ipaddress • re • sys • types • unicodedata • urllib • warnings

imported by: JumperlessWokwiBridge.py • cgi • email.utils • http.client • http.cookiejar • http.server • lxml.ElementInclude • lxml.html • lxml.html.html5parser • mimetypes • nturl2path • pathlib • pydoc • requests.compat • urllib.request • urllib.robotparser • urllib3._request_methods • urllib3.poolmanager • xml.etree.ElementInclude • xml.sax.saxutils • xmlrpc.client

urllib.request SourceModule

imports: _scproxy • base64 • bisect • contextlib • email • email.utils • fnmatch • ftplib • getpass • hashlib • http.client • http.cookiejar • io • mimetypes • nturl2path • os • posixpath • re • socket • ssl • string • sys • tempfile • time • urllib • urllib.error • urllib.parse • urllib.response • warnings • winreg

imported by: JumperlessWokwiBridge.py • http.cookiejar • lxml.ElementInclude • lxml.html • lxml.html.html5parser • requests.compat • urllib.robotparser • xml.sax.saxutils

urllib.response SourceModule

imports: tempfile • urllib

imported by: JumperlessWokwiBridge.py • urllib.error • urllib.request

urllib.robotparser SourceModule

imports: collections • time • urllib • urllib.parse • urllib.request

imported by: JumperlessWokwiBridge.py

urllib.urlencode MissingModule

imported by: lxml.html • urllib

urllib.urlopen MissingModule

imported by: lxml.html • urllib

urllib2 MissingModule

imported by: lxml.ElementInclude • lxml.html.html5parser

urllib3 Package

imports: __future__ • logging • ssl • typing • urllib3 • urllib3._base_connection • urllib3._collections • urllib3._version • urllib3.connectionpool • urllib3.exceptions • urllib3.filepost • urllib3.poolmanager • urllib3.response • urllib3.util • urllib3.util.request • urllib3.util.retry • urllib3.util.timeout • urllib3_secure_extra • warnings

imported by: requests • urllib3 • urllib3._base_connection • urllib3._collections • urllib3._request_methods • urllib3._version • urllib3.connection • urllib3.connectionpool • urllib3.contrib • urllib3.contrib.pyopenssl • urllib3.exceptions • urllib3.fields • urllib3.filepost • urllib3.poolmanager • urllib3.response • urllib3.util

urllib3._base_connection SourceModule

imports: __future__ • ssl • typing • typing_extensions • urllib3 • urllib3.response • urllib3.util.connection • urllib3.util.timeout • urllib3.util.url

imported by: urllib3 • urllib3._request_methods • urllib3.connection • urllib3.connectionpool • urllib3.response • urllib3.util.connection

urllib3._collections SourceModule

imports: __future__ • collections • enum • threading • typing • typing_extensions • urllib3

imported by: urllib3 • urllib3._request_methods • urllib3.connection • urllib3.poolmanager • urllib3.response

urllib3._request_methods SourceModule

imports: __future__ • json • typing • urllib.parse • urllib3 • urllib3._base_connection • urllib3._collections • urllib3.filepost • urllib3.response

imported by: urllib3.connectionpool • urllib3.poolmanager

urllib3._version SourceModule

imports: __future__ • urllib3

imported by: urllib3 • urllib3.connection

urllib3.connection SourceModule

imports: __future__ • datetime • http.client • logging • os • re • socket • ssl • typing • typing_extensions • urllib3 • urllib3._base_connection • urllib3._collections • urllib3._version • urllib3.exceptions • urllib3.response • urllib3.util • urllib3.util.connection • urllib3.util.request • urllib3.util.response • urllib3.util.ssl_ • urllib3.util.ssl_match_hostname • urllib3.util.ssltransport • urllib3.util.timeout • urllib3.util.url • urllib3.util.util • urllib3.util.wait • warnings

imported by: urllib3.connectionpool • urllib3.contrib.socks • urllib3.exceptions • urllib3.poolmanager • urllib3.response • urllib3.util.proxy

urllib3.connectionpool SourceModule

imports: __future__ • errno • logging • queue • socket • ssl • sys • types • typing • typing_extensions • urllib3 • urllib3._base_connection • urllib3._request_methods • urllib3.connection • urllib3.exceptions • urllib3.response • urllib3.util.connection • urllib3.util.proxy • urllib3.util.request • urllib3.util.retry • urllib3.util.ssl_match_hostname • urllib3.util.timeout • urllib3.util.url • urllib3.util.util • warnings • weakref

imported by: urllib3 • urllib3.contrib.socks • urllib3.exceptions • urllib3.poolmanager • urllib3.response • urllib3.util.retry

urllib3.contrib Package

imports: urllib3 • urllib3.contrib.pyopenssl

imported by: requests • urllib3.contrib.pyopenssl • urllib3.contrib.socks

urllib3.contrib.pyopenssl SourceModule

imports: 'OpenSSL.crypto' • 'cryptography.x509' • OpenSSL • __future__ • cryptography • idna • io • logging • socket • ssl • typing • urllib3 • urllib3.contrib • urllib3.util • warnings

imported by: requests • urllib3.contrib

urllib3.contrib.socks SourceModule

imports: __future__ • socket • socks • ssl • typing • urllib3.connection • urllib3.connectionpool • urllib3.contrib • urllib3.exceptions • urllib3.poolmanager • urllib3.util.url • warnings

imported by: requests.adapters

urllib3.exceptions SourceModule

imports: __future__ • email.errors • http.client • socket • typing • urllib3 • urllib3.connection • urllib3.connectionpool • urllib3.response • urllib3.util.retry • warnings

imported by: requests • requests.adapters • requests.exceptions • requests.models • urllib3 • urllib3.connection • urllib3.connectionpool • urllib3.contrib.socks • urllib3.poolmanager • urllib3.response • urllib3.util.connection • urllib3.util.request • urllib3.util.response • urllib3.util.retry • urllib3.util.ssl_ • urllib3.util.ssltransport • urllib3.util.timeout • urllib3.util.url

urllib3.fields SourceModule

imports: __future__ • email.utils • mimetypes • typing • urllib3 • warnings

imported by: requests.models • urllib3.filepost

urllib3.filepost SourceModule

imports: __future__ • binascii • codecs • io • os • typing • urllib3 • urllib3.fields

imported by: requests.models • urllib3 • urllib3._request_methods

urllib3.poolmanager SourceModule

imports: __future__ • functools • logging • ssl • types • typing • typing_extensions • urllib.parse • urllib3 • urllib3._collections • urllib3._request_methods • urllib3.connection • urllib3.connectionpool • urllib3.exceptions • urllib3.response • urllib3.util.connection • urllib3.util.proxy • urllib3.util.retry • urllib3.util.timeout • urllib3.util.url • warnings

imported by: requests.adapters • urllib3 • urllib3.contrib.socks

urllib3.response SourceModule

imports: __future__ • brotli • brotlicffi • collections • contextlib • http.client • io • json • logging • re • socket • sys • typing • typing_extensions • urllib3 • urllib3._base_connection • urllib3._collections • urllib3.connection • urllib3.connectionpool • urllib3.exceptions • urllib3.util • urllib3.util.response • urllib3.util.retry • warnings • zlib • zstandard

imported by: urllib3 • urllib3._base_connection • urllib3._request_methods • urllib3.connection • urllib3.connectionpool • urllib3.exceptions • urllib3.poolmanager • urllib3.util.retry

urllib3.util Package

imports: __future__ • urllib3 • urllib3.util.connection • urllib3.util.request • urllib3.util.response • urllib3.util.retry • urllib3.util.ssl_ • urllib3.util.timeout • urllib3.util.url • urllib3.util.wait

imported by: requests.adapters • requests.models • requests.utils • urllib3 • urllib3.connection • urllib3.contrib.pyopenssl • urllib3.response • urllib3.util.connection • urllib3.util.proxy • urllib3.util.request • urllib3.util.response • urllib3.util.retry • urllib3.util.ssl_ • urllib3.util.ssl_match_hostname • urllib3.util.ssltransport • urllib3.util.timeout • urllib3.util.url • urllib3.util.util • urllib3.util.wait

urllib3.util.connection SourceModule

imports: __future__ • socket • typing • urllib3._base_connection • urllib3.exceptions • urllib3.util • urllib3.util.timeout

imported by: urllib3._base_connection • urllib3.connection • urllib3.connectionpool • urllib3.poolmanager • urllib3.util

urllib3.util.proxy SourceModule

imports: __future__ • typing • urllib3.connection • urllib3.util • urllib3.util.url

imported by: urllib3.connectionpool • urllib3.poolmanager

urllib3.util.request SourceModule

imports: __future__ • base64 • brotli • brotlicffi • enum • io • typing • typing_extensions • urllib3.exceptions • urllib3.util • urllib3.util.util • zstandard

imported by: urllib3 • urllib3.connection • urllib3.connectionpool • urllib3.util

urllib3.util.response SourceModule

imports: __future__ • email.errors • http.client • urllib3.exceptions • urllib3.util

imported by: urllib3.connection • urllib3.response • urllib3.util

urllib3.util.retry SourceModule

imports: __future__ • email • itertools • logging • random • re • time • types • typing • urllib3.connectionpool • urllib3.exceptions • urllib3.response • urllib3.util • urllib3.util.util

imported by: requests.adapters • urllib3 • urllib3.connectionpool • urllib3.exceptions • urllib3.poolmanager • urllib3.response • urllib3.util

urllib3.util.ssl_ SourceModule

imports: __future__ • binascii • hashlib • hmac • os • socket • ssl • sys • typing • typing_extensions • urllib3.exceptions • urllib3.util • urllib3.util.ssltransport • urllib3.util.url • warnings

imported by: urllib3.connection • urllib3.util • urllib3.util.ssl_match_hostname • urllib3.util.ssltransport

urllib3.util.ssl_match_hostname SourceModule

imports: __future__ • ipaddress • re • typing • urllib3.util • urllib3.util.ssl_

imported by: urllib3.connection • urllib3.connectionpool

urllib3.util.ssltransport SourceModule

imports: __future__ • io • socket • ssl • typing • typing_extensions • urllib3.exceptions • urllib3.util • urllib3.util.ssl_

imported by: urllib3.connection • urllib3.util.ssl_

urllib3.util.timeout SourceModule

imports: __future__ • enum • socket • time • typing • typing_extensions • urllib3.exceptions • urllib3.util

imported by: urllib3 • urllib3._base_connection • urllib3.connection • urllib3.connectionpool • urllib3.poolmanager • urllib3.util • urllib3.util.connection

urllib3.util.url SourceModule

imports: __future__ • idna • re • typing • urllib3.exceptions • urllib3.util • urllib3.util.util

imported by: urllib3._base_connection • urllib3.connection • urllib3.connectionpool • urllib3.contrib.socks • urllib3.poolmanager • urllib3.util • urllib3.util.proxy • urllib3.util.ssl_

urllib3.util.util SourceModule

imports: __future__ • types • typing • urllib3.util

imported by: urllib3.connection • urllib3.connectionpool • urllib3.util.request • urllib3.util.retry • urllib3.util.url

urllib3.util.wait SourceModule

imports: __future__ • functools • select • socket • urllib3.util

imported by: urllib3.connection • urllib3.util

urllib3_secure_extra MissingModule

imported by: urllib3

urlparse MissingModule

imported by: lxml.ElementInclude • lxml.html • lxml.html.html5parser

vms_lib MissingModule

imported by: platform

warnings SourceModule

imports: _warnings • builtins • linecache • re • sys • traceback • tracemalloc

imported by: JumperlessWokwiBridge.py • argparse • ast • asyncio.base_events • asyncio.base_subprocess • asyncio.proactor_events • asyncio.selector_events • asyncio.sslproto • asyncio.streams • asyncio.tasks • asyncio.unix_events • asyncio.windows_utils • bs4 • bs4.builder • bs4.builder._html5lib • bs4.builder._htmlparser • bs4.css • bs4.element • cgi • charset_normalizer.legacy • codeop • enum • ftplib • getpass • gettext • gzip • hashlib • hmac • http.client • http.cookiejar • importlib • importlib._abc • importlib.abc • importlib.metadata • importlib.resources._legacy • importlib.util • io • locale • logging • multiprocessing.forkserver • multiprocessing.pool • multiprocessing.resource_tracker • os • pathlib • pkgutil • psutil._common • psutil._pslinux • pydoc • random • re • re._parser • requests • requests.auth • requests.packages • requests.utils • runpy • serial.serialposix • shlex • soupsieve.css_parser • soupsieve.util • sre_compile • sre_constants • sre_parse • ssl • subprocess • sysconfig • tarfile • tempfile • threading • typing • typing_extensions • unittest.async_case • unittest.case • unittest.loader • unittest.main • unittest.runner • urllib.parse • urllib.request • urllib3 • urllib3.connection • urllib3.connectionpool • urllib3.contrib.pyopenssl • urllib3.contrib.socks • urllib3.exceptions • urllib3.fields • urllib3.poolmanager • urllib3.response • urllib3.util.ssl_ • webbrowser • xml.etree.ElementTree • zipfile

weakref SourceModule

imports: _collections_abc • _weakref • _weakrefset • atexit • copy • gc • itertools • sys

imported by: JumperlessWokwiBridge.py • _threading_local • asyncio.base_events • asyncio.selector_events • asyncio.streams • asyncio.tasks • asyncio.windows_events • concurrent.futures.process • concurrent.futures.thread • copy • functools • logging • multiprocessing.dummy • multiprocessing.queues • multiprocessing.sharedctypes • multiprocessing.util • tempfile • unittest.signals • urllib3.connectionpool • xml.sax.expatreader

webbrowser SourceModule

imports: copy • getopt • glob • os • pwd • shlex • shutil • socket • subprocess • sys • tempfile • threading • warnings

imported by: lxml.html • pydoc

winreg MissingModule

imported by: importlib._bootstrap_external • mimetypes • platform • requests.utils • urllib.request

xml Package

imports: xml.sax.expatreader • xml.sax.xmlreader

imported by: xml.etree • xml.parsers • xml.sax

xml.etree Package

imports: xml • xml.etree • xml.etree.ElementPath • xml.etree.ElementTree

imported by: psutil._psbsd • xml.etree • xml.etree.ElementInclude • xml.etree.ElementPath • xml.etree.ElementTree • xml.etree.cElementTree

xml.etree.ElementInclude SourceModule

imports: copy • urllib.parse • xml.etree • xml.etree.ElementTree

imported by: _elementtree

xml.etree.ElementPath SourceModule

imports: re • xml.etree

imported by: _elementtree • xml.etree • xml.etree.ElementTree

xml.etree.ElementTree SourceModule

imports: _elementtree • collections • collections.abc • contextlib • io • pyexpat • re • sys • warnings • xml.etree • xml.etree.ElementPath • xml.parsers • xml.parsers.expat

imported by: _elementtree • psutil._psbsd • xml.etree • xml.etree.ElementInclude • xml.etree.cElementTree

xml.etree.cElementTree SourceModule

imports: xml.etree • xml.etree.ElementTree

imported by: _elementtree

xml.parsers Package

imports: xml

imported by: xml.etree.ElementTree • xml.parsers.expat • xml.sax.expatreader • xmlrpc.client

xml.parsers.expat SourceModule

imports: pyexpat • sys • xml.parsers

imported by: plistlib • xml.etree.ElementTree • xml.sax.expatreader • xmlrpc.client

xml.sax Package

imports: 'org.python' • io • os • sys • xml • xml.sax • xml.sax._exceptions • xml.sax.expatreader • xml.sax.handler • xml.sax.saxutils • xml.sax.xmlreader

imported by: xml.sax • xml.sax._exceptions • xml.sax.expatreader • xml.sax.handler • xml.sax.saxutils • xml.sax.xmlreader

xml.sax._exceptions SourceModule

imports: 'java.lang' • sys • xml.sax

imported by: xml.sax • xml.sax.expatreader • xml.sax.xmlreader

xml.sax.expatreader SourceModule

imports: _weakref • sys • weakref • xml.parsers • xml.parsers.expat • xml.sax • xml.sax._exceptions • xml.sax.handler • xml.sax.saxutils • xml.sax.xmlreader

imported by: xml • xml.sax

xml.sax.handler SourceModule

imports: xml.sax

imported by: xml.sax • xml.sax.expatreader • xml.sax.saxutils • xml.sax.xmlreader

xml.sax.saxutils SourceModule

imports: codecs • io • os • sys • urllib.parse • urllib.request • xml.sax • xml.sax.handler • xml.sax.xmlreader

imported by: xml.sax • xml.sax.expatreader • xml.sax.xmlreader

xml.sax.xmlreader SourceModule

imports: xml.sax • xml.sax._exceptions • xml.sax.handler • xml.sax.saxutils

imported by: xml • xml.sax • xml.sax.expatreader • xml.sax.saxutils

xmlrpc Package

imported by: xmlrpc.client

xmlrpc.client SourceModule

imports: base64 • datetime • decimal • errno • gzip • http.client • io • sys • time • urllib.parse • xml.parsers • xml.parsers.expat • xmlrpc

imported by: multiprocessing.connection

zipfile SourceModule

imports: argparse • binascii • bz2 • contextlib • importlib.util • io • itertools • lzma • os • pathlib • posixpath • py_compile • shutil • stat • struct • sys • threading • time • warnings • zlib

imported by: importlib.metadata • importlib.resources.readers • requests.utils • shutil

zipimport SourceModule

imports: _frozen_importlib • _frozen_importlib_external • _imp • _io • _warnings • importlib.readers • marshal • sys • time • zlib

imported by: pkgutil

zlib /Library/Frameworks/Python.framework/Versions/3.11/lib/python3.11/lib-dynload/zlib.cpython-311-darwin.so

imported by: encodings.zlib_codec • gzip • shutil • tarfile • urllib3.response • zipfile • zipimport

zstandard MissingModule

imported by: urllib3.response • urllib3.util.request
