Architeuthis-Flux/Jumperless/Jumperless_Wokwi_Bridge_App/JumperlessWokwiBridge/build/Jumperless/xref-Jumperless.html

# modulegraph cross reference for JumperlessWokwiBridge.py, pyi_rth_inspect.py

JumperlessWokwiBridge.py Script

imports: 'serial.tools' • _collections_abc • _weakrefset • abc • bs4 • codecs • collections • collections.abc • copyreg • encodings • encodings.aliases • encodings.ascii • encodings.base64_codec • encodings.big5 • encodings.big5hkscs • encodings.bz2_codec • encodings.charmap • encodings.cp037 • encodings.cp1006 • encodings.cp1026 • encodings.cp1125 • encodings.cp1140 • encodings.cp1250 • encodings.cp1251 • encodings.cp1252 • encodings.cp1253 • encodings.cp1254 • encodings.cp1255 • encodings.cp1256 • encodings.cp1257 • encodings.cp1258 • encodings.cp273 • encodings.cp424 • encodings.cp437 • encodings.cp500 • encodings.cp720 • encodings.cp737 • encodings.cp775 • encodings.cp850 • encodings.cp852 • encodings.cp855 • encodings.cp856 • encodings.cp857 • encodings.cp858 • encodings.cp860 • encodings.cp861 • encodings.cp862 • encodings.cp863 • encodings.cp864 • encodings.cp865 • encodings.cp866 • encodings.cp869 • encodings.cp874 • encodings.cp875 • encodings.cp932 • encodings.cp949 • encodings.cp950 • encodings.euc_jis_2004 • encodings.euc_jisx0213 • encodings.euc_jp • encodings.euc_kr • encodings.gb18030 • encodings.gb2312 • encodings.gbk • encodings.hex_codec • encodings.hp_roman8 • encodings.hz • encodings.idna • encodings.iso2022_jp • encodings.iso2022_jp_1 • encodings.iso2022_jp_2 • encodings.iso2022_jp_2004 • encodings.iso2022_jp_3 • encodings.iso2022_jp_ext • encodings.iso2022_kr • encodings.iso8859_1 • encodings.iso8859_10 • encodings.iso8859_11 • encodings.iso8859_13 • encodings.iso8859_14 • encodings.iso8859_15 • encodings.iso8859_16 • encodings.iso8859_2 • encodings.iso8859_3 • encodings.iso8859_4 • encodings.iso8859_5 • encodings.iso8859_6 • encodings.iso8859_7 • encodings.iso8859_8 • encodings.iso8859_9 • encodings.johab • encodings.koi8_r • encodings.koi8_t • encodings.koi8_u • encodings.kz1048 • encodings.latin_1 • encodings.mac_arabic • encodings.mac_croatian • encodings.mac_cyrillic • encodings.mac_farsi • encodings.mac_greek • encodings.mac_iceland • encodings.mac_latin2 • encodings.mac_roman • encodings.mac_romanian • encodings.mac_turkish • encodings.mbcs • encodings.oem • encodings.palmos • encodings.ptcp154 • encodings.punycode • encodings.quopri_codec • encodings.raw_unicode_escape • encodings.rot_13 • encodings.shift_jis • encodings.shift_jis_2004 • encodings.shift_jisx0213 • encodings.tis_620 • encodings.undefined • encodings.unicode_escape • encodings.utf_16 • encodings.utf_16_be • encodings.utf_16_le • encodings.utf_32 • encodings.utf_32_be • encodings.utf_32_le • encodings.utf_7 • encodings.utf_8 • encodings.utf_8_sig • encodings.uu_codec • encodings.zlib_codec • enum • functools • genericpath • heapq • io • json • keyword • linecache • locale • ntpath • operator • os • pathlib • posixpath • psutil • pyduinocli • pyi_rth_inspect.py • re • re._casefix • re._compiler • re._constants • re._parser • reprlib • requests • serial • shutil • sre_compile • sre_constants • sre_parse • ssl • stat • sys • threading • time • traceback • types • urllib.request • warnings • weakref

pyi_rth_inspect.py Script

imports: inspect • os • sys

imported by: JumperlessWokwiBridge.py

'serial.tools' MissingModule

imported by: JumperlessWokwiBridge.py

_abc (builtin module)

imported by: abc

_ast (builtin module)

imported by: ast

_bisect /Users/kevinsanto/Documents/GitHub/Jumperless/Jumperless_Wokwi_Bridge_App/JumperlessWokwiBridge/.conda/lib/python3.12/lib-dynload/_bisect.cpython-312-darwin.so

imported by: bisect

_blake2 /Users/kevinsanto/Documents/GitHub/Jumperless/Jumperless_Wokwi_Bridge_App/JumperlessWokwiBridge/.conda/lib/python3.12/lib-dynload/_blake2.cpython-312-darwin.so

imported by: hashlib

_bz2 /Users/kevinsanto/Documents/GitHub/Jumperless/Jumperless_Wokwi_Bridge_App/JumperlessWokwiBridge/.conda/lib/python3.12/lib-dynload/_bz2.cpython-312-darwin.so

imported by: bz2

_codecs (builtin module)

imported by: codecs

_codecs_cn /Users/kevinsanto/Documents/GitHub/Jumperless/Jumperless_Wokwi_Bridge_App/JumperlessWokwiBridge/.conda/lib/python3.12/lib-dynload/_codecs_cn.cpython-312-darwin.so

imported by: encodings.gb18030 • encodings.gb2312 • encodings.gbk • encodings.hz

_codecs_hk /Users/kevinsanto/Documents/GitHub/Jumperless/Jumperless_Wokwi_Bridge_App/JumperlessWokwiBridge/.conda/lib/python3.12/lib-dynload/_codecs_hk.cpython-312-darwin.so

imported by: encodings.big5hkscs

_codecs_iso2022 /Users/kevinsanto/Documents/GitHub/Jumperless/Jumperless_Wokwi_Bridge_App/JumperlessWokwiBridge/.conda/lib/python3.12/lib-dynload/_codecs_iso2022.cpython-312-darwin.so

imported by: encodings.iso2022_jp • encodings.iso2022_jp_1 • encodings.iso2022_jp_2 • encodings.iso2022_jp_2004 • encodings.iso2022_jp_3 • encodings.iso2022_jp_ext • encodings.iso2022_kr

_codecs_jp /Users/kevinsanto/Documents/GitHub/Jumperless/Jumperless_Wokwi_Bridge_App/JumperlessWokwiBridge/.conda/lib/python3.12/lib-dynload/_codecs_jp.cpython-312-darwin.so

imported by: encodings.cp932 • encodings.euc_jis_2004 • encodings.euc_jisx0213 • encodings.euc_jp • encodings.shift_jis • encodings.shift_jis_2004 • encodings.shift_jisx0213

_codecs_kr /Users/kevinsanto/Documents/GitHub/Jumperless/Jumperless_Wokwi_Bridge_App/JumperlessWokwiBridge/.conda/lib/python3.12/lib-dynload/_codecs_kr.cpython-312-darwin.so

imported by: encodings.cp949 • encodings.euc_kr • encodings.johab

_codecs_tw /Users/kevinsanto/Documents/GitHub/Jumperless/Jumperless_Wokwi_Bridge_App/JumperlessWokwiBridge/.conda/lib/python3.12/lib-dynload/_codecs_tw.cpython-312-darwin.so

imported by: encodings.big5 • encodings.cp950

_collections (builtin module)

imported by: collections • threading

_collections_abc SourceModule

imports: abc • sys • warnings

imported by: JumperlessWokwiBridge.py • collections • collections.abc • contextlib • locale • os • pathlib • random • types • weakref

_compat_pickle SourceModule

imported by: _pickle • pickle

_compression SourceModule

imports: io • sys

imported by: bz2 • gzip • lzma

_contextvars /Users/kevinsanto/Documents/GitHub/Jumperless/Jumperless_Wokwi_Bridge_App/JumperlessWokwiBridge/.conda/lib/python3.12/lib-dynload/_contextvars.cpython-312-darwin.so

imported by: contextvars

_csv /Users/kevinsanto/Documents/GitHub/Jumperless/Jumperless_Wokwi_Bridge_App/JumperlessWokwiBridge/.conda/lib/python3.12/lib-dynload/_csv.cpython-312-darwin.so

imported by: csv

_datetime /Users/kevinsanto/Documents/GitHub/Jumperless/Jumperless_Wokwi_Bridge_App/JumperlessWokwiBridge/.conda/lib/python3.12/lib-dynload/_datetime.cpython-312-darwin.so

imports: _strptime • time

imported by: datetime

_decimal /Users/kevinsanto/Documents/GitHub/Jumperless/Jumperless_Wokwi_Bridge_App/JumperlessWokwiBridge/.conda/lib/python3.12/lib-dynload/_decimal.cpython-312-darwin.so

imported by: decimal

_frozen_importlib ExcludedModule

imported by: importlib • importlib.abc

_frozen_importlib_external MissingModule

imported by: importlib • importlib._bootstrap • importlib.abc

_functools (builtin module)

imported by: functools

_hashlib /Users/kevinsanto/Documents/GitHub/Jumperless/Jumperless_Wokwi_Bridge_App/JumperlessWokwiBridge/.conda/lib/python3.12/lib-dynload/_hashlib.cpython-312-darwin.so

imported by: hashlib

_heapq /Users/kevinsanto/Documents/GitHub/Jumperless/Jumperless_Wokwi_Bridge_App/JumperlessWokwiBridge/.conda/lib/python3.12/lib-dynload/_heapq.cpython-312-darwin.so

imported by: heapq

_imp (builtin module)

imported by: importlib • importlib._bootstrap_external • importlib.util

_io (builtin module)

imported by: importlib._bootstrap_external • io

_json /Users/kevinsanto/Documents/GitHub/Jumperless/Jumperless_Wokwi_Bridge_App/JumperlessWokwiBridge/.conda/lib/python3.12/lib-dynload/_json.cpython-312-darwin.so

imports: json.decoder

imported by: json.decoder • json.encoder • json.scanner

_locale (builtin module)

imported by: locale

_lzma /Users/kevinsanto/Documents/GitHub/Jumperless/Jumperless_Wokwi_Bridge_App/JumperlessWokwiBridge/.conda/lib/python3.12/lib-dynload/_lzma.cpython-312-darwin.so

imported by: lzma

_md5 /Users/kevinsanto/Documents/GitHub/Jumperless/Jumperless_Wokwi_Bridge_App/JumperlessWokwiBridge/.conda/lib/python3.12/lib-dynload/_md5.cpython-312-darwin.so

imported by: hashlib

_multibytecodec /Users/kevinsanto/Documents/GitHub/Jumperless/Jumperless_Wokwi_Bridge_App/JumperlessWokwiBridge/.conda/lib/python3.12/lib-dynload/_multibytecodec.cpython-312-darwin.so

imported by: encodings.big5 • encodings.big5hkscs • encodings.cp932 • encodings.cp949 • encodings.cp950 • encodings.euc_jis_2004 • encodings.euc_jisx0213 • encodings.euc_jp • encodings.euc_kr • encodings.gb18030 • encodings.gb2312 • encodings.gbk • encodings.hz • encodings.iso2022_jp • encodings.iso2022_jp_1 • encodings.iso2022_jp_2 • encodings.iso2022_jp_2004 • encodings.iso2022_jp_3 • encodings.iso2022_jp_ext • encodings.iso2022_kr • encodings.johab • encodings.shift_jis • encodings.shift_jis_2004 • encodings.shift_jisx0213

_opcode /Users/kevinsanto/Documents/GitHub/Jumperless/Jumperless_Wokwi_Bridge_App/JumperlessWokwiBridge/.conda/lib/python3.12/lib-dynload/_opcode.cpython-312-darwin.so

imported by: opcode

_operator (builtin module)

imported by: operator

_pickle /Users/kevinsanto/Documents/GitHub/Jumperless/Jumperless_Wokwi_Bridge_App/JumperlessWokwiBridge/.conda/lib/python3.12/lib-dynload/_pickle.cpython-312-darwin.so

imports: _compat_pickle • codecs • copyreg

imported by: pickle

_posixsubprocess /Users/kevinsanto/Documents/GitHub/Jumperless/Jumperless_Wokwi_Bridge_App/JumperlessWokwiBridge/.conda/lib/python3.12/lib-dynload/_posixsubprocess.cpython-312-darwin.so

imports: gc

imported by: subprocess

_py_abc SourceModule

imports: _weakrefset

imported by: abc

_pydatetime SourceModule

imports: _strptime • math • operator • sys • time • warnings

imported by: datetime

_pydecimal SourceModule

imports: collections • contextvars • itertools • locale • math • numbers • re • sys

imported by: decimal

_random /Users/kevinsanto/Documents/GitHub/Jumperless/Jumperless_Wokwi_Bridge_App/JumperlessWokwiBridge/.conda/lib/python3.12/lib-dynload/_random.cpython-312-darwin.so

imported by: random

_scproxy /Users/kevinsanto/Documents/GitHub/Jumperless/Jumperless_Wokwi_Bridge_App/JumperlessWokwiBridge/.conda/lib/python3.12/lib-dynload/_scproxy.cpython-312-darwin.so

imported by: urllib.request

_sha1 /Users/kevinsanto/Documents/GitHub/Jumperless/Jumperless_Wokwi_Bridge_App/JumperlessWokwiBridge/.conda/lib/python3.12/lib-dynload/_sha1.cpython-312-darwin.so

imported by: hashlib

_sha2 /Users/kevinsanto/Documents/GitHub/Jumperless/Jumperless_Wokwi_Bridge_App/JumperlessWokwiBridge/.conda/lib/python3.12/lib-dynload/_sha2.cpython-312-darwin.so

imported by: hashlib • random

_sha3 /Users/kevinsanto/Documents/GitHub/Jumperless/Jumperless_Wokwi_Bridge_App/JumperlessWokwiBridge/.conda/lib/python3.12/lib-dynload/_sha3.cpython-312-darwin.so

imported by: hashlib

_signal (builtin module)

imported by: signal

_socket /Users/kevinsanto/Documents/GitHub/Jumperless/Jumperless_Wokwi_Bridge_App/JumperlessWokwiBridge/.conda/lib/python3.12/lib-dynload/_socket.cpython-312-darwin.so

imported by: socket

_sre (builtin module)

imports: copy • re

imported by: re • re._compiler • re._constants

_ssl /Users/kevinsanto/Documents/GitHub/Jumperless/Jumperless_Wokwi_Bridge_App/JumperlessWokwiBridge/.conda/lib/python3.12/lib-dynload/_ssl.cpython-312-darwin.so

imports: socket

imported by: ssl

_stat (builtin module)

imported by: stat

_statistics /Users/kevinsanto/Documents/GitHub/Jumperless/Jumperless_Wokwi_Bridge_App/JumperlessWokwiBridge/.conda/lib/python3.12/lib-dynload/_statistics.cpython-312-darwin.so

imported by: statistics

_string (builtin module)

imported by: string

_strptime SourceModule

imports: _thread • calendar • datetime • locale • re • time

imported by: _datetime • _pydatetime • time

_struct /Users/kevinsanto/Documents/GitHub/Jumperless/Jumperless_Wokwi_Bridge_App/JumperlessWokwiBridge/.conda/lib/python3.12/lib-dynload/_struct.cpython-312-darwin.so

imported by: struct

_thread (builtin module)

imported by: _strptime • dataclasses • functools • reprlib • tempfile • threading

_threading_local SourceModule

imports: contextlib • threading • weakref

imported by: threading

_tokenize (builtin module)

imported by: tokenize

_tracemalloc (builtin module)

imported by: tracemalloc

_typing (builtin module)

imported by: typing

_warnings (builtin module)

imported by: importlib._bootstrap_external • warnings

_weakref (builtin module)

imported by: _weakrefset • collections • weakref

_weakrefset SourceModule

imports: _weakref • types

imported by: JumperlessWokwiBridge.py • _py_abc • threading • weakref

_winapi MissingModule

imported by: encodings • mimetypes • ntpath • shutil • subprocess

abc SourceModule

imports: _abc • _py_abc

imported by: JumperlessWokwiBridge.py • _collections_abc • contextlib • dataclasses • email._policybase • functools • importlib._abc • importlib.abc • importlib.metadata • importlib.resources.abc • inspect • io • numbers • os • selectors • typing

argparse SourceModule

imports: copy • gettext • os • re • shutil • sys • textwrap • warnings

imported by: ast • calendar • dis • gzip • inspect • py_compile • tarfile • tokenize • zipfile

array /Users/kevinsanto/Documents/GitHub/Jumperless/Jumperless_Wokwi_Bridge_App/JumperlessWokwiBridge/.conda/lib/python3.12/lib-dynload/array.cpython-312-darwin.so

imported by: socket

ast SourceModule

imports: _ast • argparse • collections • contextlib • enum • inspect • re • sys • warnings

imported by: inspect • traceback

atexit (builtin module)

imported by: logging • weakref

base64 SourceModule

imports: binascii • getopt • re • struct • sys

imported by: email._encoded_words • email.base64mime • email.encoders • encodings.base64_codec • ssl • urllib.request

binascii /Users/kevinsanto/Documents/GitHub/Jumperless/Jumperless_Wokwi_Bridge_App/JumperlessWokwiBridge/.conda/lib/python3.12/lib-dynload/binascii.cpython-312-darwin.so

imported by: base64 • email._encoded_words • email.base64mime • email.contentmanager • email.header • email.message • encodings.hex_codec • encodings.uu_codec • quopri • zipfile

bisect SourceModule

imports: _bisect

imported by: random • statistics • urllib.request

bs4 MissingModule

imported by: JumperlessWokwiBridge.py

builtins (builtin module)

imported by: bz2 • codecs • enum • gettext • gzip • inspect • locale • lzma • operator • reprlib • subprocess • tarfile • tokenize • warnings

bz2 SourceModule

imports: _bz2 • _compression • builtins • io • os

imported by: encodings.bz2_codec • shutil • tarfile • zipfile

calendar SourceModule

imports: argparse • datetime • enum • itertools • locale • sys • warnings

imported by: _strptime • email._parseaddr • http.cookiejar • ssl

codecs SourceModule

imports: _codecs • builtins • encodings • sys

imported by: JumperlessWokwiBridge.py • _pickle • encodings • encodings.ascii • encodings.base64_codec • encodings.big5 • encodings.big5hkscs • encodings.bz2_codec • encodings.charmap • encodings.cp037 • encodings.cp1006 • encodings.cp1026 • encodings.cp1125 • encodings.cp1140 • encodings.cp1250 • encodings.cp1251 • encodings.cp1252 • encodings.cp1253 • encodings.cp1254 • encodings.cp1255 • encodings.cp1256 • encodings.cp1257 • encodings.cp1258 • encodings.cp273 • encodings.cp424 • encodings.cp437 • encodings.cp500 • encodings.cp720 • encodings.cp737 • encodings.cp775 • encodings.cp850 • encodings.cp852 • encodings.cp855 • encodings.cp856 • encodings.cp857 • encodings.cp858 • encodings.cp860 • encodings.cp861 • encodings.cp862 • encodings.cp863 • encodings.cp864 • encodings.cp865 • encodings.cp866 • encodings.cp869 • encodings.cp874 • encodings.cp875 • encodings.cp932 • encodings.cp949 • encodings.cp950 • encodings.euc_jis_2004 • encodings.euc_jisx0213 • encodings.euc_jp • encodings.euc_kr • encodings.gb18030 • encodings.gb2312 • encodings.gbk • encodings.hex_codec • encodings.hp_roman8 • encodings.hz • encodings.idna • encodings.iso2022_jp • encodings.iso2022_jp_1 • encodings.iso2022_jp_2 • encodings.iso2022_jp_2004 • encodings.iso2022_jp_3 • encodings.iso2022_jp_ext • encodings.iso2022_kr • encodings.iso8859_1 • encodings.iso8859_10 • encodings.iso8859_11 • encodings.iso8859_13 • encodings.iso8859_14 • encodings.iso8859_15 • encodings.iso8859_16 • encodings.iso8859_2 • encodings.iso8859_3 • encodings.iso8859_4 • encodings.iso8859_5 • encodings.iso8859_6 • encodings.iso8859_7 • encodings.iso8859_8 • encodings.iso8859_9 • encodings.johab • encodings.koi8_r • encodings.koi8_t • encodings.koi8_u • encodings.kz1048 • encodings.latin_1 • encodings.mac_arabic • encodings.mac_croatian • encodings.mac_cyrillic • encodings.mac_farsi • encodings.mac_greek • encodings.mac_iceland • encodings.mac_latin2 • encodings.mac_roman • encodings.mac_romanian • encodings.mac_turkish • encodings.mbcs • encodings.oem • encodings.palmos • encodings.ptcp154 • encodings.punycode • encodings.quopri_codec • encodings.raw_unicode_escape • encodings.rot_13 • encodings.shift_jis • encodings.shift_jis_2004 • encodings.shift_jisx0213 • encodings.tis_620 • encodings.undefined • encodings.unicode_escape • encodings.utf_16 • encodings.utf_16_be • encodings.utf_16_le • encodings.utf_32 • encodings.utf_32_be • encodings.utf_32_le • encodings.utf_7 • encodings.utf_8 • encodings.utf_8_sig • encodings.uu_codec • encodings.zlib_codec • json • pickle • tokenize

collections Package

imports: _collections • _collections_abc • _weakref • copy • heapq • itertools • keyword • operator • reprlib • sys

imported by: JumperlessWokwiBridge.py • _pydecimal • ast • collections.abc • contextlib • dis • email.feedparser • functools • importlib.metadata • importlib.metadata._collections • importlib.resources.readers • inspect • pprint • selectors • shutil • ssl • statistics • string • threading • tokenize • typing • urllib.parse

collections.abc SourceModule

imports: _collections_abc • collections

imported by: JumperlessWokwiBridge.py • http.client • inspect • logging • selectors • traceback • tracemalloc • typing

contextlib SourceModule

imports: _collections_abc • abc • collections • functools • os • sys • types

imported by: _threading_local • ast • getpass • importlib.metadata • importlib.resources._adapters • importlib.resources._common • subprocess • traceback • typing • urllib.request • zipfile._path

contextvars SourceModule

imports: _contextvars

imported by: _pydecimal

copy SourceModule

imports: copyreg • types • weakref

imported by: _sre • argparse • collections • dataclasses • email.generator • gettext • http.cookiejar • tarfile • weakref

copyreg SourceModule

imports: functools • operator

imported by: JumperlessWokwiBridge.py • _pickle • copy • pickle • re • typing

csv SourceModule

imports: _csv • io • re • types

imported by: importlib.metadata

dataclasses SourceModule

imports: _thread • abc • copy • functools • inspect • itertools • keyword • re • sys • types

imported by: pprint

datetime SourceModule

imports: _datetime • _pydatetime • time

imported by: _strptime • calendar • email.utils • http.cookiejar

decimal SourceModule

imports: _decimal • _pydecimal

imported by: fractions • statistics

dis SourceModule

imports: argparse • collections • io • opcode • sys • types

imported by: inspect

email Package

imports: email._header_value_parser • email.charset • email.errors • email.header • email.parser

imported by: email._encoded_words • email._header_value_parser • email._parseaddr • email._policybase • email.base64mime • email.charset • email.contentmanager • email.encoders • email.errors • email.feedparser • email.generator • email.header • email.headerregistry • email.iterators • email.message • email.parser • email.policy • email.quoprimime • email.utils • importlib.metadata • urllib.request

email._encoded_words SourceModule

imports: base64 • binascii • email • email.errors • functools • re • string

imported by: email._header_value_parser • email.message

email._header_value_parser SourceModule

imports: email • email._encoded_words • email.errors • email.utils • operator • re • string • sys • urllib

imported by: email • email.headerregistry

email._parseaddr SourceModule

imports: calendar • email • time

imported by: email.utils

email._policybase SourceModule

imports: abc • email • email.charset • email.header • email.utils

imported by: email.feedparser • email.message • email.parser • email.policy

email.base64mime SourceModule

imports: base64 • binascii • email

imported by: email.charset • email.header

email.charset SourceModule

imports: email • email.base64mime • email.encoders • email.errors • email.quoprimime • functools

imported by: email • email._policybase • email.contentmanager • email.header • email.message • email.utils

email.contentmanager SourceModule

imports: binascii • email • email.charset • email.errors • email.message • email.quoprimime

imported by: email.policy

email.encoders SourceModule

imports: base64 • email • quopri

imported by: email.charset

email.errors SourceModule

imports: email

imported by: email • email._encoded_words • email._header_value_parser • email.charset • email.contentmanager • email.feedparser • email.header • email.headerregistry • email.message

email.feedparser SourceModule

imports: collections • email • email._policybase • email.errors • email.message • io • re

imported by: email.parser

email.generator SourceModule

imports: copy • email • email.utils • io • random • re • sys • time

imported by: email.message

email.header SourceModule

imports: binascii • email • email.base64mime • email.charset • email.errors • email.quoprimime • re

imported by: email • email._policybase

email.headerregistry SourceModule

imports: email • email._header_value_parser • email.errors • email.utils • types

imported by: email.policy

email.iterators SourceModule

imports: email • io • sys

imported by: email.message

email.message SourceModule

imports: binascii • email • email._encoded_words • email._policybase • email.charset • email.errors • email.generator • email.iterators • email.policy • email.utils • io • quopri • re

imported by: email.contentmanager • email.feedparser • email.policy • http.client • importlib.metadata._adapters

email.parser SourceModule

imports: email • email._policybase • email.feedparser • io

imported by: email • http.client

email.policy SourceModule

imports: email • email._policybase • email.contentmanager • email.headerregistry • email.message • email.utils • re • sys

imported by: email.message

email.quoprimime SourceModule

imports: email • re • string

imported by: email.charset • email.contentmanager • email.header

email.utils SourceModule

imports: datetime • email • email._parseaddr • email.charset • os • random • re • socket • time • urllib.parse • warnings

imported by: email._header_value_parser • email._policybase • email.generator • email.headerregistry • email.message • email.policy • urllib.request

encodings Package

imports: _winapi • codecs • encodings • encodings.aliases • encodings.ascii • encodings.base64_codec • encodings.big5 • encodings.big5hkscs • encodings.bz2_codec • encodings.charmap • encodings.cp037 • encodings.cp1006 • encodings.cp1026 • encodings.cp1125 • encodings.cp1140 • encodings.cp1250 • encodings.cp1251 • encodings.cp1252 • encodings.cp1253 • encodings.cp1254 • encodings.cp1255 • encodings.cp1256 • encodings.cp1257 • encodings.cp1258 • encodings.cp273 • encodings.cp424 • encodings.cp437 • encodings.cp500 • encodings.cp720 • encodings.cp737 • encodings.cp775 • encodings.cp850 • encodings.cp852 • encodings.cp855 • encodings.cp856 • encodings.cp857 • encodings.cp858 • encodings.cp860 • encodings.cp861 • encodings.cp862 • encodings.cp863 • encodings.cp864 • encodings.cp865 • encodings.cp866 • encodings.cp869 • encodings.cp874 • encodings.cp875 • encodings.cp932 • encodings.cp949 • encodings.cp950 • encodings.euc_jis_2004 • encodings.euc_jisx0213 • encodings.euc_jp • encodings.euc_kr • encodings.gb18030 • encodings.gb2312 • encodings.gbk • encodings.hex_codec • encodings.hp_roman8 • encodings.hz • encodings.idna • encodings.iso2022_jp • encodings.iso2022_jp_1 • encodings.iso2022_jp_2 • encodings.iso2022_jp_2004 • encodings.iso2022_jp_3 • encodings.iso2022_jp_ext • encodings.iso2022_kr • encodings.iso8859_1 • encodings.iso8859_10 • encodings.iso8859_11 • encodings.iso8859_13 • encodings.iso8859_14 • encodings.iso8859_15 • encodings.iso8859_16 • encodings.iso8859_2 • encodings.iso8859_3 • encodings.iso8859_4 • encodings.iso8859_5 • encodings.iso8859_6 • encodings.iso8859_7 • encodings.iso8859_8 • encodings.iso8859_9 • encodings.johab • encodings.koi8_r • encodings.koi8_t • encodings.koi8_u • encodings.kz1048 • encodings.latin_1 • encodings.mac_arabic • encodings.mac_croatian • encodings.mac_cyrillic • encodings.mac_farsi • encodings.mac_greek • encodings.mac_iceland • encodings.mac_latin2 • encodings.mac_roman • encodings.mac_romanian • encodings.mac_turkish • encodings.mbcs • encodings.oem • encodings.palmos • encodings.ptcp154 • encodings.punycode • encodings.quopri_codec • encodings.raw_unicode_escape • encodings.rot_13 • encodings.shift_jis • encodings.shift_jis_2004 • encodings.shift_jisx0213 • encodings.tis_620 • encodings.undefined • encodings.unicode_escape • encodings.utf_16 • encodings.utf_16_be • encodings.utf_16_le • encodings.utf_32 • encodings.utf_32_be • encodings.utf_32_le • encodings.utf_7 • encodings.utf_8 • encodings.utf_8_sig • encodings.uu_codec • encodings.zlib_codec • sys

imported by: JumperlessWokwiBridge.py • codecs • encodings • encodings.aliases • encodings.ascii • encodings.base64_codec • encodings.big5 • encodings.big5hkscs • encodings.bz2_codec • encodings.charmap • encodings.cp037 • encodings.cp1006 • encodings.cp1026 • encodings.cp1125 • encodings.cp1140 • encodings.cp1250 • encodings.cp1251 • encodings.cp1252 • encodings.cp1253 • encodings.cp1254 • encodings.cp1255 • encodings.cp1256 • encodings.cp1257 • encodings.cp1258 • encodings.cp273 • encodings.cp424 • encodings.cp437 • encodings.cp500 • encodings.cp720 • encodings.cp737 • encodings.cp775 • encodings.cp850 • encodings.cp852 • encodings.cp855 • encodings.cp856 • encodings.cp857 • encodings.cp858 • encodings.cp860 • encodings.cp861 • encodings.cp862 • encodings.cp863 • encodings.cp864 • encodings.cp865 • encodings.cp866 • encodings.cp869 • encodings.cp874 • encodings.cp875 • encodings.cp932 • encodings.cp949 • encodings.cp950 • encodings.euc_jis_2004 • encodings.euc_jisx0213 • encodings.euc_jp • encodings.euc_kr • encodings.gb18030 • encodings.gb2312 • encodings.gbk • encodings.hex_codec • encodings.hp_roman8 • encodings.hz • encodings.idna • encodings.iso2022_jp • encodings.iso2022_jp_1 • encodings.iso2022_jp_2 • encodings.iso2022_jp_2004 • encodings.iso2022_jp_3 • encodings.iso2022_jp_ext • encodings.iso2022_kr • encodings.iso8859_1 • encodings.iso8859_10 • encodings.iso8859_11 • encodings.iso8859_13 • encodings.iso8859_14 • encodings.iso8859_15 • encodings.iso8859_16 • encodings.iso8859_2 • encodings.iso8859_3 • encodings.iso8859_4 • encodings.iso8859_5 • encodings.iso8859_6 • encodings.iso8859_7 • encodings.iso8859_8 • encodings.iso8859_9 • encodings.johab • encodings.koi8_r • encodings.koi8_t • encodings.koi8_u • encodings.kz1048 • encodings.latin_1 • encodings.mac_arabic • encodings.mac_croatian • encodings.mac_cyrillic • encodings.mac_farsi • encodings.mac_greek • encodings.mac_iceland • encodings.mac_latin2 • encodings.mac_roman • encodings.mac_romanian • encodings.mac_turkish • encodings.mbcs • encodings.oem • encodings.palmos • encodings.ptcp154 • encodings.punycode • encodings.quopri_codec • encodings.raw_unicode_escape • encodings.rot_13 • encodings.shift_jis • encodings.shift_jis_2004 • encodings.shift_jisx0213 • encodings.tis_620 • encodings.undefined • encodings.unicode_escape • encodings.utf_16 • encodings.utf_16_be • encodings.utf_16_le • encodings.utf_32 • encodings.utf_32_be • encodings.utf_32_le • encodings.utf_7 • encodings.utf_8 • encodings.utf_8_sig • encodings.uu_codec • encodings.zlib_codec • locale

encodings.aliases SourceModule

imports: encodings

imported by: JumperlessWokwiBridge.py • encodings • locale

encodings.ascii SourceModule

imports: codecs • encodings

imported by: JumperlessWokwiBridge.py • encodings

encodings.base64_codec SourceModule

imports: base64 • codecs • encodings

imported by: JumperlessWokwiBridge.py • encodings

encodings.big5 SourceModule

imports: _codecs_tw • _multibytecodec • codecs • encodings

imported by: JumperlessWokwiBridge.py • encodings

encodings.big5hkscs SourceModule

imports: _codecs_hk • _multibytecodec • codecs • encodings

imported by: JumperlessWokwiBridge.py • encodings

encodings.bz2_codec SourceModule

imports: bz2 • codecs • encodings

imported by: JumperlessWokwiBridge.py • encodings

encodings.charmap SourceModule

imports: codecs • encodings

imported by: JumperlessWokwiBridge.py • encodings

encodings.cp037 SourceModule

imports: codecs • encodings

imported by: JumperlessWokwiBridge.py • encodings

encodings.cp1006 SourceModule

imports: codecs • encodings

imported by: JumperlessWokwiBridge.py • encodings

encodings.cp1026 SourceModule

imports: codecs • encodings

imported by: JumperlessWokwiBridge.py • encodings

encodings.cp1125 SourceModule

imports: codecs • encodings

imported by: JumperlessWokwiBridge.py • encodings

encodings.cp1140 SourceModule

imports: codecs • encodings

imported by: JumperlessWokwiBridge.py • encodings

encodings.cp1250 SourceModule

imports: codecs • encodings

imported by: JumperlessWokwiBridge.py • encodings

encodings.cp1251 SourceModule

imports: codecs • encodings

imported by: JumperlessWokwiBridge.py • encodings

encodings.cp1252 SourceModule

imports: codecs • encodings

imported by: JumperlessWokwiBridge.py • encodings

encodings.cp1253 SourceModule

imports: codecs • encodings

imported by: JumperlessWokwiBridge.py • encodings

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

encodings.punycode SourceModule

imports: codecs • encodings

imported by: JumperlessWokwiBridge.py • encodings

encodings.quopri_codec SourceModule

imports: codecs • encodings • io • quopri

imported by: JumperlessWokwiBridge.py • encodings

encodings.raw_unicode_escape SourceModule

imports: codecs • encodings

imported by: JumperlessWokwiBridge.py • encodings

encodings.rot_13 SourceModule

imports: codecs • encodings • sys

imported by: JumperlessWokwiBridge.py • encodings

encodings.shift_jis SourceModule

imports: _codecs_jp • _multibytecodec • codecs • encodings

imported by: JumperlessWokwiBridge.py • encodings

encodings.shift_jis_2004 SourceModule

imports: _codecs_jp • _multibytecodec • codecs • encodings

imported by: JumperlessWokwiBridge.py • encodings

encodings.shift_jisx0213 SourceModule

imports: _codecs_jp • _multibytecodec • codecs • encodings

imported by: JumperlessWokwiBridge.py • encodings

encodings.tis_620 SourceModule

imports: codecs • encodings

imported by: JumperlessWokwiBridge.py • encodings

encodings.undefined SourceModule

imports: codecs • encodings

imported by: JumperlessWokwiBridge.py • encodings

encodings.unicode_escape SourceModule

imports: codecs • encodings

imported by: JumperlessWokwiBridge.py • encodings

encodings.utf_16 SourceModule

imports: codecs • encodings • sys

imported by: JumperlessWokwiBridge.py • encodings

encodings.utf_16_be SourceModule

imports: codecs • encodings

imported by: JumperlessWokwiBridge.py • encodings

encodings.utf_16_le SourceModule

imports: codecs • encodings

imported by: JumperlessWokwiBridge.py • encodings

encodings.utf_32 SourceModule

imports: codecs • encodings • sys

imported by: JumperlessWokwiBridge.py • encodings

encodings.utf_32_be SourceModule

imports: codecs • encodings

imported by: JumperlessWokwiBridge.py • encodings

encodings.utf_32_le SourceModule

imports: codecs • encodings

imported by: JumperlessWokwiBridge.py • encodings

encodings.utf_7 SourceModule

imports: codecs • encodings

imported by: JumperlessWokwiBridge.py • encodings

encodings.utf_8 SourceModule

imports: codecs • encodings

imported by: JumperlessWokwiBridge.py • encodings

encodings.utf_8_sig SourceModule

imports: codecs • encodings

imported by: JumperlessWokwiBridge.py • encodings

encodings.uu_codec SourceModule

imports: binascii • codecs • encodings • io

imported by: JumperlessWokwiBridge.py • encodings

encodings.zlib_codec SourceModule

imports: codecs • encodings • zlib

imported by: JumperlessWokwiBridge.py • encodings

enum SourceModule

imports: builtins • functools • operator • sys • types • warnings

imported by: JumperlessWokwiBridge.py • ast • calendar • http • inspect • py_compile • re • signal • socket • ssl

errno (builtin module)

imported by: gettext • gzip • http.client • pathlib • shutil • socket • ssl • subprocess • tempfile

fcntl /Users/kevinsanto/Documents/GitHub/Jumperless/Jumperless_Wokwi_Bridge_App/JumperlessWokwiBridge/.conda/lib/python3.12/lib-dynload/fcntl.cpython-312-darwin.so

imported by: subprocess

fnmatch SourceModule

imports: functools • os • posixpath • re

imported by: pathlib • shutil • tracemalloc • urllib.request

fractions SourceModule

imports: decimal • functools • math • numbers • operator • re • sys

imported by: statistics

ftplib SourceModule

imports: netrc • re • socket • ssl • sys

imported by: urllib.request

functools SourceModule

imports: _functools • _thread • abc • collections • reprlib • types • typing • weakref

imported by: JumperlessWokwiBridge.py • contextlib • copyreg • dataclasses • email._encoded_words • email.charset • enum • fnmatch • fractions • importlib.metadata • importlib.metadata._adapters • importlib.metadata._functools • importlib.resources._common • importlib.resources._legacy • inspect • ipaddress • linecache • locale • operator • pathlib • pickle • re • statistics • tempfile • threading • tokenize • tracemalloc • types • typing • urllib.parse

gc (builtin module)

imports: time

imported by: _posixsubprocess • weakref

genericpath SourceModule

imports: os • stat

imported by: JumperlessWokwiBridge.py • ntpath • posixpath

getopt SourceModule

imports: gettext • os • sys

imported by: base64 • mimetypes • quopri

getpass SourceModule

imports: contextlib • io • msvcrt • os • pwd • sys • termios • warnings

imported by: urllib.request

gettext SourceModule

imports: builtins • copy • errno • locale • operator • os • re • struct • sys • warnings

imported by: argparse • getopt

grp /Users/kevinsanto/Documents/GitHub/Jumperless/Jumperless_Wokwi_Bridge_App/JumperlessWokwiBridge/.conda/lib/python3.12/lib-dynload/grp.cpython-312-darwin.so

imported by: pathlib • shutil • subprocess • tarfile

gzip SourceModule

imports: _compression • argparse • builtins • errno • io • os • struct • sys • time • warnings • zlib

imported by: tarfile

hashlib SourceModule

imports: _blake2 • _hashlib • _md5 • _sha1 • _sha2 • _sha3 • logging

imported by: random • urllib.request

heapq SourceModule

imports: _heapq

imported by: JumperlessWokwiBridge.py • collections

http Package

imports: enum

imported by: http.client • http.cookiejar

http.client SourceModule

imports: collections.abc • email.message • email.parser • errno • http • io • re • socket • ssl • sys • urllib.parse

imported by: http.cookiejar • urllib.request

http.cookiejar SourceModule

imports: calendar • copy • datetime • http • http.client • io • logging • os • re • threading • time • traceback • urllib.parse • urllib.request • warnings

imported by: urllib.request

importlib Package

imports: _frozen_importlib • _frozen_importlib_external • _imp • importlib • importlib._bootstrap • importlib._bootstrap_external • importlib.machinery • sys • warnings

imported by: importlib • importlib._abc • importlib._bootstrap • importlib._bootstrap_external • importlib.abc • importlib.machinery • importlib.metadata • importlib.readers • importlib.resources • importlib.resources._common • importlib.util • inspect

importlib._abc SourceModule

imports: abc • importlib • importlib._bootstrap

imported by: importlib.abc • importlib.util

importlib._bootstrap SourceModule

imports: _frozen_importlib_external • importlib

imported by: importlib • importlib._abc • importlib.machinery • importlib.util

importlib._bootstrap_external SourceModule

imports: _imp • _io • _warnings • importlib • importlib.metadata • importlib.readers • marshal • nt • posix • sys • tokenize • winreg

imported by: importlib • importlib.abc • importlib.machinery • importlib.util • py_compile

importlib.abc SourceModule

imports: _frozen_importlib • _frozen_importlib_external • abc • importlib • importlib._abc • importlib._bootstrap_external • importlib.machinery • importlib.resources • importlib.resources.abc • warnings

imported by: importlib.metadata

importlib.machinery SourceModule

imports: importlib • importlib._bootstrap • importlib._bootstrap_external

imported by: importlib • importlib.abc • inspect • py_compile

importlib.metadata Package

imports: abc • collections • contextlib • csv • email • functools • importlib • importlib.abc • importlib.metadata • importlib.metadata._adapters • importlib.metadata._collections • importlib.metadata._functools • importlib.metadata._itertools • importlib.metadata._meta • inspect • itertools • operator • os • pathlib • posixpath • re • sys • textwrap • typing • warnings • zipfile

imported by: importlib._bootstrap_external • importlib.metadata • importlib.metadata._adapters • importlib.metadata._collections • importlib.metadata._functools • importlib.metadata._itertools • importlib.metadata._meta • importlib.metadata._text

importlib.metadata._adapters SourceModule

imports: email.message • functools • importlib.metadata • importlib.metadata._text • re • textwrap • warnings

imported by: importlib.metadata

importlib.metadata._collections SourceModule

imports: collections • importlib.metadata

imported by: importlib.metadata

importlib.metadata._functools SourceModule

imports: functools • importlib.metadata • types

imported by: importlib.metadata • importlib.metadata._text

importlib.metadata._itertools SourceModule

imports: importlib.metadata • itertools

imported by: importlib.metadata

importlib.metadata._meta SourceModule

imports: importlib.metadata • typing

imported by: importlib.metadata

importlib.metadata._text SourceModule

imports: importlib.metadata • importlib.metadata._functools • re

imported by: importlib.metadata._adapters

importlib.readers SourceModule

imports: importlib • importlib.resources.readers

imported by: importlib._bootstrap_external

importlib.resources Package

imports: importlib • importlib.resources • importlib.resources._common • importlib.resources._legacy • importlib.resources.abc

imported by: importlib.abc • importlib.resources • importlib.resources._adapters • importlib.resources._common • importlib.resources._itertools • importlib.resources._legacy • importlib.resources.abc • importlib.resources.readers

importlib.resources._adapters SourceModule

imports: contextlib • importlib.resources • importlib.resources.abc • io

imported by: importlib.resources._common

importlib.resources._common SourceModule

imports: contextlib • functools • importlib • importlib.resources • importlib.resources._adapters • importlib.resources.abc • inspect • itertools • os • pathlib • tempfile • types • typing • warnings

imported by: importlib.resources • importlib.resources._legacy

importlib.resources._itertools SourceModule

imports: importlib.resources

imported by: importlib.resources.readers

importlib.resources._legacy SourceModule

imports: functools • importlib.resources • importlib.resources._common • os • pathlib • types • typing • warnings

imported by: importlib.resources

importlib.resources.abc SourceModule

imports: abc • importlib.resources • io • itertools • os • pathlib • typing

imported by: importlib.abc • importlib.resources • importlib.resources._adapters • importlib.resources._common • importlib.resources.readers

importlib.resources.readers SourceModule

imports: collections • importlib.resources • importlib.resources._itertools • importlib.resources.abc • itertools • operator • pathlib • zipfile

imported by: importlib.readers

importlib.util SourceModule

imports: _imp • importlib • importlib._abc • importlib._bootstrap • importlib._bootstrap_external • sys • threading • types

imported by: py_compile • zipfile

inspect SourceModule

imports: abc • argparse • ast • builtins • collections • collections.abc • dis • enum • functools • importlib • importlib.machinery • itertools • keyword • linecache • operator • os • re • sys • token • tokenize • types

imported by: ast • dataclasses • importlib.metadata • importlib.resources._common • pyi_rth_inspect.py • typing

io SourceModule

imports: _io • abc

imported by: JumperlessWokwiBridge.py • _compression • bz2 • csv • dis • email.feedparser • email.generator • email.iterators • email.message • email.parser • encodings.quopri_codec • encodings.uu_codec • getpass • gzip • http.client • http.cookiejar • importlib.resources._adapters • importlib.resources.abc • logging • lzma • os • pathlib • pickle • pprint • quopri • socket • subprocess • tarfile • tempfile • tokenize • urllib.error • urllib.request • zipfile • zipfile._path

ipaddress SourceModule

imports: functools • re

imported by: urllib.parse • urllib.request

itertools (builtin module)

imported by: _pydecimal • calendar • collections • dataclasses • importlib.metadata • importlib.metadata._itertools • importlib.resources._common • importlib.resources.abc • importlib.resources.readers • inspect • pickle • random • reprlib • statistics • threading • tokenize • traceback • weakref • zipfile._path

json Package

imports: codecs • json.decoder • json.encoder • json.scanner

imported by: JumperlessWokwiBridge.py • json.decoder • json.encoder • json.scanner

json.decoder SourceModule

imports: _json • json • json.scanner • re

imported by: _json • json

json.encoder SourceModule

imports: _json • json • re

imported by: json

json.scanner SourceModule

imports: _json • json • re

imported by: json • json.decoder

keyword SourceModule

imported by: JumperlessWokwiBridge.py • collections • dataclasses • inspect

linecache SourceModule

imports: functools • os • sys • tokenize

imported by: JumperlessWokwiBridge.py • inspect • traceback • tracemalloc • warnings

locale SourceModule

imports: _collections_abc • _locale • builtins • encodings • encodings.aliases • functools • os • re • sys • warnings

imported by: JumperlessWokwiBridge.py • _pydecimal • _strptime • calendar • gettext • subprocess

logging Package

imports: atexit • collections.abc • io • os • pickle • re • string • sys • threading • time • traceback • types • warnings • weakref

imported by: hashlib • http.cookiejar

lzma SourceModule

imports: _compression • _lzma • builtins • io • os

imported by: shutil • tarfile • zipfile

marshal (builtin module)

imported by: importlib._bootstrap_external

math /Users/kevinsanto/Documents/GitHub/Jumperless/Jumperless_Wokwi_Bridge_App/JumperlessWokwiBridge/.conda/lib/python3.12/lib-dynload/math.cpython-312-darwin.so

imported by: _pydatetime • _pydecimal • fractions • random • selectors • statistics • urllib.parse

mimetypes SourceModule

imports: _winapi • getopt • os • posixpath • sys • urllib.parse • winreg

imported by: urllib.request

msvcrt MissingModule

imported by: getpass • subprocess

netrc SourceModule

imports: os • pwd • stat

imported by: ftplib

nt MissingModule

imported by: importlib._bootstrap_external • ntpath • os • shutil

ntpath SourceModule

imports: _winapi • genericpath • nt • os • stat • string • sys

imported by: JumperlessWokwiBridge.py • os • pathlib

nturl2path SourceModule

imports: string • urllib.parse

imported by: urllib.request

numbers SourceModule

imports: abc

imported by: _pydecimal • fractions • statistics

opcode SourceModule

imports: _opcode

imported by: dis

operator SourceModule

imports: _operator • builtins • functools

imported by: JumperlessWokwiBridge.py • _pydatetime • collections • copyreg • email._header_value_parser • enum • fractions • gettext • importlib.metadata • importlib.resources.readers • inspect • random • statistics • typing

os SourceModule

imports: _collections_abc • abc • io • nt • ntpath • posix • posixpath • posixpath • stat • subprocess • sys • warnings

imported by: JumperlessWokwiBridge.py • argparse • bz2 • contextlib • email.utils • fnmatch • genericpath • getopt • getpass • gettext • gzip • http.cookiejar • importlib.metadata • importlib.resources._common • importlib.resources._legacy • importlib.resources.abc • inspect • linecache • locale • logging • lzma • mimetypes • netrc • ntpath • pathlib • posixpath • posixpath • py_compile • pyi_rth_inspect.py • random • shutil • socket • ssl • subprocess • tarfile • tempfile • threading • urllib.request • zipfile

pathlib SourceModule

imports: _collections_abc • errno • fnmatch • functools • grp • io • ntpath • os • posixpath • pwd • re • stat • sys • urllib.parse • warnings

imported by: JumperlessWokwiBridge.py • importlib.metadata • importlib.resources._common • importlib.resources._legacy • importlib.resources.abc • importlib.resources.readers • zipfile._path

pickle SourceModule

imports: _compat_pickle • _pickle • codecs • copyreg • functools • io • itertools • pprint • re • struct • sys • types

imported by: logging • tracemalloc

posix (builtin module)

imports: resource

imported by: importlib._bootstrap_external • os • posixpath • shutil

posixpath AliasNode

imports: os • posixpath

imported by: os • py_compile • tracemalloc

posixpath SourceModule

imports: genericpath • os • posix • pwd • re • stat • sys

imported by: JumperlessWokwiBridge.py • fnmatch • importlib.metadata • mimetypes • os • pathlib • posixpath • zipfile._path

pprint SourceModule

imports: collections • dataclasses • io • re • sys • types

imported by: pickle

psutil MissingModule

imported by: JumperlessWokwiBridge.py

pwd (builtin module)

imported by: getpass • netrc • pathlib • posixpath • shutil • subprocess • tarfile

py_compile SourceModule

imports: argparse • enum • importlib._bootstrap_external • importlib.machinery • importlib.util • os • posixpath • sys • traceback

imported by: zipfile

pyduinocli MissingModule

imported by: JumperlessWokwiBridge.py

quopri SourceModule

imports: binascii • getopt • io • sys

imported by: email.encoders • email.message • encodings.quopri_codec

random SourceModule

imports: _collections_abc • _random • _sha2 • bisect • hashlib • itertools • math • operator • os • statistics • time • warnings

imported by: email.generator • email.utils • statistics • tempfile

re Package

imports: _sre • copyreg • enum • functools • re • re._compiler • re._constants • re._parser • warnings

imported by: JumperlessWokwiBridge.py • _pydecimal • _sre • _strptime • argparse • ast • base64 • csv • dataclasses • email._encoded_words • email._header_value_parser • email.feedparser • email.generator • email.header • email.message • email.policy • email.quoprimime • email.utils • encodings.idna • fnmatch • fractions • ftplib • gettext • http.client • http.cookiejar • importlib.metadata • importlib.metadata._adapters • importlib.metadata._text • inspect • ipaddress • json.decoder • json.encoder • json.scanner • locale • logging • pathlib • pickle • posixpath • pprint • re • re._casefix • re._compiler • re._constants • re._parser • sre_compile • sre_constants • sre_parse • string • tarfile • textwrap • tokenize • typing • urllib.parse • urllib.request • warnings • zipfile._path • zipfile._path.glob

re._casefix SourceModule

imports: re

imported by: JumperlessWokwiBridge.py • re._compiler

re._compiler SourceModule

imports: _sre • re • re._casefix • re._constants • re._parser • sys

imported by: JumperlessWokwiBridge.py • re • sre_compile

re._constants SourceModule

imports: _sre • re

imported by: JumperlessWokwiBridge.py • re • re._compiler • re._parser • sre_constants

re._parser SourceModule

imports: re • re._constants • unicodedata • warnings

imported by: JumperlessWokwiBridge.py • re • re._compiler • sre_parse

reprlib SourceModule

imports: _thread • builtins • itertools

imported by: JumperlessWokwiBridge.py • collections • functools

requests MissingModule

imported by: JumperlessWokwiBridge.py

resource /Users/kevinsanto/Documents/GitHub/Jumperless/Jumperless_Wokwi_Bridge_App/JumperlessWokwiBridge/.conda/lib/python3.12/lib-dynload/resource.cpython-312-darwin.so

imported by: posix

select /Users/kevinsanto/Documents/GitHub/Jumperless/Jumperless_Wokwi_Bridge_App/JumperlessWokwiBridge/.conda/lib/python3.12/lib-dynload/select.cpython-312-darwin.so

imported by: selectors • subprocess

selectors SourceModule

imports: abc • collections • collections.abc • math • select • sys

imported by: socket • subprocess

serial MissingModule

imported by: JumperlessWokwiBridge.py

shutil SourceModule

imports: _winapi • bz2 • collections • errno • fnmatch • grp • lzma • nt • os • posix • pwd • stat • sys • tarfile • warnings • zipfile • zlib

imported by: JumperlessWokwiBridge.py • argparse • tarfile • tempfile • zipfile

signal SourceModule

imports: _signal • enum

imported by: subprocess

socket SourceModule

imports: _socket • array • enum • errno • io • os • selectors • sys

imported by: _ssl • email.utils • ftplib • http.client • ssl • urllib.request

sre_compile SourceModule

imports: re • re._compiler • warnings

imported by: JumperlessWokwiBridge.py

sre_constants SourceModule

imports: re • re._constants • warnings

imported by: JumperlessWokwiBridge.py

sre_parse SourceModule

imports: re • re._parser • warnings

imported by: JumperlessWokwiBridge.py

ssl SourceModule

imports: _ssl • base64 • calendar • collections • enum • errno • os • socket • sys • time • warnings

imported by: JumperlessWokwiBridge.py • ftplib • http.client • urllib.request

stat SourceModule

imports: _stat

imported by: JumperlessWokwiBridge.py • genericpath • netrc • ntpath • os • pathlib • posixpath • shutil • tarfile • zipfile

statistics SourceModule

imports: _statistics • bisect • collections • decimal • fractions • functools • itertools • math • numbers • operator • random • sys

imported by: random

string SourceModule

imports: _string • collections • re

imported by: email._encoded_words • email._header_value_parser • email.quoprimime • logging • ntpath • nturl2path • urllib.request

stringprep SourceModule

imports: unicodedata

imported by: encodings.idna

struct SourceModule

imports: _struct

imported by: base64 • gettext • gzip • pickle • tarfile • zipfile

subprocess SourceModule

imports: _posixsubprocess • _winapi • builtins • contextlib • errno • fcntl • grp • io • locale • msvcrt • os • pwd • select • selectors • signal • sys • threading • time • types • warnings

imported by: os

sys (builtin module)

imported by: JumperlessWokwiBridge.py • _collections_abc • _compression • _pydatetime • _pydecimal • argparse • ast • base64 • calendar • codecs • collections • contextlib • dataclasses • dis • email._header_value_parser • email.generator • email.iterators • email.policy • encodings • encodings.rot_13 • encodings.utf_16 • encodings.utf_32 • enum • fractions • ftplib • getopt • getpass • gettext • gzip • http.client • importlib • importlib._bootstrap_external • importlib.metadata • importlib.util • inspect • linecache • locale • logging • mimetypes • ntpath • os • pathlib • pickle • posixpath • pprint • py_compile • pyi_rth_inspect.py • quopri • re._compiler • selectors • shutil • socket • ssl • statistics • subprocess • tarfile • tempfile • threading • tokenize • traceback • types • typing • urllib.request • warnings • weakref • zipfile

tarfile SourceModule

imports: argparse • builtins • bz2 • copy • grp • gzip • io • lzma • os • pwd • re • shutil • stat • struct • sys • time • warnings • zlib

imported by: shutil

tempfile SourceModule

imports: _thread • errno • functools • io • os • random • shutil • sys • types • warnings • weakref

imported by: importlib.resources._common • urllib.request • urllib.response

termios /Users/kevinsanto/Documents/GitHub/Jumperless/Jumperless_Wokwi_Bridge_App/JumperlessWokwiBridge/.conda/lib/python3.12/lib-dynload/termios.cpython-312-darwin.so

imported by: getpass

textwrap SourceModule

imports: re

imported by: argparse • importlib.metadata • importlib.metadata._adapters • traceback

threading SourceModule

imports: _collections • _thread • _threading_local • _weakrefset • collections • functools • itertools • os • sys • time • traceback • warnings

imported by: JumperlessWokwiBridge.py • _threading_local • http.cookiejar • importlib.util • logging • subprocess • zipfile

time (builtin module)

imports: _strptime

imported by: JumperlessWokwiBridge.py • _datetime • _pydatetime • _strptime • datetime • email._parseaddr • email.generator • email.utils • gc • gzip • http.cookiejar • logging • random • ssl • subprocess • tarfile • threading • urllib.request • zipfile

token SourceModule

imported by: inspect • tokenize

tokenize SourceModule

imports: _tokenize • argparse • builtins • codecs • collections • functools • io • itertools • re • sys • token

imported by: importlib._bootstrap_external • inspect • linecache

traceback SourceModule

imports: ast • collections.abc • contextlib • itertools • linecache • sys • textwrap • unicodedata

imported by: JumperlessWokwiBridge.py • http.cookiejar • logging • py_compile • threading • warnings

tracemalloc SourceModule

imports: _tracemalloc • collections.abc • fnmatch • functools • linecache • pickle • posixpath

imported by: warnings

types SourceModule

imports: _collections_abc • functools • sys

imported by: JumperlessWokwiBridge.py • _weakrefset • contextlib • copy • csv • dataclasses • dis • email.headerregistry • enum • functools • importlib.metadata._functools • importlib.resources._common • importlib.resources._legacy • importlib.util • inspect • logging • pickle • pprint • subprocess • tempfile • typing • urllib.parse

typing SourceModule

imports: _typing • abc • collections • collections.abc • contextlib • copyreg • functools • inspect • operator • re • sys • types • warnings

imported by: functools • importlib.metadata • importlib.metadata._meta • importlib.resources._common • importlib.resources._legacy • importlib.resources.abc

unicodedata /Users/kevinsanto/Documents/GitHub/Jumperless/Jumperless_Wokwi_Bridge_App/JumperlessWokwiBridge/.conda/lib/python3.12/lib-dynload/unicodedata.cpython-312-darwin.so

imported by: encodings.idna • re._parser • stringprep • traceback • urllib.parse

urllib Package

imported by: email._header_value_parser • urllib.error • urllib.parse • urllib.request • urllib.response

urllib.error SourceModule

imports: io • urllib • urllib.response

imported by: urllib.request

urllib.parse SourceModule

imports: collections • functools • ipaddress • math • re • types • unicodedata • urllib • warnings

imported by: email.utils • http.client • http.cookiejar • mimetypes • nturl2path • pathlib • urllib.request

urllib.request SourceModule

imports: _scproxy • base64 • bisect • contextlib • email • email.utils • fnmatch • ftplib • getpass • hashlib • http.client • http.cookiejar • io • ipaddress • mimetypes • nturl2path • os • re • socket • ssl • string • sys • tempfile • time • urllib • urllib.error • urllib.parse • urllib.response • warnings • winreg

imported by: JumperlessWokwiBridge.py • http.cookiejar

urllib.response SourceModule

imports: tempfile • urllib

imported by: urllib.error • urllib.request

warnings SourceModule

imports: _warnings • builtins • linecache • re • sys • traceback • tracemalloc

imported by: JumperlessWokwiBridge.py • _collections_abc • _pydatetime • argparse • ast • calendar • email.utils • enum • getpass • gettext • gzip • http.cookiejar • importlib • importlib.abc • importlib.metadata • importlib.metadata._adapters • importlib.resources._common • importlib.resources._legacy • locale • logging • os • pathlib • random • re • re._parser • shutil • sre_compile • sre_constants • sre_parse • ssl • subprocess • tarfile • tempfile • threading • typing • urllib.parse • urllib.request • zipfile

weakref SourceModule

imports: _collections_abc • _weakref • _weakrefset • atexit • copy • gc • itertools • sys

imported by: JumperlessWokwiBridge.py • _threading_local • copy • functools • logging • tempfile

winreg MissingModule

imported by: importlib._bootstrap_external • mimetypes • urllib.request

zipfile Package

imports: argparse • binascii • bz2 • importlib.util • io • lzma • os • py_compile • shutil • stat • struct • sys • threading • time • warnings • zipfile._path • zlib

imported by: importlib.metadata • importlib.resources.readers • shutil • zipfile._path

zipfile._path Package

imports: contextlib • io • itertools • pathlib • posixpath • re • zipfile • zipfile._path.glob

imported by: zipfile • zipfile._path.glob

zipfile._path.glob SourceModule

imports: re • zipfile._path

imported by: zipfile._path

zlib /Users/kevinsanto/Documents/GitHub/Jumperless/Jumperless_Wokwi_Bridge_App/JumperlessWokwiBridge/.conda/lib/python3.12/lib-dynload/zlib.cpython-312-darwin.so

imported by: encodings.zlib_codec • gzip • shutil • tarfile • zipfile
