Architeuthis-Flux/Jumperless/Jumperless_Wokwi_Bridge_App/Old Version Crap/New Folder With Items/pyInstallerscript copy.txt

python -m PyInstaller \
--icon="/Users/kevinsanto/Documents/GitHub/Jumperless/Jumperless_Wokwi_Bridge_App/jumperlesswokwibridge/icon.icns" \
-y \
--console \
--windowed \
--target-arch arm64 \
--path "/Users/kevinsanto/Documents/GitHub/Jumperless/Jumperless_Wokwi_Bridge_App/JumperlessWokwiBridge/.venv/lib/python3.12/site-packages" \
--add-binary "arduino-cli:." \
JumperlessWokwiBridge.py
