Architeuthis-Flux/Jumperless/Jumperless_Wokwi_Bridge_App/Old Version Crap/New Folder With Items/pyInstallerscript.txt

python3 -m PyInstaller \
--icon="/Users/kevinsanto/JumperlessWokwiBridge/icon.icns" \
-y \
--console \
--windowed \
--add-binary "arduino-cli:." \
JumperlessWokwiBridge_cli.py
