Architeuthis-Flux/Jumperless/Hardware/Custom Breadboard/BBclipsNEW/Breadboard clips manufacturing context.jpg

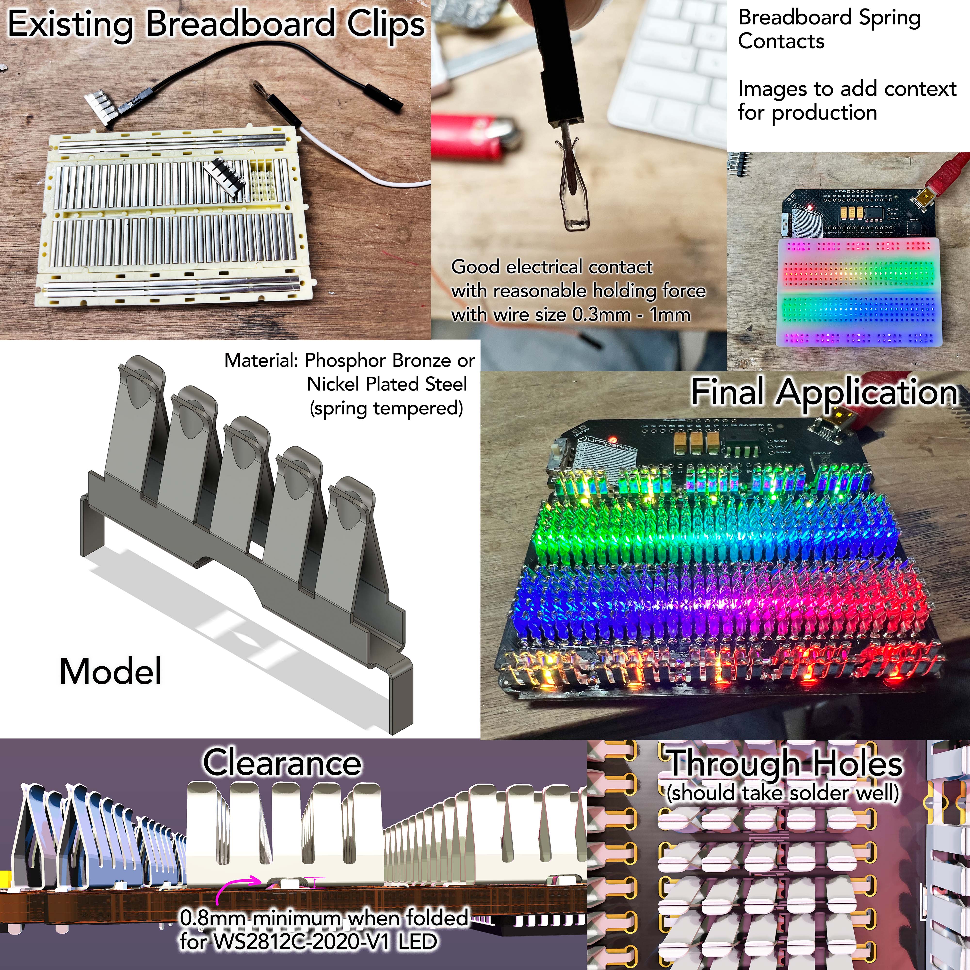
Hardware/Custom Breadboard/BBclipsNEW/Breadboard clips manufacturing context.jpg
