Architeuthis-Flux/Jumperless/Hardware/PCBpictures/Jumperless23177oobuildffddsfffvzdiaingckrdp.png

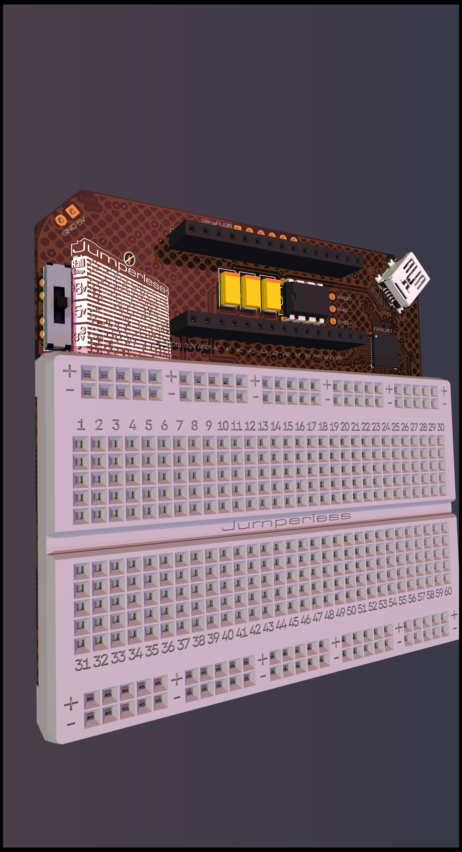
Hardware/PCBpictures/Jumperless23177oobuildffddsfffvzdiaingckrdp.png
