Architeuthis-Flux/Jumperless/Hardware/PCBpictures/Jumperless23177oobuildffsfffvzdiaingckrdp.png

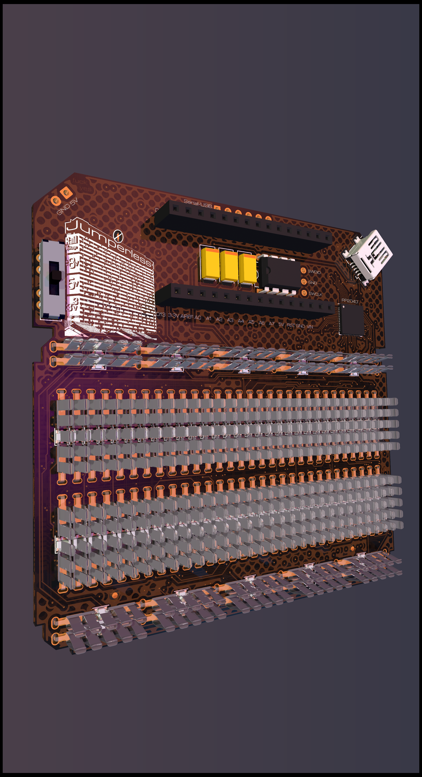
Hardware/PCBpictures/Jumperless23177oobuildffsfffvzdiaingckrdp.png
