Architeuthis-Flux/Jumperless/Hardware/PCBpictures/Jumperless23177oobuildffsvzdiaingckrdp.png

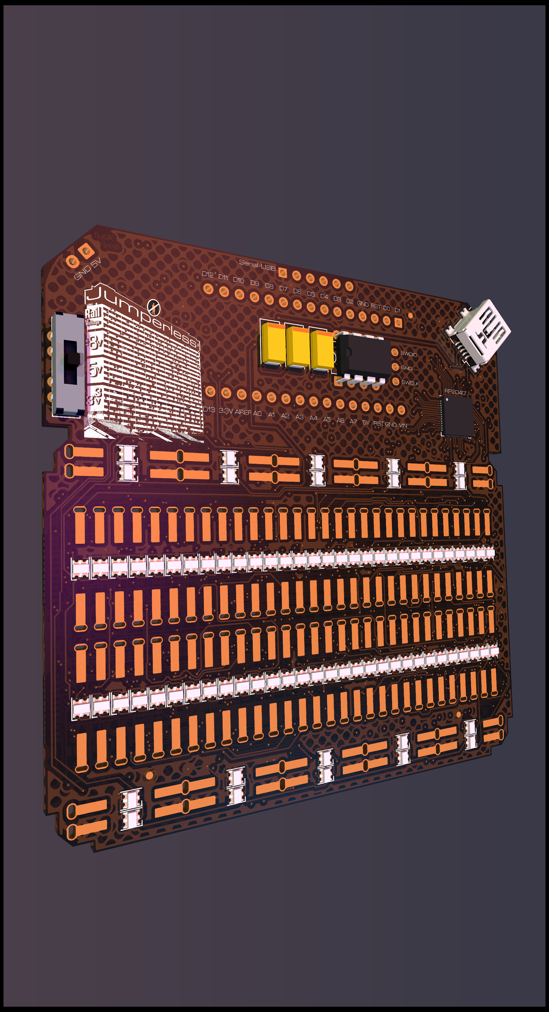
Hardware/PCBpictures/Jumperless23177oobuildffsvzdiaingckrdp.png
