Architeuthis-Flux/Jumperless/Hardware/PCBpictures/Jumperless23177oobuildxxxxffddsfffvzdiaingckrdp.jpeg

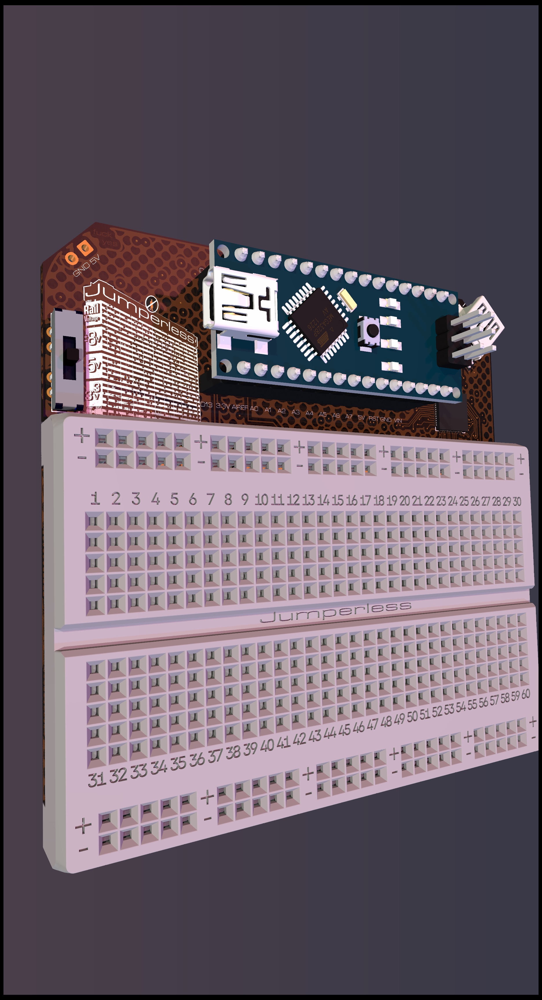
Hardware/PCBpictures/Jumperless23177oobuildxxxxffddsfffvzdiaingckrdp.jpeg
