Architeuthis-Flux/Jumperless/probe guide-2.png

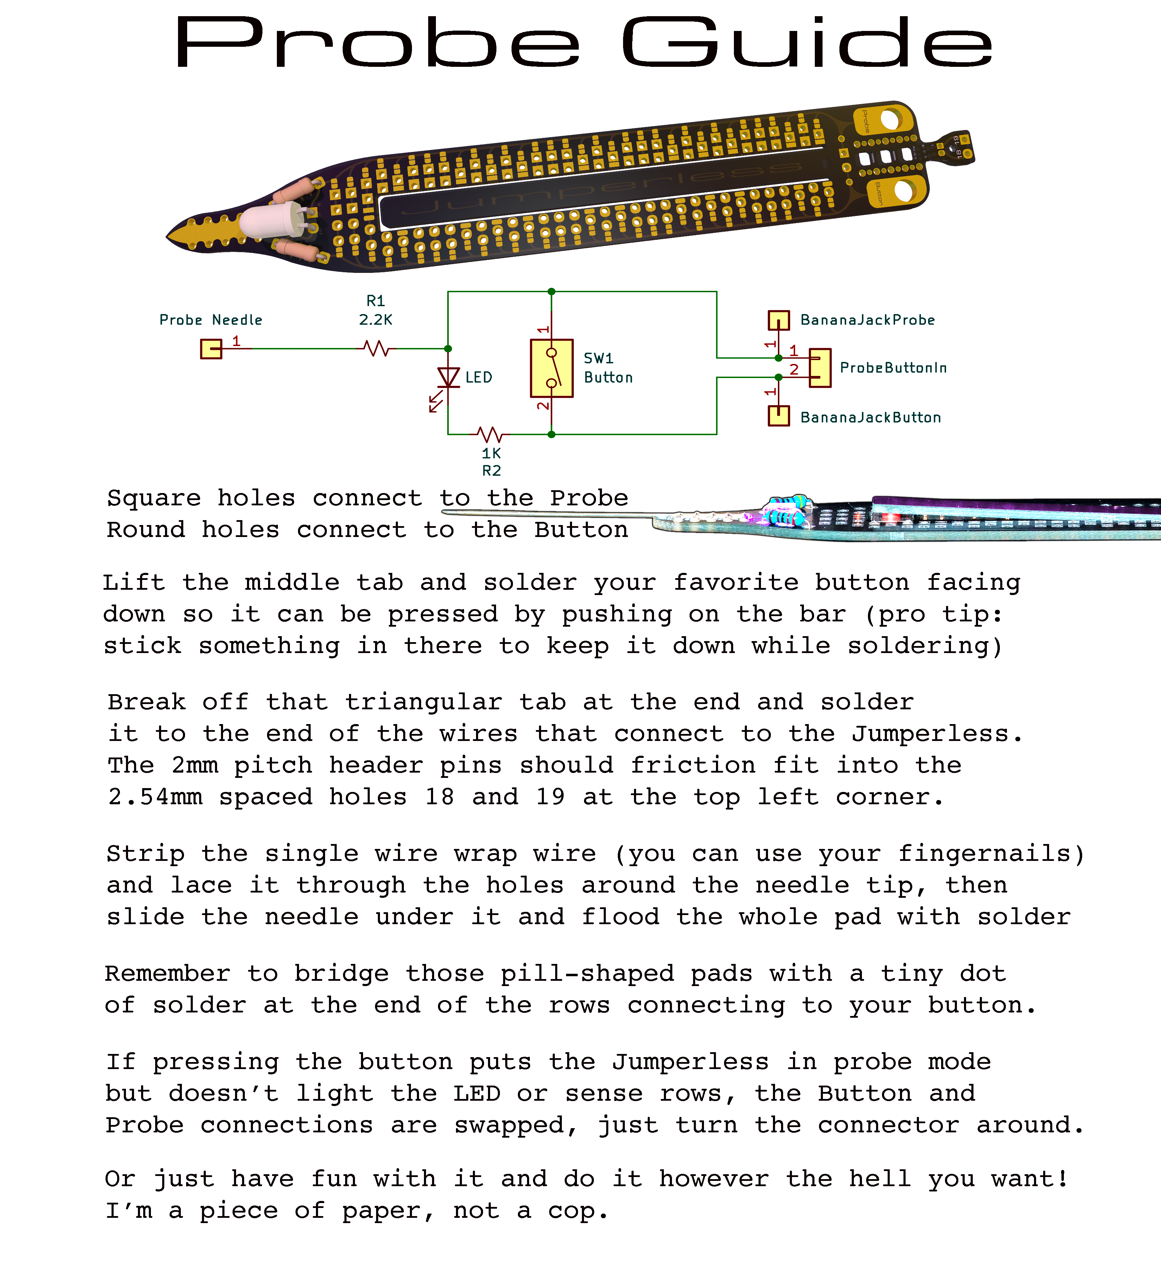
probe guide-2.png
