Architeuthis-Flux/Jumperless/(threads)

Thread 1 (2023-04-01):

Which breadboard?

atlaste, 2023-04-01:
I actually like the idea of having a prototype board that I can use for fast prototypes.

I was wondering what breadboard you're using? They all seem to be made with sticky tape at the bottom which holds the contacts in place, so that makes it impossible to solder them right on to the PCB. Do you peel off the sticky tape with isopropyl?

Architeuthis-Flux, 2023-04-01:
After reading through a lot of heated debates about which breadboard is the best, I settled on the [Jameco Valuepro WBU-301-R](https://www.jameco.com/z/WBU-301-R-Jameco-ValuePro-400-Point-Solderless-Breadboard-3-3-Lx2-1-W_20601.html). They seem to hold up pretty well and have quite a few holes in the bottom to put screws into. I usually put a bit of epoxy in each hole so the threads on the [M1.7 8mm self tapping screws](https://www.amazon.com/Tapping-Phillips-Metric-Assortment-Stainless/dp/B07XHR75SX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) can bite better.

The trick to getting the sticky back off is to get a brand new one, and peel it off as soon as you open it. At the factory they don't really press the tape on very well so if you never put any pressure on it, it peels right off.

If some is left I'll scrape it off with an xacto knife or tweezers dry, I experimented with isopropyl and it just makes a mess and doesn't really get it off. Sandpaper on the bottom of the board works too (I do that anyway right before I apply the [Z tape](https://shop.evilmadscientist.com/productsmenu/831) to make better contact.)

I'll write up a guide for sticking breadboards to PCBs. I've tested a crazy number of different ways but this one seems to work with minimal effort.

atlaste, 2023-04-04:
Yea I didn't quite understand how it was done. Seems like you don't solder the breadboard to the pcb? I'm just not sure how that part fits together. Or is it just screwed down?

I also don't quite understand how the routing itself works while checking the schematics. I have to admit, I'm mainly working on (different) ESP's, and they have roughly 45 pins. Quite a few of these are dedicated to certain tasks, which makes testing even more important. So that means that I would need 3 IC's per 8 pins to route 3x16=48 pins across a "bus" to the microcontroller. With 60 pins that's 8x3=24 IC's. That seems like quite a lot to put on a board.

HasanTheSyrian, 2023-11-06:
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

From what I understand you're using special clips, is that right?

Also, a master BOM that includes all the components in the bom.csv files + the other components like the breadboard would be nice. Maybe I can make one and add it in `/hardware`.

Thread 2 (2023-04-20):

Recommending CH446Q for smaller package

DeqingSun, 2023-04-20:
I just came across this project and I remember datasheet of CH446Q mentioned it was functionally compatible to MT8816AP, although not pin compatible. Hope this is useful information if you want a newer or thinner chip.

Architeuthis-Flux, 2023-05-25:
I've been aware of this chip for a while and was skeptical to try it out. But your comment finally convinced me to give it another look.

I switched microcontrollers to the RP2040 and it doesn't quite have enough IO to do the parallel addressing, but as it turns out, the CH446Q can accept commands over serial too.

And LCSC had them in stock so I can just order them assembled now.

So the new revision uses them, just wanted to say thanks for the suggestion.

Closed 2023-04-22.

Thread 3 (2023-07-02):

TinkerCAD Integration

ericmoderbacher, 2023-07-02:
See if there’s any way to extract any data from TinkerCAD.

ericmoderbacher, 2023-07-02:
@Architeuthis-Flux I didn't realize tinkerCAD was only a website now and not an installable application.

In the attached screen shot of the export options for a given project it seems that we could use either (or both?) .brd files or a project url for getting a circuit from tinkerCAD.

The project url might not work without the user sharing login information with the application or setting up some sort of dummy account.

The .brd file should work but its not as cool as the way you had the python project listen for changes from wokwi.

A third option might be to make a safari or chrome plugin that can send tinker cad projects into the board somehow?

Thread 5 (2023-07-02):

Python seems to not be able to access the programing port or the monitor port if its not manually defined in the project.

ericmoderbacher, 2023-07-02:
If the user comments out:
`upload_port = /dev/cu.usbmodem1101`
`monitor_port = /dev/cu.usbmodem1101`

it seems that the python can not access the automagically picked ports.  So we need to see if there is a way for python to get that for the user also automagically.

Architeuthis-Flux, 2023-07-08:
Now that I've finally learned Python, I was able to fix this by having the extra_scripts.py search the serial ports for anything with "Jumperless" as the device descriptor and setting the upload and monitor ports to that. It also is in the Wokwi Bridge app so you don't need to manually select the port anymore.

So yeah, fixed.

Closed 2023-07-08.

Thread 7 (2023-07-02):

Interface for voltage and current.

ericmoderbacher, 2023-07-02:
Maybe a little gui window to show the measured voltage and current continuously. Does not need to be part of another project or executable.

JamesNewton, 2023-07-03:
I've found graphs of current draw, over the last minute or even 10 seconds or so to be very very helpful. I got that on my latest bench power supply and I'm amazed at how often I use it. It's normally a "wait... what just happened?" sort of a thing, and then I look up and see "oh, something shorted" or "Oh... it's didn't pull any power for a second there, did the load come disconnected?" or things like that. So a little graph, along with the number would be super nice. V2.0 maybe.

ericmoderbacher, 2023-07-04:
@JamesNewton that's great input, as a software guy I don't really know what's useful to include.

Architeuthis-Flux, 2023-07-08:
@JamesNewton good idea, I use that little graph on my power supply all the time. At one point for testing I did it with printing a bunch of periods depending on the reading. But eventually I'm going to need to take the plunge and write a full on GUI. If you have any suggestions for which framework I should use, let me know.

JamesNewton, 2023-07-08:
@Architeuthis-Flux Oh, I have a very strong opinion on this one. HTML / SVG. Always write GUI's for the web. Then use e.g. Phonegap or Node or Electron or whatever to compile it down into a program. Always. Then you have a web interface, and program interfaces for every OS because all the work is done for browsers on every OS. And it's a standard that will never (knock on wood) go away. And... it's pretty easy to use, well documented, lots of tools to help make things easy. And... if you learn it, then you can apply it to building web sites.

Architeuthis-Flux, 2023-07-08:
@JamesNewton thanks for that, now that you say it, it does seem like that's totally the way to go considering that's how Wokwi is written and I'll probably need to include it in any GUI I make for this.

nilclass, 2023-12-04:
GUI aside, is there any way to get to those values currently? I see a [commented out `m` here](https://github.com/Architeuthis-Flux/Jumperless/blob/fb41f849f8834ca682aab47a836ab1fb83718420/JumperlessNano/src/main.cpp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), but it [doesn't do anything](https://github.com/Architeuthis-Flux/Jumperless/blob/fb41f849f8834ca682aab47a836ab1fb83718420/JumperlessNano/src/main.cpp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)

Thread 13 (2023-10-28):

Not getting ground in breadboard

omeriko9, 2023-10-28:
Hey, just got my jumperless and assembled it per instructions, but I can't get GND in any of the breadboard pins except for the ground line.

As you can see, the leds are green signifying Ground, but the led won't turn on:

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

This is my Wokwi diagram but I also trying connecting row 1 to the Nano's GND (and many different rows), it still won't work:

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

When I connect the led directly to the Ground line (or using a jumper wire) I do get ground.

Any idea how can I fix/debug this?

Architeuthis-Flux, 2023-10-28:
Thanks for putting in this issue! I think I may have left some silly change in the code from debugging something else that isn't connecting Net 0 GND, there's a for loop somewhere starting from 1 instead of 0. I'll find it and put up a fix this morning.

Architeuthis-Flux, 2023-10-28:
Could you also let me know if you have Rev 2 or Rev 3? and if it works on any other rows? The 4 corners of the breadboard (row 1, 30, 31, 60) work slightly differently from the rest, so it's helpful to know whether the issue is just there. On my board, it seems to work elsewhere but not in the corners.

omeriko9, 2023-10-28:
Forgive my ignorance, how can I know which revision the board is? Here is the back of the board:
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

Architeuthis-Flux, 2023-10-28:
That's on me for not writing the revision number on the boards, you can tell by the location of the ADC (on Rev 3 it's in place of the Nano Disconnect solder jumpers). You have a Revision 2, which is good because that's all I have to test on right now and I found a fix for you.

Right under the rail supply switch (top right looking at the back) there's a solder jumper that should be cut (if it's not, cut it). Run a jumper from the left side pad to the GND rail. Like this:
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
And you should be able to get GND on the 4 corners.

I'm working on a more robust fix in firmware that will work on both revisions right now, so when I update the release you should update your firmware.

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
The reason for this is the corners are considered a Special Function on Chip L and the pathfinding has to deal with them differently. It's kinda weird but it saved me from having to add another crosspoint switch to the board.

Architeuthis-Flux, 2023-10-28:
Let me know if that works for you.

omeriko9, 2023-10-28:
I will try and let you know, thanks for the elaborate explanation and the care you invest in this issue!

Architeuthis-Flux, 2023-10-28:
Hey, the bug should be fixed in the latest release. Just download firmware.uf2 from the releases page and it should work better. Still do the bodge though, it assumes you've done it. I'll keep hacking away to get it to work without the bodge, so I'll keep this open until that's fully done.

omeriko9, 2023-10-29:
Yes, the patch + latest firmware indeed fixed it, now I get GND on the edge rows. Nice :)

There's another issue where Wokwi + JumperlessWokwiBridge won't update the sketch on the Nano, do you want me to open a different issue for that or are you aware of that already?

Architeuthis-Flux, 2023-10-29:
You can open up an issue for that. But as of now, I haven't written the firmware to do that. It turns out it's pretty complex to grab all the libraries and compile everything into a hex file like that. It's completely feasible, just will take some work in a field of coding I'm not super good with.

For now, the best way to flash code is with a second USB cable, the Jumperless will reset the Arduino each time you change the wiring (I can change it if you don't want it to do that, or just cut the two solder jumpers labeled Reset.)

Closed 2023-10-29.

Thread 14 (2023-11-12):

Budget version?

gadgetmies, 2023-11-12:
Would it be possible to create a cheaper option by dropping the RGB leds from the design? Those are really cool, but the $299 price is IMHO a bit steep. I think it would be enough to have one led per row / column to visualise the connections. AFAICT one could then use a cheap protoboard soldered to the PCB and thus not need the custom connectors and protoboard print.

Any thoughts?

Architeuthis-Flux, 2023-11-12:
You'd be surprised at how little removing the LEDs would affect the overall cost. 90% of the BOM cost is the crosspoint switching matrix and the power supplies to drive them. So a super stripped-down version would end up being like $250.

The breadboard footprint on the PCB does have a fallback to solder an off the shelf breadboard to it (if you don't populate the LEDs or cut a channel through the clips), but the amount of heat required to melt solder on the other side of the board causes some serious warping issues. I've done it before, but there's no way I could convince a factory to do that for me.

The only workable way to get the cost down is having fewer points to switch, so an even smaller breadboard.

Or just wait a while for the inevitable impossibly cheap Chinese clones to come out. I'll do my best to have my firmware and stuff support them when they do, because that would take a lot of pressure off me to get these into the hands of everyone who wants them.

Closed 2023-11-12.

Thread 15 (2023-12-04):

CAD files for case?

nilclass, 2023-12-04:
@Architeuthis-Flux: I spotted this neat little case on one of the pictures in the README:
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

Any chance you could share some CAD files for it, so I can print one for myself? I can't find them anywhere..

nilclass, 2023-12-05:
Thanks so much for the quick reply :dash:

I don't have a laser cutter, but I do have a 3d printer, so I'll try to print myself a box (when all you have is a :hammer: ...)

It will probably turn out horrible, given the amount of tiny features in the hair of the logo. Anyway, will give it a try :see_no_evil: .

The SVG you shared is a bit tricky to work with, since it has a lot of unconnected path segments. I tried to clean those up a bit, to get a shape that has a clearly defined "inside" and "outside" (which is required to turn it into a 3d model).

This is the result of that:
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

Architeuthis-Flux, 2023-12-15:
Hey, so I just got a bunch of cases in, and I already have your address so I'm gonna send you one. But it would be super cool to have a version of this case that is better suited to FDM so people can 3D print them at home.

Here's the STL for the whole Jumperless so you have a shape to design around. The Nano headers didn't make it in there but they stick up exactly as high as the breadboard.

[Jumperless.stl.zip](https://github.com/Architeuthis-Flux/Jumperless/files/13679454/Jumperless.stl.zip)

Architeuthis-Flux, 2023-12-17:
@nilclass Hey, your case has been sent out, it should be there sometime this week. Also, someone on the forums made a 3D printable stand (not really a case but it could be useful) as well.

[1ZE15D330435626163](http://wwwapps.ups.com/WebTracking/processInputRequest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)

[https://forum.jumperless.org/t/3d-printed-stand/57/3](https://forum.jumperless.org/t/3d-printed-stand/57/3)

nilclass, 2023-12-20:
@Architeuthis-Flux the case arrived, thanks so much, it's beautiful!

The stand looks useful too - not sure about it's height, but maybe I'll just cut off the bottom part before printing... I'll follow up on the forum :)

Closed 2023-12-15.

Thread 16 (2023-12-15):

"b" macros in JumperlessDefines conflict with variable names in TinyUSB library

dupontgu, 2023-12-15:
When I load in the JumperlessNano project via platformio, the build seems to fail because the pin #defines in `JumperlessDefinesRP2040`:
```c++
#define b1 31
#define b2 32
#define b3 33
// ...
```

conflict with parameter names in a utility function in `tusb_common.h` (from the TinyUSB library):
```c++
TU_ATTR_ALWAYS_INLINE static inline uint32_t tu_u32(uint8_t b3, uint8_t b2, uint8_t b1, uint8_t b0)
{
  return ( ((uint32_t) b3) << 24) | ( ((uint32_t) b2) << 16) | ( ((uint32_t) b1) << 8) | b0;
}
```

I've attached the full error output - this may be due to a configuration issue on my end? No idea. But I pulled fresh and this was the first issue I saw.

## Workaroud:

I simply renamed the parameters in the tusb util function since it was quicker than changing the macro.
```c++
TU_ATTR_ALWAYS_INLINE static inline uint32_t tu_u32(uint8_t byte3, uint8_t byte2, uint8_t byte1, uint8_t bbyte0)
{
  return ( ((uint32_t) byte3) << 24) | ( ((uint32_t) byte2) << 16) | ( ((uint32_t) byte1) << 8) | byte0;
}
```
This project is incredible and I am having so much fun!!!

[jumperless_err.txt](https://github.com/Architeuthis-Flux/Jumperless/files/13679610/jumperless_err.txt)

Architeuthis-Flux, 2023-12-15:
Ha, I did that exact same workaround (I even picked the same names) and forgot to make it so other people wouldn't have to do it too.

I just need to decide whether to put the revised library in the source or change the defines. Any thoughts?

dupontgu, 2023-12-15:
Though it's a bit more effort, I would probably change the defines. If you embed the lib, will cost ya time down the road if you ever wanna update. And fwiw I think most c++ styleguides recommend ALL_CAPS_AND_UNDERSCORE case for macros.

Architeuthis-Flux, 2023-12-15:
Cool, turns out those defines were only used in one other file, MatrixStateRP2040.cpp, so I just changed them to follow the style guide as you suggested. Now they're TOP_1 and BOTTOM_1 instead of t1 and b1.
Thanks for catching that!

Closed 2023-12-15.

Thread 17 (2023-12-26):

Getting a real USB vid/pid?

nilclass, 2023-12-26:
[Currently advertised USB IDs](https://github.com/Architeuthis-Flux/Jumperless/blob/bc217504b3e6a6739e501674906257f57e9cd681/JumperlessNano/src/main.cpp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) are fantasy values I assume :wink:

The openmoko project has a proper Vendor ID and is handing out Product IDs to open source projects. The process is described here: http://wiki.openmoko.org/wiki/USB_Product_IDs - Pretty sure Jumperless meets the requirements!

Architeuthis-Flux, 2023-12-26:
Oh good call, I just submitted [a pull request](https://github.com/pidcodes/pidcodes.github.com/pull/911) on pid.codes for their VID 0x1209 and my PID 0xACAB

I honestly can't believe that PID was available, ha.

Closed 2024-04-05.

Thread 20 (2024-01-02):

Crosspoint Switch Logic

vinilsaji2003, 2024-01-02:
I would like to understand the logic behind the crosspoint switch,if we are using an 8*16 crosspoint switch array,then only 8 distinct connections can be made simultaneously-right,if we want more connections then nodes would be merged and the signals might get mixed up.How did you overcome this logical problem,I mean only 8 connections can be made simultaneously,but what if we need more connections from the same chip that might merge two or more nodes leading to signal mixing

Architeuthis-Flux, 2024-01-02:
Yeah that is by far the most complicated part of this whole project. I wrote a project log with some explanation on [Hackaday](https://hackaday.io/project/191238-jumperless/log/222530-the-code-part-2-pathfinding), but even that really isn't enough to explain exactly what's going on.

But basically, the crosspoints have 7 of their inputs connected to a some rows on the breadboard, and the remaining 17 connections are connected to the other 11 chips on the board (some have 2 going to the same chip). If it wants to make a connection to somewhere and the line is already being used for another connection, it looks for an intermediary chip that has an unused connection to both of the chips that want to be connected, and "hops" to where it needs to go through another chip.

It stores what connections are made and what's available so it knows not to merge things that shouldn't be. Those are defined in [JumperlessNano/src/MatrixStateRP2040.cpp](https://github.com/Architeuthis-Flux/Jumperless/blob/main/JumperlessNano/src/MatrixStateRP2040.cpp) if you want to have a look at the state, the nitty gritty logic of the pathfinding, you can check that out in [JumperlessNano/src/NetsToChipConnections.cpp](https://github.com/Architeuthis-Flux/Jumperless/blob/main/JumperlessNano/src/NetsToChipConnections.cpp).

If you want to see what's going on step-by-step, you can load this firmware onto a Raspberry Pi Pico and turn the Nets To Chip Connections debug flags on and it will give you a huge wall of data showing what's going on as it happens.

TL;DR It's complex as hell but it does work.

vinilsaji2003, 2024-01-02:
We are electronics engineering students and we would like to implement this project on our own to gain an experience in various domains involved in the project,our idea was to just implement the breadboard only,we had this idea going on in our head for the past 1.5 years,we use breadboards in our laboratories and at times it seemed very hard to connect with all the jumper wires and it was complex to troubleshoot,we had this idea of connecting each pin separately but it would need atleast 1770 connections as it stands,fortunately we found you,Though we were aware of the crosspoint switch ic's we are amused by how you have used it,would you be kind enough to tell us where we should go from hereon to implement this logic with deep understanding

Architeuthis-Flux, 2024-01-02:
Awesome, that sounds like a fun project. I would probably start with reading all the stuff on [breadWare](https://github.com/Architeuthis-Flux/breadWare), it's my earlier prototype for this and should be a bit simpler to follow. And It shows my thinking for a lot of the decisions I made on Jumperless.

Some tips I could give you is not to try to do a full size breadboard at first, the number of connections and chips needed goes up really quickly, and 8x16 crosspoints just aren't big enough to handle that without even more tricks than I use here.

Also, don't try to model a larger "fully connected" crossbar (like every switch has 8 connections to every other switch), you're better off making some assumptions about what people will realistically make on a breadboard and using fewer chips.

Read up on [Telephone Exchanges](https://en.wikipedia.org/wiki/Telephone_exchange). Because that's basically what's going on with this, all the same ideas apply (the only difference is that you also want to minimize the number of switches a signal goes through because of the on resistance.) There are tons of really good papers from Bell Labs from the 60's, and just going on a Wikipedia rabbit-hole on these will help a lot. Start here and then go to the See Also section.
[Nonblocking Minimal Spanning Switch](https://en.wikipedia.org/wiki/Nonblocking_minimal_spanning_switch)
[Switching Circuit Theory](https://en.wikipedia.org/wiki/Switching_circuit_theory)

vinilsaji2003, 2024-01-02:
Thank you for replying,we are very grateful,we look forward to further mentorship from you

vinilsaji2003, 2024-01-05:
Could you please tell us in how many stages  you have implemented the clos network logic,is it 8 ic's for the first stage and then 4 for the upcoming stages,would we be able to make use of more connections if we implement it in more stages

Architeuthis-Flux, 2024-01-05:
I didn't really strictly implement any particular topology for this, but it's basically a 2 stage (just input and output layers) that can fall back to 3 stage if the 2 available paths are taken. The reason it had to be so different from those topologies is because in this case, the most important thing to worry about is the resistance of the switches themselves (~45 ohms each).

The 4 special function chips are basically the same idea, except that they're wired "backwards" (16 pins to the outside world, 8 to the rest of the chips)

So, you absolutely can do one with more stages to get more nodes, just keep in mind that every switch you go through adds another 45 ohms.

Another trick I'm using to reduce the switch resistance is to power them with a lot more voltage than the datasheet writes as the maximum. Datasheet says Vdd - Vss is max 14.2V (which gives 65ohms on resistance, and I'm running them at Vdd - Vss ~18.5V to get that down to 45 ohms.
I should test how much further I can push it, but so far, it works totally fine.

vinilsaji2003, 2024-01-05:
Ok,thankyou for sharing that vital piece of information

vinilsaji2003, 2024-01-05:
Sir,we have understood the logic used,thanks to your explanation,but when it comes to the schematic understanding of this project,it seems too complex to understand.so we would like to implement a miniature version of breadboard with may be only 5 or 10 columns,Would you be generous to give us any suggestions on how the connections should be made easily.one more doubt sir,when we try to implement only the breadboard without actually trying to import a nano into it would we require the control routing crosspoint switch ic's,forgive me if there is any misunderstanding,but i have found out that only the connections AB0,AB1,AC0,AC1.... etc are directly linked to the breadboard columns(am i right),i assume the rest were made to connect the nano in any configuration possible,Would i be bothering you if you could help us with a schematic when we want to make a breadboard with only 10 columns and without a nano connection just so as to ensure that our understanding is fully correct,as we are devoid of a lot of equipments and moral support from our college we are just keen to make sure that we dont make a lot of mistakes,also have you used any algorithm to connect AB0,AB1,AC0,AC1.....etc because they all seem to follow a specific pattern from chip to chip

vinilsaji2003, 2024-01-05:
Also could you explain how many columns from the breadboard is connected to AB0 alone,is it two, because there seems to be 28 AB0,AB1 .....etc like connections with an alternative path to another chip

Architeuthis-Flux, 2024-01-05:
The AB0 AB1... connections aren't connected anywhere externally, they're just connections between the chips, for example AB0 connects chip A to Chip B (lane 0). The connections that go to the breadboard columns are labeled as just numbers.

Anyway, here's a much simpler schematic for 24 rows. It's fully interconnected so everything can connect to everything else without worrying about collisions, which should make the code much simpler. The 3 CH446Qs are controlled in parallel mode with an external microcontroller. So just put a header on the PCB and set the X0-X3 and Y0-Y2 for the address and then strobe the CS_A B or C high to make a connection.
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

If you don't want to mess with the power supply, you can leave it out and power it externally with either a bipolar bench supply or 2 9V batteries (look up how they do that with guitar pedals).

[SimplifiedMatrix.zip](https://github.com/Architeuthis-Flux/Jumperless/files/13847211/SimplifiedMatrix.zip)

vinilsaji2003, 2024-01-06:
Is the above shown schematic the same you have used with v0.0.0.2,

Architeuthis-Flux, 2024-01-06:
Not really, I just wired that up for you just now. But it's probably sort of similar.

vinilsaji2003, 2024-01-06:
Thankyou for your effort,by any chance do you have the schematic of v0.0.0.2,it is not present in 'breadWare',Sorry to bother you again

vinilsaji2003, 2024-01-06:
By my understanding of v0.0.0.2 we select the chips also,so we should make sure that no interconnections have been made,is that right

Architeuthis-Flux, 2024-01-06:
No, I just did one that in my head, but you can change the schematic I sent by putting the numbered labels on the side with 16 connections and the AB0-7 on the side with 8 (Y0-7).

And here's the [datasheet for the CH446Q](https://www.wch-ic.com/downloads/CH446DS1_PDF.html) which will explain the Chip Select

vinilsaji2003, 2024-01-06:
I mean we have to give the instructions to the microcontroller to switch between chips a and b by ensuring that no interconnections will be made

vinilsaji2003, 2024-01-06:
Also sir,how did you start with using KiCad

vinilsaji2003, 2024-01-07:
Sir, in our main schematic from jumperless , if we need to connect row 2 of breadboard to row 3,we need to connect y1 to y2,but if we need to do that we should connect y1 to any point from x0...x15 and then connect that point to y2, wouldn't that mean that we are actually making use of point from x0-x15 that we might need to connect between chips in the future or is that how we approach it-- do we use a point which is less likely to be used in the future, like we might be able to use x15 since it is less likely that we connect a point from chip a to chip h, But does it not leave us with one pathway less for inter-chip connections, should we use one more chip for all the intra chip connections

Architeuthis-Flux, 2024-01-07:
Yes, how that's dealt with in Jumperless's code is that it sets those X lines to -2, which signifies "I don't care which line", then when it's finished routing everything else, it goes through and sets them to the next available line. That way it doesn't interfere with a connection it needs to make.

And when you add a single connection on the Jumperless, it clears all the paths and recalculates every path again. It helps a lot to not have to worry about what was connected and disconnected previously.

vinilsaji2003, 2024-01-07:
Thankyou

vinilsaji2003, 2024-01-07:
Is there a source from which i can download your footprint libraries----JumperlessFootprints:LQFP44_Tight
                                                                                                                   JumperlessFootprints:DIP-8_W7.62mm

Architeuthis-Flux, 2024-01-07:
Just use the standard LQFP44 footprint, it will be much easier to solder, I just had to make mine smaller so they'd fit on a really dense board. Same thing with the DIP-8, that's the standard size you'd find anywhere.

Closed 2024-04-05.

Thread 23 (2024-01-07):

Wokwi Bridge (Silicon) failure at decoder.py

jknudstrup, 2024-01-07:
I have tried to run the bridge on two different silicon Macs and both crash on the same error:

```
Running project Foo

Do you want to enable Auto-flashing the Arduino from Wokwi? y/n

y

Save your Wokwi project to update the Jumperless

Enter 'menu' for Bridge App menu

Traceback (most recent call last):
  File "JumperlessWokwiBridge.py", line 743, in <module>
  File "json/__init__.py", line 346, in loads
  File "json/decoder.py", line 337, in decode
  File "json/decoder.py", line 355, in raw_decode
json.decoder.JSONDecodeError: Expecting value: line 1 column 1 (char 0)
[18018] Failed to execute script 'JumperlessWokwiBridge' due to unhandled exception: Expecting value: line 1 column 1 (char 0)
[18018] Traceback:
Traceback (most recent call last):
  File "JumperlessWokwiBridge.py", line 743, in <module>
  File "json/__init__.py", line 346, in loads
  File "json/decoder.py", line 337, in decode
  File "json/decoder.py", line 355, in raw_decode
json.decoder.JSONDecodeError: Expecting value: line 1 column 1 (char 0)

Saving session...completed.

[Process completed]

```

jknudstrup, 2024-01-07:
This is on the latest app, flashed with the latest firmware

Architeuthis-Flux, 2024-01-07:
Huh, I'll look into that and get it figured out.
In the meantime, could you run

`pip3 list`

in Terminal and paste what it returns.

Architeuthis-Flux, 2024-01-07:
Ah shit, Wokwi added a README.md to their projects, which moved the index where the diagram.json is stored. I'll come up with a more robust fix tomorrow (where it will work with both old and new projects) but for now, let me know if this works.

[JumperlessWokwiBridgeAppleSiliconTempFix.zip](https://github.com/Architeuthis-Flux/Jumperless/files/13852264/JumperlessWokwiBridgeAppleSiliconTempFix.zip)

The guy who makes Wokwi even warned me about this when I first made this app, so it's totally on me for not actually searching for the right field and just assuming it would be the second one.

Architeuthis-Flux, 2024-01-07:
Hey, here's a more robust version.
[JumperlessWokwiBridgeAppleSilicon.zip](https://github.com/Architeuthis-Flux/Jumperless/files/13854323/JumperlessWokwiBridgeAppleSilicon.zip)

Let me know if that works, I packaged it differently to allow me to sign it with apple.

jknudstrup, 2024-01-07:
They both work 👍 though the robustified version still requires manual approval in Privacy & Security (though that might just be a me problem)

Architeuthis-Flux, 2024-01-07:
Ah well, it was worth a shot at signing, I'll try again next time something breaks. The problem is that I've included the entire arduino-cli into the app, so who knows how it handles that.

Thanks for opening the issue and also confirming that it works.

Closed 2024-01-07.

Thread 25 (2024-01-12):

Alternative ways to configure the board without Wokwi?

rdragonrydr, 2024-01-12:
So I've got absolutely no right to ask, but I'm a little uncomfortable using a web application as part of my development chain, let alone one that I can't seem to find full source code for (I was able to find some for their ancillary systems but not wokwi core. Maybe I'm wrong though).

Is there currently any way to use Jumperless direct from the bridge/desktop app, or plans to add that? I'm alright doing something like telling it to connect these two rows on the breadboard and repeat for N, I don't really need a full GUI or a Fritzing/KiCad clone or interface (though that would be nice).

I would try to do it myself but I've been suffering from burnout and was ironically looking into this in hopes it would get me back into designing circuits and programming stuff.

Architeuthis-Flux, 2024-01-12:
You totally have a right to ask, and you're in luck.

There are a few ways you could do this. Listed from simple to powerful.
## Just a straight up text file pasted in
The most stupidly basic way would just keep a text document with a list of connections preceded by 'f ' and just paste it into the window. You'll still need to give it a random Wokwi link to get the app started, but each time you paste a netlist it will clear any previous netlist.

For example,
`f 1-2,GND-5,DAC0-35, A0-50, d1-56, D0-55, 15-20, +5V-25,`
Will give you
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
It's pretty loose with what it accepts, just make sure the last bridge ends with a comma. Here's a list that shows what it will accept for the special functions
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

## jlctl

@nilclass has been working on [jlctl](https://github.com/nilclass/jlctl/tree/develop), which is an open source text based UI written in Rust. Which is super helpful for keeping track of your netlist and sending it to the Jumperless among other things.

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
This is can also start a local server to be used with...

## Jumperlab

Another awesome bit of software from @nilclass, Jumperlab is a GUI for the Jumperless written in Node.js and stuff. Yeah it runs in a browser because we're in the future and everything does but it's still running completely locally on your machine. It's a work-in-progress but it's coming along super quickly. And it's pretty damn close to being useable as of today.
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

I hope this can get some anti-burnout juices flowing in you!

Closed 2024-04-05.

Thread 29 (2024-02-17):

Bug: In probe mode, selecting the 5v Nano pin connects to the 3v supply, not the 5v supply.

AdamSLevy, 2024-02-17:
Firmware: 1.3.3

steps:

1. enter probe mode either via the bridge app or connecting pin 19 and 18.
2. probe the 5v pin on the nano header, note that the bridge app will report that you have selected 3v.
3. probe another rail to connect it to what should be the nano's 5v output pin, but is 3v..
4. commit the connection (connect pins 18/19)
5. a volt meter will confirm that the connected rail has 3v, not 5v.

This behavior does not appear to be affected by the position of the voltage level switch.

Architeuthis-Flux, 2024-02-17:
That _was_ intended behavior, because a digitalRead has no way of distinguishing 5V from 3V. But now that I'm using the ADCs to scan the board I can totally measure the analog voltage and do that. Thanks for the idea, I'll put it in the next release.

Closed 2024-04-05.

Thread 30 (2024-02-17):

In probe mode, apparently removed connections persist after committing

AdamSLevy, 2024-02-17:
In probe mode, connections can be "removed" by repeatedly probing the connected rails in sequence two times, which causes the LEDs for those rails to turn off. However the rails remain connected and their LEDs turn back on after committing the changes.

It's not clear if removing connections is supported or if the LED turning off is itself a bug.

It would be very useful to be able to remove connections or discard changes and exit probe mode without committing.

Architeuthis-Flux, 2024-02-17:
Good call, I'll make a function to remove nodes from the stored nodefile. Now that there's a long press function for the probe button, maybe a long press would put you in delete connections mode or something?

Let me know what would seem intuitive to you.

Architeuthis-Flux, 2024-02-19:
Hey this should be fixed in the latest release, 1.3.5. Feel free to reopen the issue if it's still not working.

Closed 2024-02-19.

Thread 31 (2024-06-19):

Different sizes.

wts42, 2024-06-19:
Ever thought about making bigger versions? Would clean up many Z80 & homebrew computer projects. :)

Architeuthis-Flux, 2024-06-19:
I've considered it. But the issue is that the cost and complexity kind of goes up exponentially, even for just a full size breadboard. With 8x16 crosspoint switches, I'd need another ["layer"](https://en.wikipedia.org/wiki/Clos_network) to be able to have connections to every other switch.

The way around it is that the [Jumperless V5](https://github.com/Architeuthis-Flux/JumperlessV5) has a daisy chain header on either side, so you can stick as many as you want together and route 8 analog signals (and SPI + power) between them.

A kinda cool consequence of how it's set up is that those daisy chain lines are shared with 8 GPIO (you remove some 0ohm resistor networks to disconnect GPIO so they can be +-8V tolerant). So you can simulate the outputs from another Jumperless until you get the next one set up and connect them.

Thread 32 (2024-06-25):

SSL Exception

Toube94, 2024-06-25:
When i try to open Jumperless.exe i recieve the following error:

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

I try to use the software for the board on a win pc.
The error only appears if i connected with the company network which is using a firewall. If i use a mobile hotspot the software works as expected

Architeuthis-Flux, 2024-06-25:
Oh that's interesting, thanks for posting the traceback!

I may have already fixed that issue by adding this line:
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

But I'm not actually sure if the Windows version of the packaged has that change included or not. So that could either be the problem or the fix. Schrödinger's bug.

I get back from Portland tonight so I'll have access to a PC and can package the .exe and you can let me know if that fixes things.

If you happen to have some spare time behind the firewall, it would give me a head start if you ran the Python script from [Releases](https://github.com/Architeuthis-Flux/Jumperless/releases/latest) and let me know if the same thing happens with and without that line commented out. But it's not a big deal either way, I'll mess with it until I get something that works, after I figure out how to set up a firewall and a dummy company network, ha.

Toube94, 2024-06-26:
When i run the .py file then i recieve the following error:
`Traceback (most recent call last):
  File "...\JumperlessWokwiBridge.py", line 6, in <module>
    from bs4 import BeautifulSoup
ModuleNotFoundError: No module named '`

Architeuthis-Flux, 2024-06-26:
That particular issue comes from not having the required modules installed. The requirements.txt file in the release should list all the modules needed to run it. In a way that can be read by whatever Python interpreter you're using, or just do >> `pip install beautifulsoup4` and then do that for the next "no module found" error that comes up. But I will not subject you to the nightmare that is Python's dependency management / pip. I wouldn't wish having to navigate that mess on my worst enemy. Thanks for giving it a shot though.

I just got home a couple hours ago so I can look into this tomorrow morning and hopefully push a fix either tomorrow or the next day. I hope your hotspot data can hold out until then.

Toube94, 2024-07-01:
Have you already been able to locate the error?

Architeuthis-Flux, 2024-07-01:
Hey @Toube94, so I've repackaged the windows app with some fixes. It's now in the [latest releases](https://github.com/Architeuthis-Flux/Jumperless/releases/latest)

Since I can't really reproduce your exact company firewall setup, I'm relying on you to let me know whether or not this works. If not I'll keep trying stuff until we get this working.

Toube94, 2024-07-02:
I still recieve ssl fail :(
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

Architeuthis-Flux, 2024-07-02:
Thanks again for the traceback, it's very helpful.

It looks like everything is doing what it's supposed to do, I just need to sign this app properly to appease the firewall. I'll get on that today.

And yeah it will work fine without internet, all those menus are just being spit out from the Jumperless itself as ASCII text. Just use any Terminal Emulator, like [PuTTY](https://www.putty.org/), [coolterm](https://freeware.the-meiers.org/), [RealTerm](https://learn.sparkfun.com/tutorials/terminal-basics/real-term-windows) or whatever. There should also be a built-in command for that in PowerShell or Command Prompt to do that, (I only know on macOS and maybe Linux it's >>screen, but it will be different on Windows).

Toube94, 2024-07-08:
Maybe I misunderstood you in your last comment, but I tried to open Jumperless.exe without internet and I still get an error.

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

Architeuthis-Flux, 2024-07-08:
Okay, I've reworked the app to check whether you're connected to the internet sooner so it won't try to connect to Wokwi and crash.
Just grab the app again from the [latest release](https://github.com/Architeuthis-Flux/Jumperless/releases/latest) and let me know if that works for you.

Toube94, 2024-07-10:
it works now. Thank you so much. Now I can also start the program without a hotspot because it simply does not recognize an Internet connection due to the SSL exception :)

Last question:
is it possible to communicate without jumperless.exe to the board? For example serial console or something like that

Architeuthis-Flux, 2024-07-10:
Awesome.

Yeah it will work with any serial console. With the internet off, Jumperless.exe is literally just doing that. I use the one built into VScode a lot while I'm writing code.

> And yeah it will work fine without internet, all those menus are just being spit out from the Jumperless itself as ASCII text. Just use any Terminal Emulator, like [PuTTY](https://www.putty.org/), [coolterm](https://freeware.the-meiers.org/), [RealTerm](https://learn.sparkfun.com/tutorials/terminal-basics/real-term-windows) or whatever. There should also be a built-in command for that in PowerShell or Command Prompt to do that, (I only know on macOS and maybe Linux it's >>screen, but it will be different on Windows).

Closed 2024-09-21.

Thread 33 (2024-07-02):

Arduino Nano ESP32 netlist generation problem

fpetzold, 2024-07-02:
I am relying to connect a TFT display to an Arduino Nano ESP32 board on the Jumperless. Ir works fine when I (wrongly) select an ordinary Arduino Nano as the controller in Wokwi but one connection does not get generated in the setlist if I use the board-arduino-nano-esp32.

Working project: [https://wokwi.com/projects/401031345191044097](https://wokwi.com/projects/401031345191044097)
Failing project: [https://wokwi.com/projects/400405843811118081](https://wokwi.com/projects/400405843811118081)

Working netlist:

```
netlist (Working, arduino)

Index	Name		Number	Color		Nodes
0	Empty Net	127	0x0		EMPTY_NET		{0-0}
1	GND		1	0x1C00		GND,14			{14-GND}
2	+5V		2	0x1C0702	5V,8,15			{5V-8,15-5V}
3	+3.3V		3	0x1C0107	3V3			{0-0}
4	DAC 0		4	0x231111	DAC_0			{0-0}
5	DAC 1		5	0x230913	DAC_1			{0-0}
6	I Sense +	6	0x232323	I_POS			{0-0}
7	I Sense -	7	0x232323	I_NEG			{0-0}

Index	Name		Number	Color		Nodes
8	Net 8		8	0x201B00	D13,9			{D13-9}
9	Net 9		9	0x102000	D11,10			{D11-10}
10	Net 10		10	0x2013		13,D8			{13-D8}
11	Net 11		11	0x1520		12,D9			{12-D9}
12	Net 12		12	0x20		11,D10			{11-D10}
```

Failing netlist:
```
netlist (failing, ESP32)

Index	Name		Number	Color		Nodes
0	Empty Net	127	0x0		EMPTY_NET		{0-0}
1	GND		1	0x1C00		GND,8,14		{8-GND,14-GND}
2	+5V		2	0x1C0702	5V,15			{15-5V}
3	+3.3V		3	0x1C0107	3V3			{0-0}
4	DAC 0		4	0x231111	DAC_0			{0-0}
5	DAC 1		5	0x230913	DAC_1			{0-0}
6	I Sense +	6	0x232323	I_POS			{0-0}
7	I Sense -	7	0x232323	I_NEG			{0-0}

Index	Name		Number	Color		Nodes
8	Net 8		8	0x201B00	9,D13			{9-D13}
9	Net 9		9	0x102000	10,D11			{10-D11}
10	Net 10		10	0x2013		11,D10			{11-D10}
11	Net 11		11	0x1520		12,D9			{12-D9}
12	Net 12		12	0x20		13,D8			{13-D8}
```

Note the difference in index 2, the 5V is also connected to "8" in the Arduino case.

I had a look at the python code but could not figure out where the additional connection for 5V is coming from. I suppose this connection is the one that makes the difference.

Architeuthis-Flux, 2024-07-02:
It looks like you misplaced one of the jumpers in Wokwi:

Working project:
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

Non working project:
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

Let me know if that fixes it.

fpetzold, 2024-07-02:
I feel extremely stupid now... Yes, that fixed it.

Architeuthis-Flux, 2024-07-02:
Don't feel bad, I've spent hours trying to fix what I thought was a routing bug that ended up being exactly this.

Closed 2024-07-02.

Thread 34 (2024-07-10):

Jumperless Gets Hot

burnt-past, 2024-07-10:
During operation, the CH446Q chips located on the rear side of the PCB become heated to temperatures exceeding 200°F. As they reach this temperature, the outputs appear to cease functioning correctly. Initially, the grounding (GND) and power (VCC) connections are affected, followed by interruptions in pin-to-pin connectivity.

Architeuthis-Flux, 2024-07-10:
Yeah that shouldn't be happening. First, let me know your name so I can ship you out a fresh one and parts to fix the old one.

It might not be permanently damaged so let's do some troubleshooting.

- Was there external power applied somewhere on the breadboard before you plugged it in? Or just send a pic of your setup.

- Is one particular chip much hotter than the others?

- Roughly when was the firmware last updated?

- With the Rail Selection Switch at the top (+-8V) what voltage do the rails read when it's first plugged in? If it's connected through a USB hub, does that change when you use something else to power it (like USB charger plugged into the wall)?

I'll try to think of more possible causes. But these should get us started in the right direction.

burnt-past, 2024-07-10:
Hey!

My name is Alex Woolum. But I ordered the jumperless through JLC at the time since you didn't have stock in your shop a awhile ago. I've always noticed it getting hot since I've had it though.

There was an external power supply attached to the jumperless in this instance. But I turned it off during power cycles of the jumperless. I was using optocouplers with an isolated power supply.

At Boot the rails are defaulting to 3.3 volts even with the switch in the 5 volt position.

I'm on the most current firmware.

Thanks for being so prompt on your response!

Architeuthis-Flux, 2024-07-10:
Oh hey Alex,

That almost sounds like some part on the order was flipped, maybe even the Rail Supply Switch. JLCPCB has a tendency to just randomly rotate components. Someone in the Discord ordered 10 and even after rotating the parts correctly in the order, JLC flipped all the LEDs. So brutal.

From the time you ordered the clips, you have a Rev 2 with the old style clips, so it's possible something in the firmware is messing with it. My first thought is that I might have broke the code that sets the DACs to 0V at startup, and that's drawing too much current from the +-9V supply so it's sagging to a lower voltage and possibly causing this.

Anyway, have you moved since October? It's killing me to have people using my less-polished work, so I'm going to send you a fresh Rev 3 and then you can compare the orientations of the parts and make sure they're the same (or just use that and put the Rev 2 in a drawer, ha.)

If you want, send me close up photos of the front and back of the board and I might be able to spot the issue.

Architeuthis-Flux, 2024-07-11:
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

btw here's the correct orientation of the switch (note the little detent thing on one side), even though it seems weird it would work at all with it was upside down.

burnt-past, 2024-07-11:
Hey, Still I'm still at the same address!

Here is the thermal on the board. I swapped those out, and they ended up frying again.

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

Sorry for the potato photos. I need to figure out what's going on with my phone camera.  As far as I can tell, the components are all in the correct orientation.

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

burnt-past, 2024-07-11:
I assume it relates to the reset lines since the outputs get locked at 2V. But I'm not 100% sure; I don't have any experience with these ICs.

I'll have to depopulate those ICs next week, as I don't have time today. I'll let you know what the outcome is.

Thanks for sending out that replacement btw!

Here's the top view:

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

Closed 2024-09-21.

Thread 35 (2024-11-11):

Jumperless app firmware updater seems to have an error.

ReanimationXP, 2024-11-11:
There appears to be an issue with the firmware updater in Jumperless.exe.  I get the following output when running it, even as admin.  I suspect the error has something to do with 'ser.close()' on line 386 of JumperlessWokwiBridge.py.

`C:\Jumperless>Jumperless.exe

1: COM6 [USB Serial Device (COM6)]
2: COM7 [USB Serial Device (COM7)]

Autodetected Jumperless at COM6
Autodetected USB-Serial at COM7

 'menu'   to open the Bridge App menu
 'skip'   to disable Wokwi updates and just use as a terminal
 'update' to force firmware update - yours is up to date (1.3.17)
 'slots'  to assign Wokwi projects to slots (this menu)
    ^--   (you can enter these commands at any time)

  ENTER   to accept and go to Jumperless

      'x' to clear all slots
      'c' to clear a single slot

Enter the slot number you'd like to assign a project to:

slot 0
slot 1
slot 2
slot 3
slot 4
slot 5
slot 6
slot 7

slot > update

Would you like to update your Jumperless with the latest firmware? Y/n

Downloading latest firmware...
Traceback (most recent call last):
  File "JumperlessWokwiBridge.py", line 1244, in <module>
  File "JumperlessWokwiBridge.py", line 916, in assignWokwiSlots
  File "JumperlessWokwiBridge.py", line 452, in updateJumperlessFirmware
NameError: name 'ser' is not defined. Did you mean: 'set'?
[48448] Failed to execute script 'JumperlessWokwiBridge' due to unhandled exception!`

Architeuthis-Flux, 2024-11-11:
Interesting. Would you mind testing something for me? [Load an older version of the firmware](https://github.com/Architeuthis-Flux/Jumperless/releases/tag/1.3.14) (by holding boot, plugging it in, and dropping this file on the drive that pops up), then reopen the app and select Yes when it asks if you'd like to update the firmware.

I'll push a fix anyway, but I'm curious if it's a sequencing thing that happens when you force a firmware update versus letting it auto-update.

Thread 36 (2025-09-25):

[BUG] Jumperless.app/Contents/MacOs/Jumperless_cli either missing pieces or wrong architecture...

jwiede, 2025-09-25:
When executing Jumperless.app from icon, a shell window opens and displays the following:

```
/Applications/Jumperless.app/Contents/MacOS/Jumperless_cli
Traceback (most recent call last):
  File "JumperlessWokwiBridge.py", line 26, in <module>
  File "PyInstaller/loader/pyimod02_importers.py", line 419, in exec_module
  File "psutil/__init__.py", line 123, in <module>
  File "PyInstaller/loader/pyimod02_importers.py", line 419, in exec_module
  File "psutil/_psosx.py", line 15, in <module>
ImportError: dlopen(/Applications/Jumperless.app/Contents/Frameworks/psutil/_psutil_posix.abi3.so, 0x0002): tried: '/Applications/Jumperless.app/Contents/Frameworks/psutil/_psutil_posix.abi3.so' (mach-o file, but is an incompatible architecture (have 'arm64', need 'x86_64')), '/System/Volumes/Preboot/Cryptexes/OS/Applications/Jumperless.app/Contents/Frameworks/psutil/_psutil_posix.abi3.so' (no such file), '/Applications/Jumperless.app/Contents/Frameworks/psutil/_psutil_posix.abi3.so' (mach-o file, but is an incompatible architecture (have 'arm64', need 'x86_64'))
[5253] Failed to execute script 'JumperlessWokwiBridge' due to unhandled exception: dlopen(/Applications/Jumperless.app/Contents/Frameworks/psutil/_psutil_posix.abi3.so, 0x0002): tried: '/Applications/Jumperless.app/Contents/Frameworks/psutil/_psutil_posix.abi3.so' (mach-o file, but is an incompatible architecture (have 'arm64', need 'x86_64')), '/System/Volumes/Preboot/Cryptexes/OS/Applications/Jumperless.app/Contents/Frameworks/psutil/_psutil_posix.abi3.so' (no such file), '/Applications/Jumperless.app/Contents/Frameworks/psutil/_psutil_posix.abi3.so' (mach-o file, but is an incompatible architecture (have 'arm64', need 'x86_64'))
[5253] Traceback:
Traceback (most recent call last):
  File "JumperlessWokwiBridge.py", line 26, in <module>
  File "PyInstaller/loader/pyimod02_importers.py", line 419, in exec_module
  File "psutil/__init__.py", line 123, in <module>
  File "PyInstaller/loader/pyimod02_importers.py", line 419, in exec_module
  File "psutil/_psosx.py", line 15, in <module>
ImportError: dlopen(/Applications/Jumperless.app/Contents/Frameworks/psutil/_psutil_posix.abi3.so, 0x0002): tried: '/Applications/Jumperless.app/Contents/Frameworks/psutil/_psutil_posix.abi3.so' (mach-o file, but is an incompatible architecture (have 'arm64', need 'x86_64')), '/System/Volumes/Preboot/Cryptexes/OS/Applications/Jumperless.app/Contents/Frameworks/psutil/_psutil_posix.abi3.so' (no such file), '/Applications/Jumperless.app/Contents/Frameworks/psutil/_psutil_posix.abi3.so' (mach-o file, but is an incompatible architecture (have 'arm64', need 'x86_64'))
```

Seems as though some of the dependent, included so's are only in 'arm64' not full-on universal (with both arm64 & x86_64), specifically `_psutil_posix.abi3.so`.  This in turn causes any of the application launches to fail for either the main UI or WowkiBridge script.
