Architeuthis-Flux/Jumperless/Hardware/Custom Breadboard/BBclipsNEW/BBNew Drawing.pdf

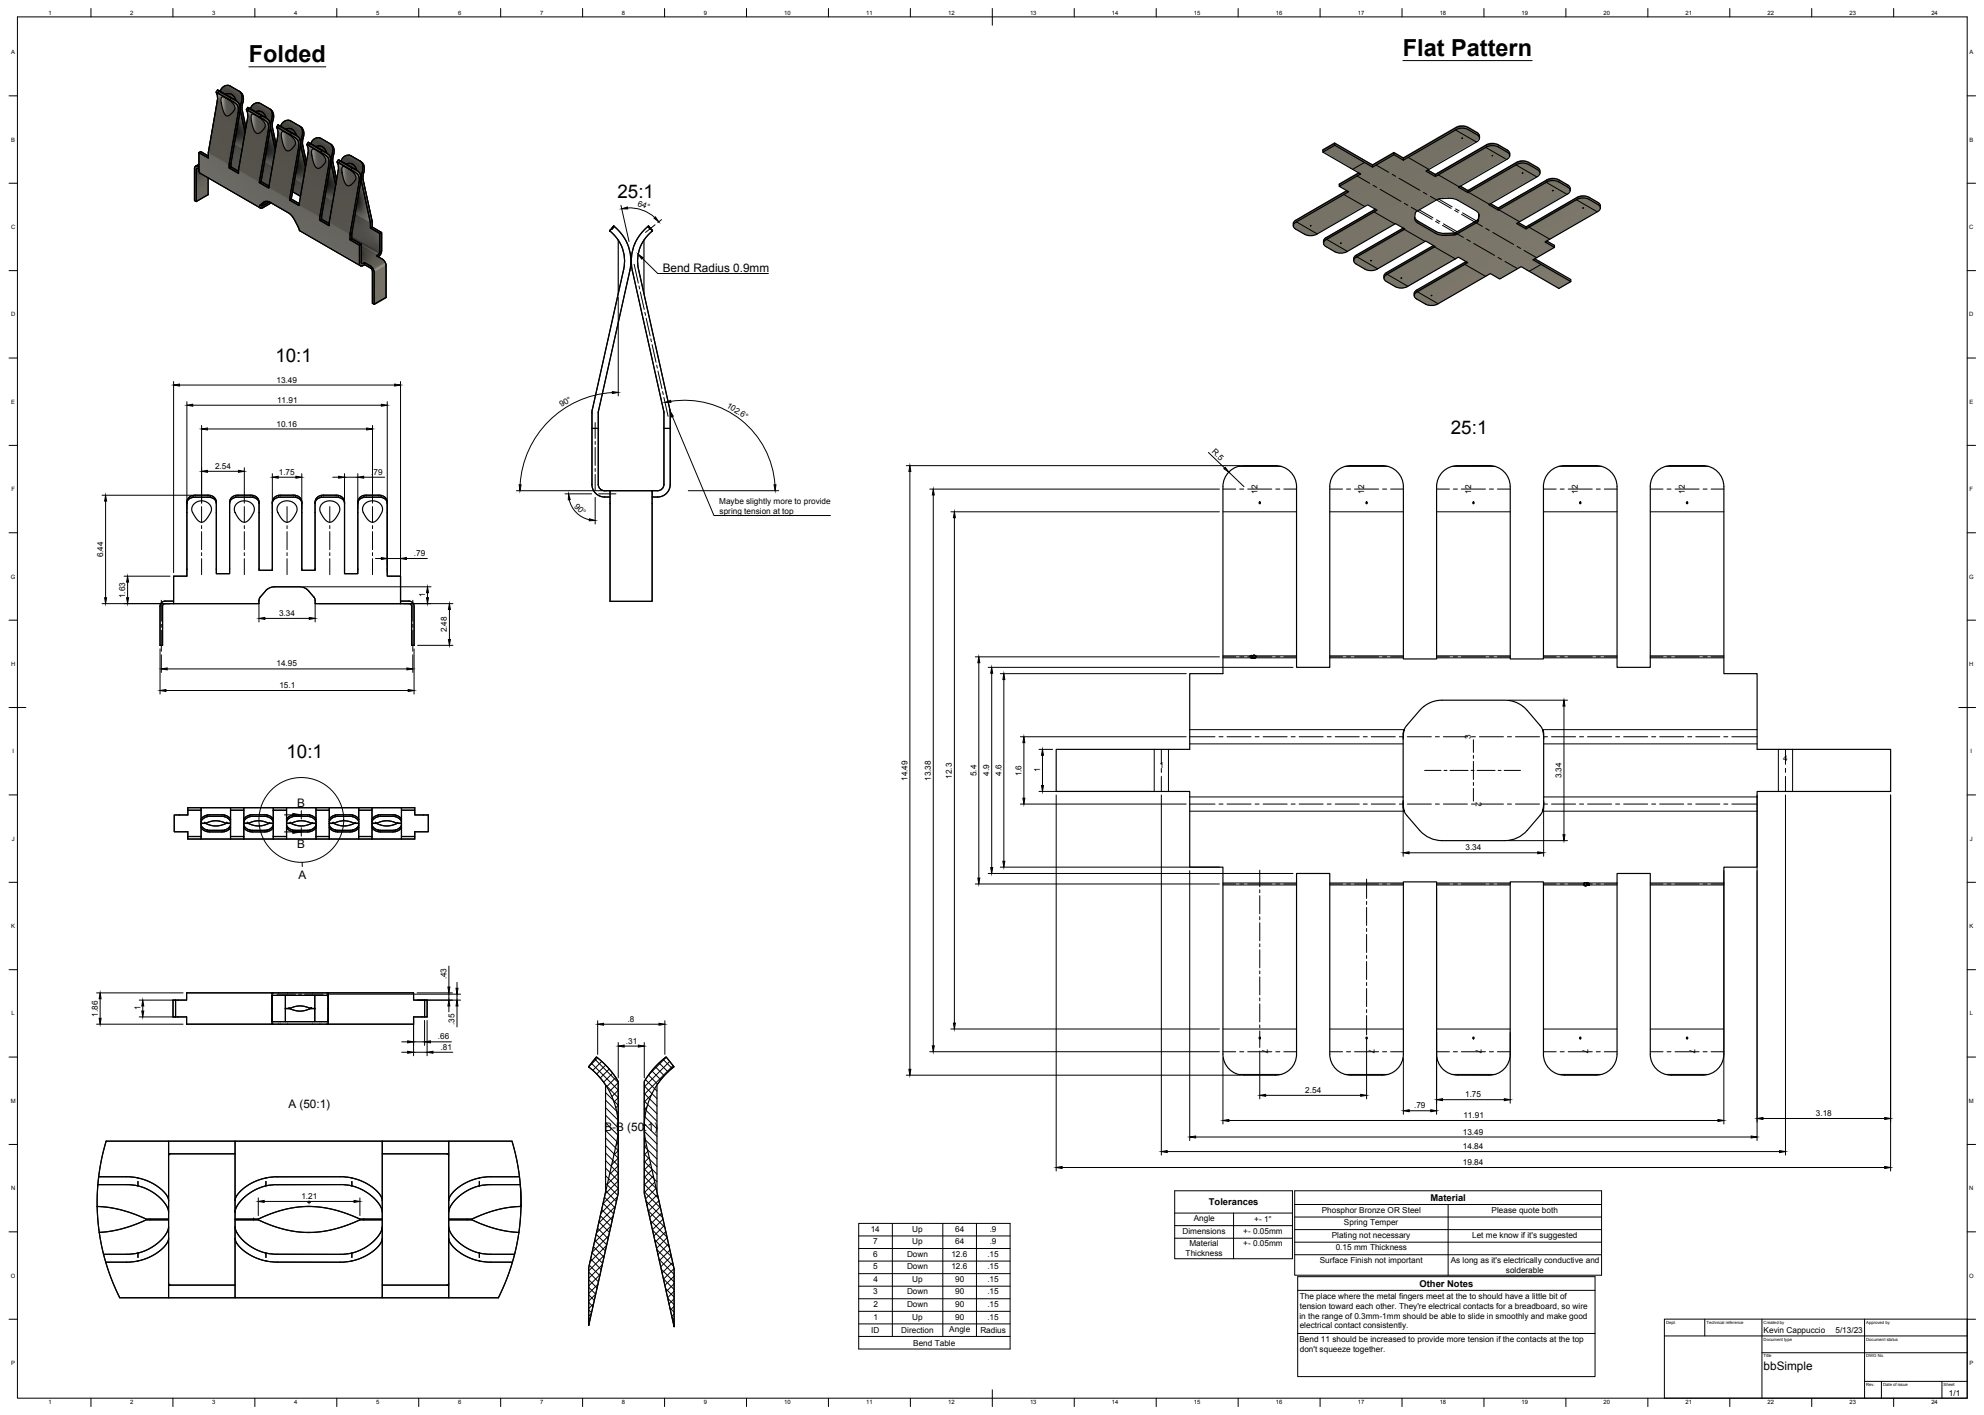
[picture p25: page 1]
24 BADCFEHGIKJMLONP; BADCFEHGIKJMLONP Dept.; Technical reference; Created by; Approved by Document type; Document status Title; DWG No. Rev.; Date of issue; Sheet 5/13/23; 1/1 bbSimple Kevin Cappuccio Folded 14.95 3.34 2.54

6.44 A A (50:1) BB B-B (50:1) .31.8 25:164° 90° Bend Radius 0.9mm Maybe slightly more to provide spring tension at top 25:1 10:1 Flat Pattern R.5

12.3 1.75 2.54 11.91 13.49 14.84 19.84 3.18 10:1 Bend Table ID Direction Angle Radius 1 Up 90 .15 2 Down 90 .15 3 Down 90 .15 4 Up 90 .15 5 Down 12.6 .15 6 Down 12.6 .15 7 Up 64 .9 14 Up 64 .9 Tolerances Angle +- 1° Dimensions +- 0.05mm Material Thickness +- 0.05mm Material Phosphor Bronze OR Steel Please quote both Spring Temper Plating not necessary Let me know if it's suggested 0.15 mm Thickness Surface Finish not important As long as it's electrically conductive and solderable Other Notes The place where the metal fingers meet at the to should have a little bit of tension toward each other. They're electrical contacts for a breadboard, so wire in the range of 0.3mm-1mm should be able to slide in smoothly and make good electrical contact consistently. Bend 11 should be increased to provide more tension if the contacts at the top don't squeeze together. 1.21 90° 102.6° 15.1 7
