Architeuthis-Flux/Jumperless/Hardware/KiCAD/Jumperless Rev 3/Schematic.pdf

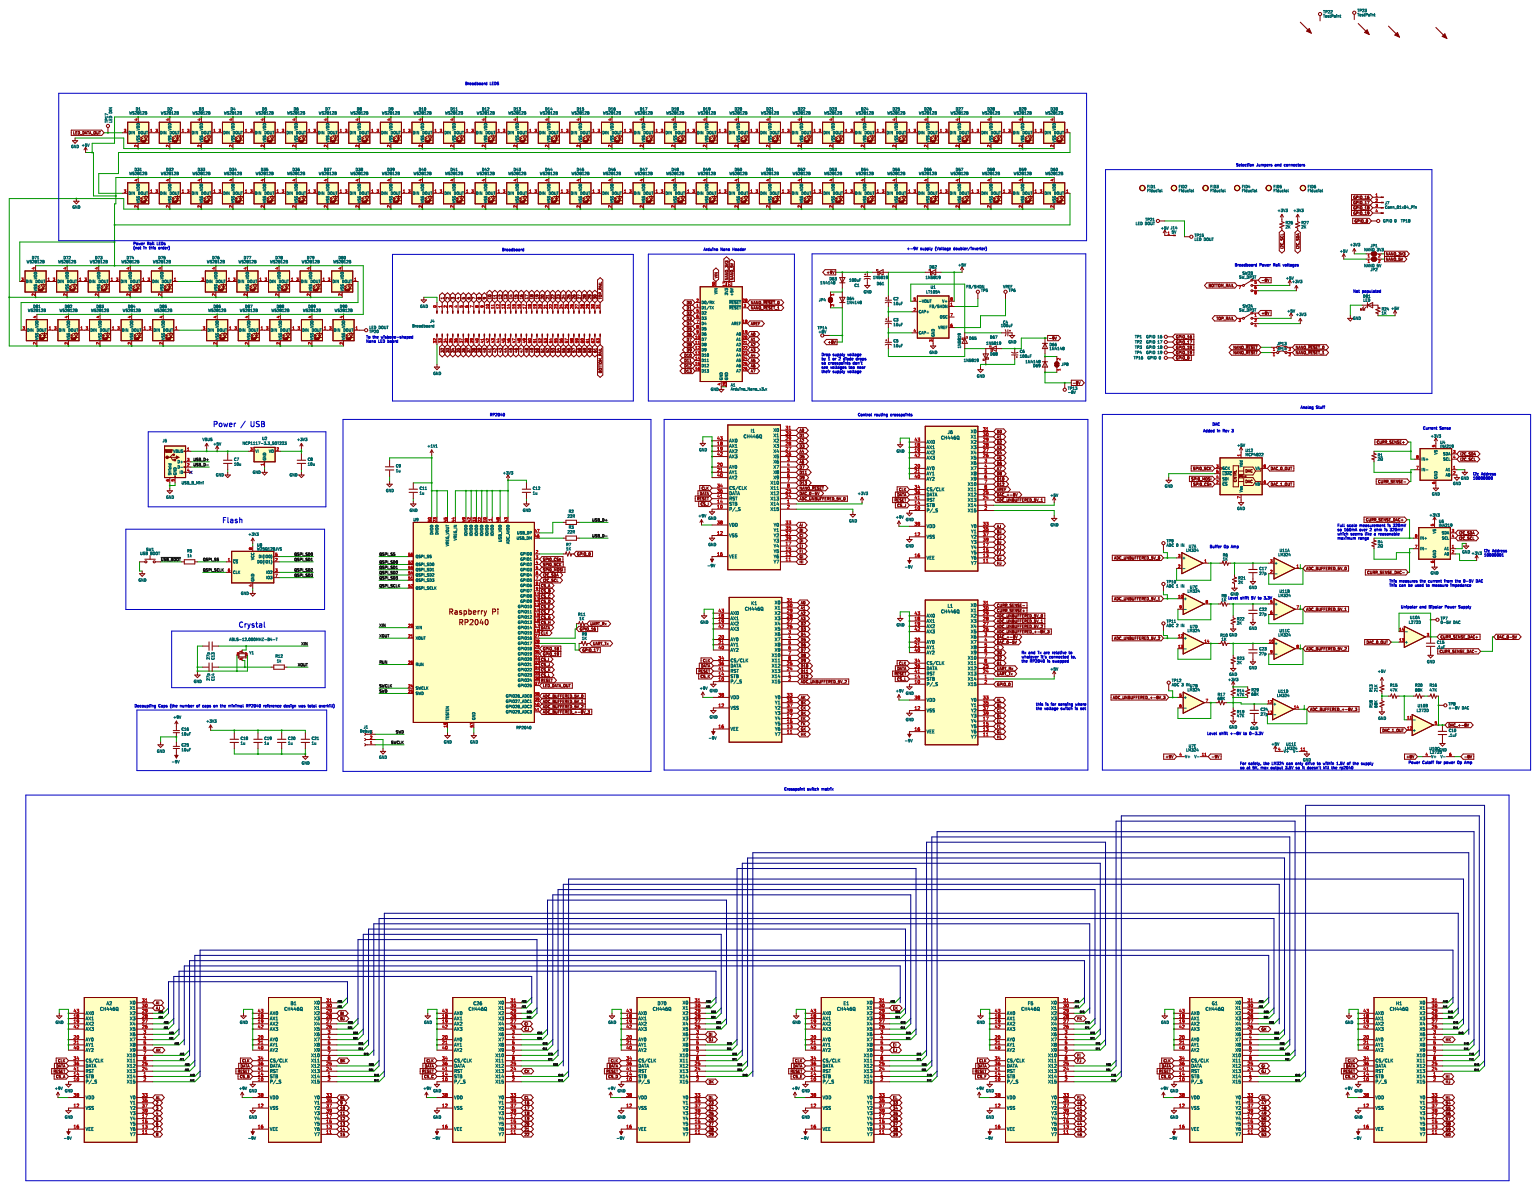
[picture p26: page 1]
