Architeuthis-Flux/Jumperless/Hardware/KiCAD/LED Board Rev 3/LEDboardRev3.kicad_pcb

## KiCad design Hardware/KiCAD/LED Board Rev 3/LEDboardRev3.kicad_pcb (2024-05-28)

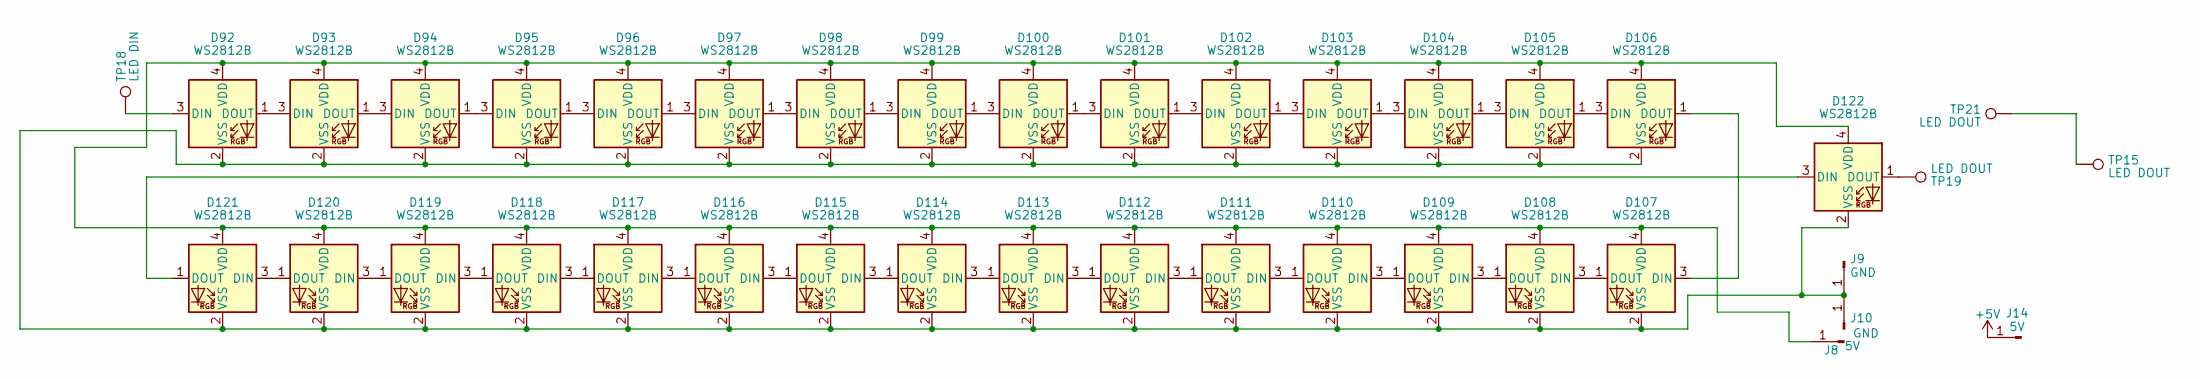
[picture p27: schematic LEDboardRev3.kicad_sch, LED Board Rev 3.1]

Parts:
D92, D93, D94, D95, D96, D97, D98, D99, D100, D101, D102, D103, D104, D105, D106, D107, D108, D109, D110, D111, D112, D113, D114, D115, D116, D117, D118, D119, D120, D121, D122: WS2812B; ws2812c-2020-noSolk
J8, J14: 5V; PINHEADER-1x1_vertical
J9, J10: GND; PINHEADER-1x1_vertical
TP15: LED DOUT; TestPoint_Pad_D1.0mm
TP18: LED DIN; PINHEADER-1x1_vertical
TP19, TP21: LED DOUT; PINHEADER-1x1_vertical

Connections:
unnamed: D92.3 (DIN), TP18.1
unnamed: D92.1 (DOUT), D93.3 (DIN)
unnamed: D93.1 (DOUT), D94.3 (DIN)
unnamed: D94.1 (DOUT), D95.3 (DIN)
unnamed: D95.1 (DOUT), D96.3 (DIN)
unnamed: D96.1 (DOUT), D97.3 (DIN)
unnamed: D97.1 (DOUT), D98.3 (DIN)
unnamed: D98.1 (DOUT), D99.3 (DIN)
unnamed: D99.1 (DOUT), D100.3 (DIN)
unnamed: D100.1 (DOUT), D101.3 (DIN)
unnamed: D92.4 (VDD), D93.4 (VDD), D94.4 (VDD), D95.4 (VDD), D96.4 (VDD), D97.4 (VDD), D98.4 (VDD), D99.4 (VDD), D100.4 (VDD), D101.4 (VDD), D102.4 (VDD), D103.4 (VDD), D104.4 (VDD), D105.4 (VDD), D106.4 (VDD), D107.4 (VDD), D108.4 (VDD), D109.4 (VDD), D110.4 (VDD), D111.4 (VDD), D112.4 (VDD), D113.4 (VDD), D114.4 (VDD), D115.4 (VDD), D116.4 (VDD), D117.4 (VDD), D118.4 (VDD), D119.4 (VDD), D120.4 (VDD), D121.4 (VDD), D122.4 (VDD), J8.1
unnamed: D92.2 (VSS), D93.2 (VSS), D94.2 (VSS), D95.2 (VSS), D96.2 (VSS), D97.2 (VSS), D98.2 (VSS), D99.2 (VSS), D100.2 (VSS), D101.2 (VSS), D102.2 (VSS), D103.2 (VSS), D104.2 (VSS), D105.2 (VSS), D106.2 (VSS), D107.2 (VSS), D108.2 (VSS), D109.2 (VSS), D110.2 (VSS), D111.2 (VSS), D112.2 (VSS), D113.2 (VSS), D114.2 (VSS), D115.2 (VSS), D116.2 (VSS), D117.2 (VSS), D118.2 (VSS), D119.2 (VSS), D120.2 (VSS), D121.2 (VSS), D122.2 (VSS), J9.1, J10.1
unnamed: D101.1 (DOUT), D102.3 (DIN)
unnamed: D102.1 (DOUT), D103.3 (DIN)
unnamed: D103.1 (DOUT), D104.3 (DIN)
unnamed: D104.1 (DOUT), D105.3 (DIN)
unnamed: D105.1 (DOUT), D106.3 (DIN)
unnamed: D106.1 (DOUT), D107.3 (DIN)
unnamed: D107.1 (DOUT), D108.3 (DIN)
unnamed: D108.1 (DOUT), D109.3 (DIN)
unnamed: D109.1 (DOUT), D110.3 (DIN)
unnamed: D110.1 (DOUT), D111.3 (DIN)
unnamed: D111.1 (DOUT), D112.3 (DIN)
unnamed: D112.1 (DOUT), D113.3 (DIN)
unnamed: D113.1 (DOUT), D114.3 (DIN)
unnamed: D114.1 (DOUT), D115.3 (DIN)
unnamed: D115.1 (DOUT), D116.3 (DIN)
unnamed: D116.1 (DOUT), D117.3 (DIN)
unnamed: D117.1 (DOUT), D118.3 (DIN)
unnamed: D118.1 (DOUT), D119.3 (DIN)
unnamed: D119.1 (DOUT), D120.3 (DIN)
unnamed: D120.1 (DOUT), D121.3 (DIN)
unnamed: D121.1 (DOUT), D122.3 (DIN)
unnamed: D122.1 (DOUT), TP19.1
unnamed: TP15.1, TP21.1

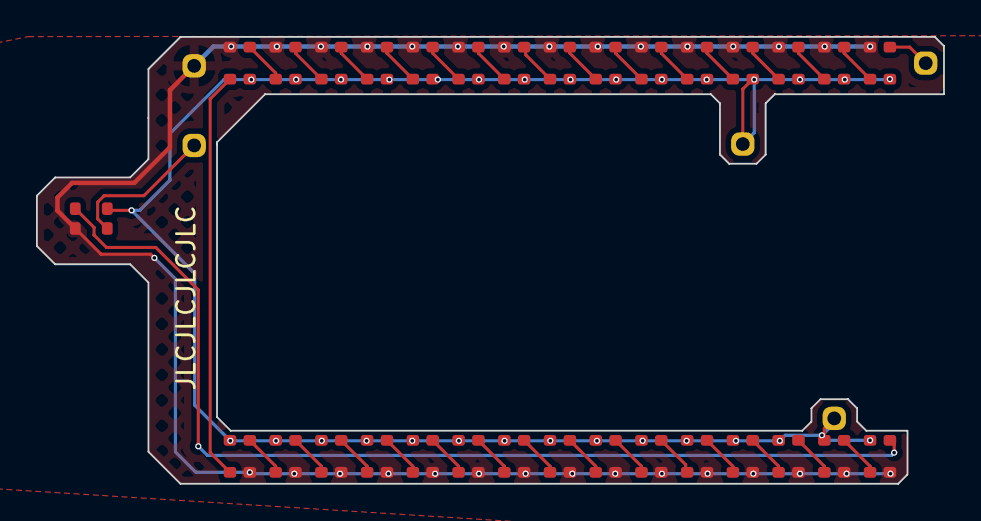
[picture p28: board LEDboardRev3.kicad_pcb from above]

Board: 2 copper layers, 50.4 x 24.8 mm, 36 parts (0 on the bottom side), 34 nets.
