Architeuthis-Flux/Jumperless/JumperlessNano/src/NetsToChipConnections.cpp

// SPDX-License-Identifier: MIT

#include <Arduino.h>
#include "JumperlessDefinesRP2040.h"
#include "MatrixStateRP2040.h"
#include "NetManager.h"
#include "NetsToChipConnections.h"
#include <EEPROM.h>

// don't try to understand this, it's still a mess

int startEndChip[2] = {-1, -1};
int bothNodes[2] = {-1, -1};
int endChip;
int chipCandidates[2][4] = {{-1, -1, -1, -1}, {-1, -1, -1, -1}}; // nano and sf nodes have multiple possible chips they could be connected to, so we need to store them all and check them all

int chipsLeastToMostCrowded[12] = {0, 1, 2, 3, 4, 5, 6, 7, 8, 9, 10, 11}; // this will be sorted from most to least crowded, and will be used to determine which chip to use for each node
int sfChipsLeastToMostCrowded[4] = {8, 9, 10, 11};                        // this will be sorted from most to least crowded, and will be used to determine which chip to use for each node
int bbToSfLanes[8][4] = {{0}};                                            // [Chip A - H][CHIP I-K] 0 = free  1 = used

int numberOfUniqueNets = 0;
int numberOfNets = 0;
int numberOfPaths = 0;

int powerPriority = 1;
int dacPriority = 1;
int powerDuplicates = 0;
int dacDuplicates = 0;
int pathDuplicates = 0;

int pathsWithCandidates[MAX_BRIDGES] = {0};
int pathsWithCandidatesIndex = 0;

int numberOfUnconnectablePaths = 0;
int unconnectablePaths[10][2] = {
    {-1, -1},
    {-1, -1},
    {-1, -1},
    {-1, -1},
    {-1, -1},
    {-1, -1},
    {-1, -1},
    {-1, -1},
    {-1, -1},
    {-1, -1},
};

unsigned long timeToSort = 0;

bool debugNTCC = EEPROM.read(DEBUG_NETTOCHIPCONNECTIONSADDRESS);

bool debugNTCC2 = EEPROM.read(DEBUG_NETTOCHIPCONNECTIONSALTADDRESS);

bool debugNTCC3 = false;
int pathIndex = 0;

void clearAllNTCC(void)
{
    startEndChip[0] = -1;
    startEndChip[1] = -1;
    bothNodes[0] = -1;

    bothNodes[1] = -1;

    numberOfUniqueNets = 0;
    numberOfNets = 0;
    numberOfPaths = 0;

    pathsWithCandidatesIndex = 0;
    pathIndex = 0;

    for (int i = 0; i < 12; i++)
    {
        chipsLeastToMostCrowded[i] = i;
    }
    for (int i = 0; i < 4; i++)
    {
        chipCandidates[0][i] = -1;
        chipCandidates[1][i] = -1;

        sfChipsLeastToMostCrowded[i] = i + 8;

        for (int j = 0; j < 8; j++)
        {
            bbToSfLanes[j][i] = 0;
        }
    }

    for (int i = 0; i < MAX_BRIDGES; i++)
    {
        pathsWithCandidates[i] = 0;
        path[i].net = 0;
        path[i].node1 = 0;
        path[i].node2 = 0;
        path[i].altPathNeeded = false;
        path[i].Lchip = false;
        path[i].sameChip = false;
        path[i].skip = false;

        for (int j = 0; j < 4; j++)
        {
            path[i].chip[j] = 0;
        }

        for (int j = 0; j < 6; j++)
        {
            path[i].x[j] = 0;
            path[i].y[j] = 0;
        }

        for (int j = 0; j < 3; j++)
        {
            path[i].nodeType[j] = BB;
            for (int k = 0; k < 3; k++)
            {
                path[i].candidates[j][k] = -1;
            }
        }
    }

    net[0] = {127, "Empty Net", {EMPTY_NET}, {{}}, EMPTY_NET, {}, {EMPTY_NET, EMPTY_NET, EMPTY_NET, EMPTY_NET, EMPTY_NET, EMPTY_NET, EMPTY_NET}, 0, 0};
    net[1] = {1, "GND", {GND}, {{}}, GND, {}, {SUPPLY_3V3, SUPPLY_5V, DAC0, DAC1}, 1, 0};
    net[2] = {2, "+5V", {SUPPLY_5V}, {{}}, SUPPLY_5V, {}, {GND, SUPPLY_3V3, DAC0, DAC1}, 1, 0};
    net[3] = {3, "+3.3V", {SUPPLY_3V3}, {{}}, SUPPLY_3V3, {}, {GND, SUPPLY_5V, DAC0, DAC1}, 0};
    net[4] = {4, "DAC 0", {DAC0}, {{}}, DAC0, {}, {GND, SUPPLY_5V, SUPPLY_3V3, DAC1}, 1, 0};
    net[5] = {
        5,
        "DAC 1",
        {DAC1},
        {{}},
        DAC1,
        {},
        {GND, SUPPLY_5V, SUPPLY_3V3, DAC0},
        1,
        0,
    };
    net[6] = {6, "I Sense +", {ISENSE_PLUS}, {{}}, ISENSE_PLUS, {}, {ISENSE_MINUS}, 2, 0};
    net[7] = {7, "I Sense -", {ISENSE_MINUS}, {{}}, ISENSE_MINUS, {}, {ISENSE_PLUS}, 2, 0};

    net[1].rawColor = rawSpecialNetColors[1];
    net[2].rawColor = rawSpecialNetColors[2];
    net[3].rawColor = rawSpecialNetColors[3];
    net[4].rawColor = rawSpecialNetColors[4];
    net[5].rawColor = rawSpecialNetColors[5];
    net[6].rawColor = rawSpecialNetColors[6];
    net[7].rawColor = rawSpecialNetColors[7];

    net[1].machine = false;
    net[2].machine = false;
    net[3].machine = false;
    net[4].machine = false;
    net[5].machine = false;
    net[6].machine = false;
    net[7].machine = false;

    for (int i = 8; i < MAX_NETS; i++)
    {
        net[i] = {0, " ", {}, {{}}, 0, {}, {}, 0, 0, 0, 0, false};
    }

    for (int i = 0; i < 12; i++)
    {
        for (int j = 0; j < 16; j++)
        {
            ch[i].xStatus[j] = -1;
        }

        for (int j = 0; j < 8; j++)
        {
            ch[i].yStatus[j] = -1;
        }
    }
    for (int i = 0; i < 10; i++)
    {
        unconnectablePaths[i][0] = -1;
        unconnectablePaths[i][1] = -1;
    }
    numberOfUnconnectablePaths = 0;
}

void sortPathsByNet(void) // not actually sorting, just copying the bridges and nets back from netStruct so they're both in the same order
{
    if (debugNTCC)
    {
        Serial.println("sortPathsByNet()");
    }
    timeToSort = micros();
    numberOfPaths = 0;
    pathIndex = 0;

    if (debugNTCC)
    {
        printBridgeArray();
    }

    numberOfNets = 0;
    for (int i = 0; i < MAX_NETS; i++)
    {
        if (net[i].number != 0 && net[i].number != -1)
        {
            numberOfNets++;
            // break;
        }
    }

    for (int i = 0; i < MAX_BRIDGES; i++)
    {

        if ((path[i].node1 != 0 && path[i].node2 != 0) || (path[i].node1 != -1 && path[i].node2 != -1))
        {
            numberOfPaths++;

            // break;
        }
        else if (path[i].node1 != -1 || path[i].node2 != -1)
        {
            break;
        }
    }
    // printPathArray();
    // if (debugNTCC)
    // {
    //     Serial.print("number of nets: ");
    //     Serial.println(numberOfNets);
    // }

    for (int j = 1; j <= MAX_NETS; j++)
    {

        if (net[j].number == 0)
        {
            break;
            // continue;
        }

        for (int k = 0; k < MAX_NODES; k++)
        {
            if (net[j].bridges[k][0] == 0)
            {
                break;
                // continue;
            }
            else
            {
                path[pathIndex].net = net[j].number;
                path[pathIndex].node1 = net[j].bridges[k][0];
                path[pathIndex].node2 = net[j].bridges[k][1];

                if (path[pathIndex].net == path[pathIndex - 1].net)
                {
                }
                else
                {
                    numberOfUniqueNets++;
                }

                if (debugNTCC)
                {
                    Serial.print("path[");
                    Serial.print(pathIndex);
                    Serial.print("] net: ");
                    Serial.println(path[pathIndex].net);
                }
                pathIndex++;
            }
        }
    }

    newBridgeLength = numberOfPaths;
    numberOfPaths = pathIndex;
    if (debugNTCC)
    {
        Serial.print("number unique of nets: ");
        Serial.println(numberOfUniqueNets);
        Serial.print("pathIndex: ");
        Serial.println(pathIndex);
        Serial.print("numberOfPaths: ");
        Serial.println(numberOfPaths);
    }

    clearChipsOnPathToNegOne(); // clear chips and all trailing paths to -1{if there are bridges that weren't made due to DNI rules, there will be fewer paths now because they were skipped}

    if (debugNTCC)
    {
        printBridgeArray();
        Serial.println("\n\r");
        timeToSort = micros() - timeToSort;
        Serial.print("time to sort: ");
        Serial.print(timeToSort);
        Serial.println("us\n\r");
    }
}
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
