Architeuthis-Flux/Jumperless/(commit log)

2023-05-25 New Hardware revision
    [Jumperless2.kicad_sch, JumperlessArduino.kicad_sch, MTpinRowTableNano.xlsx]
2023-05-31 LED stuff
2023-06-09 it finally jumps!
    added some PIO assembly to talk to the ch446qs
2023-06-24 New Hardware
    [Jumpeledard.step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]
2023-06-25 arduino stuff
2023-07-08 now running led stuff on core 2, and autodetection of ports
2023-07-20 fixed a few little things
    [ArduinoStuff.cpp, ArduinoStuff.h, CH446Q.cpp, CH446Q.h, LEDs.cpp, LEDs.h, Peripherals.cpp, Peripherals.h]
2023-08-06 LED brightness menu and more hardware files
    [Jumpeledard.step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]
2023-08-15 Fixed a routing Bug
    it wasn't making certain hop connections, should be fixed now
    [CH446Q.cpp, NetsToChipConnections.cpp, main.cpp]
2023-08-28 Fixed rev 2 support
    [Peripherals.cpp]
2023-09-06 Added LED testing menu
2023-09-06 fix LED menus a bit
    [LEDs.cpp]
2023-09-19 Fixed a bug where bounces wouldn't check for overlaps
    phew
    [CH446Q.cpp, MatrixStateRP2040.cpp, NetsToChipConnections.cpp, Peripherals.cpp, main.cpp]
2023-09-27 Fixed brightness menu
    removed annoying warnings
    [LEDs.cpp, NetsToChipConnections.cpp, main.cpp]
2023-10-28 Fixed routing for Special Function chips
    [JumperlessDefinesRP2040.h, LEDs.cpp, MatrixStateRP2040.h, NetsToChipConnections.cpp, Peripherals.cpp, main.cpp]
2023-10-31 Keep on fixin' shit
    [CH446Q.cpp, JumperlessDefinesRP2040.h, LEDs.cpp, LEDs.h, MatrixStateRP2040.cpp, MatrixStateRP2040.h, NetManager.cpp, NetsToChipConnections.cpp]
2023-11-16 Adjusting timing and delays to make things feel a bit snappier
    [CH446Q.cpp, main.cpp]
2023-12-06 Added Voltage/Current sensing interface
    toggle it on with 'v' in the main menu. You'll need the new Wokwi bridge app to connect the current sensor lines
2023-12-15 Fixed define collision with tusb_common.h so you won't need to edit the library
    [JumperlessDefinesRP2040.h, MatrixStateRP2040.cpp]
2023-12-15 Now the connections can be received from UART
2023-12-16 UART control polishing
2023-12-16 fixed parsing and arduino control
    [CH446Q.cpp, FileParsing.cpp, FileParsing.h, main.cpp]
2023-12-18 fixed an edge case routing bug
    [NetsToChipConnections.cpp, Peripherals.cpp, main.cpp]
2023-12-31 Fix build on case-sensitive filesystem
    [LEDs.cpp]
2023-12-31 Accepts ::lightnet for +-8V and header glow and stuff
2024-01-01 Add machine commands "getnetlist", "getbridgelist"
    - `::getnetlist[]`: prints the in a machine-readable way
    ```
    ::netlist-begin
    ::net[1,1,GND,true,001c04,false,GND]
    ::net[2,2,5V,true,1c0702,false,+5V]
    ::net[3,3,3V3,true,1c0107,false,+3.3V]
    ::net[4,4,DAC_0,true,231111,false,DAC 0]
    ::net[5,5,DAC_1,true,230913,false,DAC 1]
    ::net[6,6,I_POS,true,232323,false,I Sense +]
    ::net[7,7,I_NEG,true,232323,false,I Sense -]
    ::netlist-end
    ```
    - `::getbridgelist[]`: prints the bridge list in the `::bridgelist[...]` format
2024-01-03 Machine mode: respond to commands to signal success
    After processing a machine-mode instruction, respond with "::ok\r\n".
    This way the host side knows if an instruction was processed or not.
    Also instructions can carry an optional "sequence number" now, which
    will be echoed in the "ok" response.
    Example:
    ::lightnode:23[...]
    responds with:
    ::ok:23
    The sequence number can be used on the host side to synchronize
    specific function calls with their response.
    Unknown instructions respond with
    ::error
    instead.
    [MachineCommands.cpp, MachineCommands.h, main.cpp]
2024-01-03 left in a print
2024-01-06 machine-mode: getsupplyswitch
    SEND ::getsupplyswitch:1395[]
    REVC ::supplyswitch[5V]
    REVC ::ok:1395
    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
2024-01-12 Added brightness scaling so it doesn't melt when using Jumperlab
    [LEDs.cpp, LEDs.h, MachineCommands.cpp, MachineCommands.h, WokwiSketch.ino]
2024-01-12 Add "load last net" if connected to a power bank with no USB host
2024-01-15 Fixed a bunch of routing bugs
    [NetsToChipConnections.cpp, NetsToChipConnections.h, WokwiSketch.ino]
2024-01-29 Add Schematic with OSHW licenses
2024-02-01 Fixed delays so things run quicker and don't drop incoming characters
    [CH446Q.cpp, FileParsing.cpp, LEDs.cpp, MachineCommands.cpp, NetManager.cpp, NetsToChipConnections.cpp, Peripherals.cpp, WokwiSketch.ino]
2024-02-03 add canonical defines and an option to print the long or short versions
    [FileParsing.cpp, JumperlessDefinesRP2040.h, MachineCommands.cpp, MatrixStateRP2040.cpp, NetManager.cpp, NetManager.h, NetsToChipConnections.cpp, Peripherals.cpp]
2024-02-13 Probing almost works for now it just prints what it touched. Added scaling up for Jumperlab.
2024-02-15 Continously sample ADCs and expose them via USB HID
2024-02-16 Add custom class driver, instead of using HID
2024-02-16 Probing is it's own file and works on the nano header, fixed routing bugs, keep track of unconnected paths
    [CH446Q.cpp, CH446Q.h, JumperlessDefinesRP2040.h, MachineCommands.cpp, MachineCommands.h, NetsToChipConnections.cpp, NetsToChipConnections.h, Probing.cpp]
2024-02-18 rewrote probing
    [Jumperless2-B_Cu.gbl, Jumperless2-B_Fab.gbr, Jumperless2-B_Mask.gbs, Jumperless2-B_Paste.gbp, Jumperless2-B_Silkscreen.gbo, Jumperless2-Edge_Cuts.gm1, Jumperless2-F_Cu.gtl, Jumperless2-F_Fab.gbr]
2024-02-19 Better probing menu, disambuguation of shorted rows, add a flag to swap probe/button pins
    [FileParsing.cpp, JumperlessDefinesRP2040.h, LEDs.h, Probing.cpp, Probing.h, main.cpp]
2024-02-19 add a double button press timer
2024-02-20 Fix node file clear and restore, make disambiguation a different color
    [Probing.cpp, main.cpp]
2024-02-20 Add voltage selection to probing, more colors on status led
2024-02-24 Added footpint and font files, took out spaces from folder names
    [PEC11R-4215F-S0024--3DModel-STEP-56544.STEP, SSSS223600.step, WS2812C-2020_Color.step, bbSimple v1.step, bbSimple v8.step]
2024-02-25 Remove backups so the repo is less huge
    [JumperlessRev1-B_Cu.gbl, JumperlessRev1-B_Mask.gbs, JumperlessRev1-B_Paste.gbp, JumperlessRev1-B_Silkscreen.gbo, JumperlessRev1-Edge_Cuts.gm1, JumperlessRev1-F_Cu.gtl, JumperlessRev1-F_Mask.gts, JumperlessRev1-F_Paste.gtp]
2024-03-06 Pulldown button pin so you can put an LED on the probe
2024-03-14 Added KiCAD and Producion Files for Rev3.1
    [JumperlessBOMWithLCSCPNs.xls, JumperlessRev3point1.kicad_sch, bom.csv, designators.csv, positions.csv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]
2024-05-27 Added Rotary Encoder Mode and multiple saved slots
    [JumperlessBOMWithLCSCPNs 2.xls, bom 2.csv, designators 2.csv, positions 2.csv, positions.csv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]
2024-05-28 Added contact info and stuff to be super duper open source
    [JumperlessBOMWithLCSCPNs 2.xls, JumperlessRev3point1.kicad_sch, LEDboardRev3.kicad_pcb, LEDboardRev3.kicad_sch, bom 2.csv, designators 2.csv, positions 2.csv]
2024-05-31 New Wokwi Bridge app
    [config.txt]
2024-06-19 I broke something in the last release, this should fix it
    [FileParsing.cpp, FileParsing.h, JumperlessDefinesRP2040.h, LEDs.cpp, Probing.cpp, main.cpp]
2024-11-21 The janky example address incrementer doesn't clear between addresses
    [main.cpp]
2024-11-22 fixed not clearing connections between Wokwi updates
    [FileParsing.cpp, main.cpp]
2025-02-12 Added 'ack' to recieving connections from arduino (see examples), Allow you to just read the probe with 'j'
